FallenFireGit/F405-FC/review/gate-0-power-reaudit-2.md

# Gate 0 re-audit 2 (third round): F405-FC power design

Auditor: fresh, independent Gate 0 power re-auditor, 2026-10-11. I did not write either earlier report. I did not modify any
other file and did not commit.

**Audited:** `design/power.md` (whole file, with a focus on 0, 2.1-2.2, 3.4, 4, 7-9, 12, 13 and 14), `design/decisions.md` (D-03, D-07,
D-11, D-12, D-14, D-16), the power parts of `design/circuit.py` (lines 44-74 and 203-278, plus the 3V3 decoupling, J3/R41, D4 and
D7-D9 at lines 296-461), the committed netlist `kicad/F405FC.net` (power nets only), the U4 and 3V3 cap positions in
`kicad/F405FC.kicad_pcb`, and `gen/power_calc_lmr.py`. The netlist matches circuit.py for every refdes I checked (C1-C24, C29, R41,
D4/D5/D7/D8/D9/D10).

**Method:** I extracted `lp38692.pdf`, `lp5907.pdf`, `lmr38020.pdf` and `JST_SH_eSH.pdf` with `pdftotext -layout` into the scratchpad.
`JST_SH_eSH.pdf` is image-only, so no text came out. Nothing from `datasheets/` was executed. I parsed the netlist and PCB with my own
`python3 -I` snippets and recomputed the thermal arithmetic with `scratchpad/calc/r3.py`. That script uses the same loss model as
`gen/power_calc_lmr.py` (RDS hot ×1.45, 10 ns edges, 30 mW drive, IRMS²·DCR + 50 mW core), adds a dropout branch, and charges the
3V3 domain as 4.76 V × I(3V3) (LDO drop plus the loads). Anything I could not check against a document on file is marked
**unverified**.

## Sources

| Ref | Document | Used for |
|---|---|---|
| [LP38] | TI LP38692 SNVS322M, `datasheets/lp38692.pdf` | 8.2.1 Table 1 (COUT 1 µF, ESR 5-500 mΩ); 8.2.2.2.2 (ESR 5-500 mΩ "for stability"); 8.2.2.2.4 (0.7 µF minimum effective; a 1 µF ceramic is typically 20-40 mΩ); EC header (CIN = COUT = 10 µF); 10.4 (loop bandwidth < 100 kHz; above that, only the output caps set the output impedance; inductance between COUT and the load is recommended) |
| [LP59] | TI LP5907 SNVS798Q, `datasheets/lp5907.pdf` | 5.6 "Output and Input Capacitors" (COUT 0.7-10 µF effective). The thermal table is 5.4, not 5.6 |
| [LMR] | TI LMR38020 SNVSC40E, `datasheets/lmr38020.pdf` | 7.5 (IHS-LIMIT 2.6/3.2/3.8 A, ILS-LIMIT 1.8/2.3/2.8 A); 8.3.8 (hiccup, 76 ms); Eq. 7 |
| Not on file | Yageo RC0805 jumper ratings, JST SH current rating (the PDF is an image), USBLC6-2 VBUS clamp, Samsung DC-bias curves, SMBJ26A, Würth WE-MAPI, DS8626 | Claims that rest on these are marked unverified |

## Disposition of open findings

| ID | Prev. sev | Disposition | Evidence |
|---|---|---|---|
| P1-01 | MAJOR | **RESOLVED.** The residual consistency gaps are downgraded to MINOR as P2-01 and P2-02 | (a) The bench envelope is now "VTX off or pit mode, LED strip off, cameras allowed" (power.md:441-442). At **typical** loads it fits ≤ 1 W (recomputed 0.86-0.93 W). At the design-budget loads it does not (P2-01). (b) The 3V3 domain is now in P_board (power.md:424-425, 405-406). (c) The gate is ambient-referenced and runs at 2S and 6S (power.md:446-449). (d) The -T7 option is withdrawn and the 85 C sensors are named (power.md:443-444; decisions.md:98-99). (e) The "104 C" headline is gone from power.md:38-39, D-03 (decisions.md:35) and R2 (power.md:497). The 12.5 rows check out: R_board-air = 1/(h·2·12.96 cm²) = 38.6/25.7/9.6/4.8 K/W for h = 10/15/40/80. Rows 1-5 (power.md:429-433) reproduce to ±1 C from the stated P_board and P_U1. With the 12.2 per-component losses, my recomputed worst-case P_board is 3.27 W (6S) and 3.58 W (2S), against the stated 3.9 W. So the table is conservative (see P2-06) |
| P1-02 | MINOR | **RESOLVED** | power.md:215-216 now defers to R7 ("25 V output capacitors may be overstressed"). The sentence is garbled: "(R7). (The TPS22810 is gone), and HD VTXs…" (INFO, P2-07) |
| P1-03 | MINOR | **RESOLVED** | R41 0R 0805 sits between 10V and the new net VTX_PWR → J3.1 (circuit.py:430-436). In the netlist, VTX_PWR = {J3.1, R41.2} and 10V includes R41.1. D-16 is at decisions.md:119-122 and power.md:190 says "Remove R41" for 2S HD builds. The current rating is in P2-05 |
| P1-04 | MINOR | **Mostly RESOLVED; residual folded into P2-04** | Fixed: (a) power.md:487-488 now lists D4/D5/D9 as PMEG4030ER and D7/D8 as BAT54S-7-F, matching circuit.py:421, 447-461. (c) The LDO COUT is CL10A225KO8NNNC in both power.md:274 and circuit.py:256 (C20). (d) The LP5907 COUT is CL10B225KO8NNNC X7R in both power.md:287 and circuit.py:264 (C23). (e) The C4u7 string is fixed. Residual: power.md §1.2 refdes (P2-04) |
| P0-03 | MINOR | **OPEN (MINOR), one line left** | power.md:32-37, 132 and 174 now qualify the nominal 1.96-2.20 A and 2.11-2.13 A figures and state the ≥ 1.87 / ≥ 1.78 A floors. decisions.md:36 (D-03) still reads "give a **guaranteed** 1.96-2.20 A (5 V) and 1.97-2.13 A (10 V)", which contradicts decisions.md:38 and power.md:34-35. Tracked in P2-04 |
| P0-04 | MINOR | **RESOLVED (numbers)**; residual INFO P2-07 | power.md:126-127 now gives regulation down to 6.25-6.4 V at 1.8 A. I recompute 6.27-6.41 V for DMAX 0.963/0.943 with RDS,HS,hot + DCR = 0.514 Ω, and the doc's 4.76-4.87 V at 6.0 V, ±0.03 V. power.md:127 says the script models 100 % duty and that the 97 % figures are authoritative. Not done: `gen/power_calc_lmr.py` is unchanged since f0e1ac8 (100 % duty; "R~5 ohm" comment at its end), and power.md:6 still says "All rev B numbers come from gen/power_calc_lmr.py" |
| P0-05 | MINOR | **RESOLVED / ACCEPTED-DEVIATION (D-14)**; (b) stays unverified (INFO) | (a) D-07 (decisions.md:68) now says TPD2E2U06 is **not** acceptable. (c) Inrush is logged as D-14 (decisions.md:105-109; power.md:314-317). My recount from the current netlist: VBUS 1 µF, 5V_SYS 6.7 µF, 3V3 12.6 µF (C20 2.2 + C29 4.7 + C47 4.7 + 10 × 0.1), 3V3A 1.1 µF, 3V3_IMU 4.71 µF ≈ **26 µF / ≈ 97 µC** nominal. That is still above 10 µF / 50 µC, so D-14's "≈ 30 µF / 110 µC" is slightly high but reaches the same conclusion. (b) The USBLC6 VBUS clamp level against the LP5907's 6 V abs max is still **unverified**: no PDF on file |
| G1P-01 | MINOR | **ACCEPTED-DEVIATION (D-14)** | As P0-05(c). power.md:314-317 no longer claims compliance |
| G1P-02 | MINOR | **RESOLVED as requested** (power.md 7 corrected, bring-up load-step check added at power.md:274-277). The new rationale is physically wrong: **P2-03 (MINOR)** | The circuit now has a single 2.2 µF X5R at the LDO (C20, circuit.py:256), and the old C21 100 nF is retired (circuit.py:257). [LP38] 8.2.2.2.2/8.2.2.2.4: ≥ 1 µF (0.7 µF effective), ESR 5-500 mΩ, so C20 alone complies. The 3V3 net still carries C29 and C47 (2 × 4.7 µF X5R) and 10 × 100 nF |
| G1P-03 | MINOR | **RESOLVED** | circuit.py:70 now reads "4.7uF X5R 16V" for CL10A475K**O**8NNNC. Netlist C18/C29 agree |
| G1P-04 | MINOR | **Partly RESOLVED; residual OPEN (MINOR) as P2-04** | Fixed: LDO caps (power.md:274, 287), VBAT R_bot 0402 (power.md:331), §13 refdes for D4/D5/D9, D7/D8 and C4/C12. Still wrong: §1.2 (power.md:103-104). §3.2/§13 do not reflect the C17 change. R41 is missing from §13 (P2-04) |

Carried INFO items from earlier rounds: P0-14 (no GPS series resistors; logged in D-15) and P1-05 (U12 Ioff, unverified) are
unchanged. P0-16 is unchanged: power.md:110 says "35 V min" bulk against the 42.1 V clamp, and power.md:148 says 5.28 V is "inside
WS2812 VDD max 5.3 V". P0-17/G1P-07 is still missing from §14: R7 covers only the U2 high-side short, not the U1 short that would put
VBAT onto 5V/5V_SYS/LP5907. P1-06 is RESOLVED (power.md:414-415). G1P-05 is RESOLVED (C39 = CL10B225, circuit.py:346). G1P-06 is
RESOLVED in the circuit (C17 = 100 nF 100 V X7R 0603, circuit.py:237, netlist C17), but the doc lags (P2-04).

## Checks of the revisions that passed

| Item | Evidence | Result |
|---|---|---|
| 12.5 arithmetic | R_board-air 25.7-38.6 K/W still air, 4.8-9.6 K/W in flight (doc: 25-38 / 5-10). Row 1: 3.9 W → 19-38 K, T_board 69-88 C, U1 +26 C → 95-114 C (doc 70-89 / 96-115). Row 2: 3.0 W → 14-29 K (doc 15-30). Row 3: 2.0 W → 10-19 K (doc 10-20). Row 4: 1.0 W at 25 C → 51-64 C (doc 50-63). Row 5: 1.9 W → 49-73 K (doc 48-72). My independent "HD VTX 1 A + LED off" bench case is 1.96 W | PASS (rounding only) |
| Hot-day envelope equivalences (power.md:440) | Recomputed P_board: LED ≤ 0.4 A → 3.04 W (2S) / 2.85 W (6S); VTX ≤ 1.2 A → 3.16 W (2S) / 2.94 W (6S). Both are within about 0.15 W of 3.0 W, which is inside the model's uncertainty, and the doc's 3.9 W baseline is conservative | PASS (INFO in P2-06) |
| Gate arithmetic | MCU case − Ta ≤ 30 K → ≤ 80 C at Ta 50 C; U1/U2 case − Ta ≤ 50 K → ≤ 100 C at Ta 50 C (power.md:446-449). Covers 2S (U2 in dropout) and 6S | PASS (consistency with the envelope: P2-02) |
| LP38692 single 2.2 µF COUT | [LP38] 8.2.2.2.2: ≥ 1 µF, ESR 5-500 mΩ. 2.2 µF 16 V X5R 0603 at 3.3 V keeps well over 0.7 µF effective (DC-bias curve **unverified**). Load transients: the loop bandwidth is < 100 kHz ([LP38] 10.4), so steps are carried by the whole 3V3 bank (≈ 12.6 µF nominal), not by C20 alone. A 100 mA step for 5 µs gives about 50 mV, which is acceptable | PASS on value. See P2-03 for the stability argument |
| LP5907 COUT | C23 2.2 µF X7R + C38/C40-C42 + C39 2.2 µF X7R = 4.71 µF nominal on 3V3_IMU, inside 0.7-10 µF ([LP59] 5.6) | PASS |
| R41 dissipation | Yageo RC jumper maximum 50 mΩ (**unverified**, no Yageo PDF): 1.5² × 0.05 = 0.11 W in an 0805. In a VTX short, U2 is valley-limited (ILS max 2.8 A + ΔIL/2, [LMR] 7.5/Eq. 7) and then hiccups (76 ms off, [LMR] 8.3.8), so overcurrent through R41 is brief | PASS (rating unverified; the contact limit is in P2-05) |
| C17 | 100 nF 100 V X7R 0603 GRM188R72A104KA35D on 10V (netlist C17) | PASS |
| Abs-max and back-feed states | Unchanged from the earlier round apart from R41 (series 0R on a 10V branch: no new path). With R41 removed, VTX_PWR floats and J3.1 cannot tie VBAT to 10V | PASS |

## New findings (P2-xx)

| ID | Sev | Finding | Evidence | Fix |
|---|---|---|---|---|
| P2-01 | MINOR | **The "≤ 1 W" bench rule is met only at typical loads, not at the loads the bench envelope allows.** The envelope allows VTX off, LED off and "cameras allowed". At the design budget (3V3 0.17 A, RX 0.15 A, 2 cams 0.4 A, GPS 0.1 A) I recompute P_board = **1.38 W (2S) / 1.40 W (6S)**: U1 0.28-0.30, L1 0.10, 3V3 domain 0.86, D5 0.11. Still air gives a rise of 36-54 K, so T_board is **61-79 C at Ta 25 C** and reaches 85 C at Ta ≈ 31 C at the upper estimate. At typical loads (3V3 0.125 A, RX 0.08 A, ≤ 1 camera) it is 0.86-0.93 W, which matches the 1.0 W row. This is not a rating violation at Ta 25 C, but the rule and the row disagree | power.md:39, 432, 441-442; decisions.md:97-99; scratchpad `calc/r3.py` | Either state the bench rule as "≤ 1.4 W at budget loads, Ta ≤ 30 C" or restrict the bench envelope (e.g. one camera, or cameras off on HD builds). Say that the 1.0 W row uses typical loads |
| P2-02 | MINOR | **The gate and the envelope assume different ambients.** The gate (full load, 3 m/s fan) passes only if MCU case − Ta ≤ 30 K, which is the condition for full load at **Ta 50 C**. The envelope already limits full load to Ta ≤ 35 C, where a rise of up to about 39-45 K would be acceptable, and limits Ta 35-50 C to P_board ≤ 3.0 W. The doc's own upper estimate at 3 m/s (h ≈ 40, 9.6 K/W) predicts a **37.6 K** rise at 3.9 W (my recompute: 31-35 K at 3.3-3.6 W). So the model predicts the gate will fail, and the prescribed response, "lower the LED-strip budget until it passes", would cut the full-load budget even for Ta ≤ 35 C, where the envelope says it is fine. The gate also never tests the 3.0 W hot-day point. This errs on the conservative side; there is no safety hole | power.md:421-422, 429-430, 439-449 | Make the gate two-point. (1) Full load: MCU case − Ta ≤ 45 K (≤ 80 C at Ta 35 C). (2) At the 3.0 W hot-day configuration: MCU case − Ta ≤ 30 K. Or keep the single criterion and change the envelope to "full load up to Ta 50 C if the gate passes". On failure, adjust the envelope's ambient split before cutting the budget |
| P2-03 | MINOR | **The LP38692 stability rationale in power.md 7 is not physically valid, and there is no fallback if the bring-up check fails.** power.md:274-277 argues that the remaining 3V3 decoupling is "≥ 10 mm away behind trace inductance". At the regulator's loop crossover (< 100 kHz, [LP38] 10.4), 10-15 mm of trace or plane is a few nH, which is about 3-6 mΩ at 100 kHz. That is negligible next to the caps' reactance, so the loop still sees the whole ≈ 12.6 µF bank, including C29 and C47 (2 × 4.7 µF X5R, low single-digit mΩ ESR). The aggregate-ESR situation G1P-02 described is therefore unchanged; C47 was in fact added since then (G1S-04). Removing the 10 µF only removed local transient reserve. The claim "no other capacitor within ~10 mm" is also untrue on the current PCB: C26 (100 nF, F.Cu) is 2.7 mm from U4. Mitigating: TI's own EC conditions use COUT = 10 µF ceramic ([LP38] EC header), so instability is unlikely. The bring-up load-step check stays the only control, and the board has no option to fix a failure without a respin | power.md:274-277; circuit.py:256, 301, 368; PCB: U4 (124.6, 107.0) B.Cu, C20 6.3 mm, C26 2.7 mm, C47 12.6 mm, C29 20.0 mm; [LP38] 8.2.2.2.2, 10.4 | Rewrite the rationale. The real arguments are that TI characterises the part with a 10 µF ceramic, and that trace or plane **resistance** (not inductance) adds some ESR to the remote caps. Make the 10-150 mA step test a pass/fail bring-up item, and either add a DNP 0402 footprint for a 0.1-0.47 Ω series R ahead of the remote bulk (C29/C47) or log the residual risk in decisions.md |
| P2-04 | MINOR | **Remaining doc/refdes drift between power.md and circuit.py (the source of truth), plus one stale "guaranteed".** (a) power.md:103 "C2+C2b / C3+C3b": the netlist has C2, C3 (U1) and C10, C11 (U2); there are no "b" refdes. (b) power.md:104 "C4 / C5" for the 100 V HF caps: they are C4 and C12, and C5 is U1's 16 V BOOT cap. (c) After the G1P-06 change, the 10 V HF output cap is C17 100 nF **100 V 0603**, but power.md:178 still says "100 nF 0402 HF", and §13 (power.md:474, 476) lists the 100 V part with qty 2 (C4, C12) and "Cboot, HF out" 16 V 0402 with qty 4. The correct counts are 3 (C4, C12, C17) and 3 (C5, C13, C9). (d) R41 (0R 0805 RC0805JR-070RL), a new part in the 10 V power path, is missing from §13. (e) decisions.md:36 (D-03) still says "guaranteed 1.96-2.20 A … 1.97-2.13 A" (P0-03 residual) | as cited; netlist C2/C3/C10/C11/C4/C12/C5/C9/C13/C17/R41 | Regenerate §1.2/§3.2/§13 from circuit.py; reword D-03 line 36 as "nominal (≥ 1.87 / ≥ 1.78 A worst case)" |
| P2-05 | MINOR | **J3 pin 1 (and so R41) is limited by the JST-SH contact, not by R41's 2 A.** power.md:222 rates a JST-SH power pin at 1 A (the JST PDF on file is image-only, so this is **unverified** here). The 10 V rail budget is 1.5 A (power.md:376), and D-03 says "typical HD VTXs draw 0.8-1.2 A at 10 V" (decisions.md:38). An HD VTX above 1 A on the stock harness overloads the J3 contact. R41's "0R 2A" value (circuit.py:47) rests on the Yageo RC0805 jumper rating, which is not on file (**unverified**). Neither power.md §5, §13 nor D-16 states the J3 current limit | circuit.py:47, 430-436; power.md:222, 227, 376; decisions.md:38, 119-122 | State in power.md §5/§12.1 and in the user guide that J3 pin 1 is good for ≤ 1 A, and that VTXs above 1 A must be wired to P3/P4 (10V/GND pads). Add the Yageo RC jumper datasheet to `datasheets/` at Gate 2 |
| P2-06 | INFO | **12.3/12.5 P_board decomposition double-counts the LDO drop and takes 3V3 loads at typical values.** power.md:405 includes the LDO's 0.25 W in the 3.3 W power-stage figure, and power.md:425 adds a "3V3 domain ≈ 0.5-0.6 W" that again includes "the LDO drop (0.25 W)". At budget the 3V3 domain is 4.76 V × 0.18 A ≈ 0.86 W. The errors roughly cancel: the corrected worst case is 3.27-3.58 W, against the stated 3.9 W, so the table stays conservative | power.md:405-406, 424-425 | Restate it as power stage (excluding the LDO) ≈ 3.05 W + 3V3 domain (including the LDO) ≈ 0.86 W |
| P2-07 | INFO | **Stale or loose text.** (a) D-12 (decisions.md:97) "3.3 W worst-case loss": the board total is now 3.9 W. (b) R8 (power.md:506-507) asks to "confirm the 5 V rail's case temperature on the bench at 1.8 A", which conflicts with the bench rule; it should point to the fan gate. (c) power.md:394-395 (12.2: "effective RθJA … nearer 43 C/W", "every case below 150 C") reads as a conclusion; label it as large-board only. (d) power.md:6 says all numbers come from the script, which contradicts power.md:127; the script's "R~5 ohm" comment is still not a datasheet value. (e) power.md:287 cites LP5907 "section 5.4" for the COUT range; it is 5.6 ([LP59]). That line also omits C39 (2.2 µF) from the IMU-side sum (still 4.71 µF ≤ 10 µF). (f) power.md:215-216 sentence is garbled. (g) D-14's 30 µF / 110 µC is now ≈ 26 µF / 97 µC. (h) R41's 0.11 W is not in P_board (negligible). (i) The "bring-up guide" is referenced throughout but does not exist yet; the gates and checks in 12.5, 7 and 3.4 need to be carried into it | as cited | Clean up in the next doc pass |
| P2-08 | INFO | **Still unverified (no document on file):** Yageo RC0805 jumper current and resistance; the JST-SH contact rating; the USBLC6-2 VBUS clamp level against the LP5907's 6 V; Samsung DC bias for C20 (CL10A225KO8NNNC) at 3.3 V; SMBJ26A; Würth Isat/DCR; DS8626 thermal ratings | — | Add the PDFs and close at Gate 2 |

## Not verified (explicitly)

- Everything in P2-08. I did not run KiCad ERC, regenerate the schematic or run `design/circuit.py`. I used the committed
  `kicad/F405FC.net` and `kicad/F405FC.kicad_pcb` (commit bf896ee); the netlist matches the circuit.py refdes I checked.
- PCB distances are centre-to-centre footprint origins, not pad-to-pad, taken from the committed PCB (HEAD). While this audit ran,
  uncommitted work in progress moved U4 (placement.py:134). I re-measured on the working tree: C20 6.8 mm, C26 2.5 mm, C47 11.6 mm,
  so the P2-03 conclusions are unchanged. The same WIP also changed the HSE load caps in circuit.py/decisions.md D-07, which is
  outside the power scope. I did not check copper routing or thermal-via presence.
- The 12.5 thermal model and my recompute are estimates. Only the bring-up gate can validate them.

## Verdict

**PASS**: 0 BLOCKER and 0 MAJOR open. P1-01 (MAJOR) is resolved; its residual consistency gaps are MINOR (P2-01, P2-02).
P1-02, P1-03, G1P-03 and P0-04 (numbers) are resolved. P0-05 and G1P-01 are closed as the accepted deviation D-14. G1P-02 is
resolved as requested but has a MINOR follow-up (P2-03).

Open MINOR items: P0-03 (one line, folded into P2-04), G1P-04 (folded into P2-04), P2-01, P2-02, P2-03, P2-04 and P2-05.
Open INFO items: P2-06, P2-07, P2-08, P0-14, P0-16, P0-17/G1P-07 and P1-05.
