FallenFireGit/F405-FC/review/gate-0-power-audit.md

# Gate 0 audit: F405-FC power design (rev B)

Auditor: independent Gate 0 power review, 2026-10-11
Audited: `design/power.md` (rev B), `gen/power_calc_lmr.py`. Checked against `design/requirements.md`, `design/decisions.md`
(accepted deviations D-03, D-04, D-06) and `design/pinmap.md` rev C sections 6-7.
I did not modify the author's files. Every number marked "recomputed" comes from my own script
(`scratchpad/calc/audit.py`, not committed). It was run with `python3 -I`, and nothing from `datasheets/` was executed.

## Sources

| Ref | Source | How used |
|---|---|---|
| [LMR] | TI LMR38020 SNVSC40E (Sep 2023), `datasheets/lmr38020.pdf` (pdftotext) | 7.1 abs max, 7.3, 7.4 thermal, 7.5 EC, 7.6 (DMAX footnote), 8.3.3, 8.3.6, 8.3.8 (Eq. 7, IL-NEG), 8.4.2, 8.4.3, 9.1 note (effective C), 9.2.2.4-9.2.2.8, Table 8-1, Table 9-1 |
| [LP38] | TI LP38692 SNVS322M, `datasheets/lp38692.pdf` | 6.1 (12 V abs max), 6.3 (Tj op 125 C), 6.4 (RθJA 68.5, ψJB 12.8), 6.5 dropout, 8.1.1, 8.2.2.2 |
| [LP59] | TI LP5907 SNVS798Q, `datasheets/lp5907.pdf` | 5.1 (VIN abs max 6 V), 5.3/5.4 (COUT 0.7-10 uF eff., ESR 5-500 mΩ) |
| [PMEG] | Nexperia PMEG4030ER, `datasheets/PMEG4030ER.pdf` | Table 6 (Rth 130 K/W at 1 cm²), char. table (VF 295/330 mV at 0.1 A, 380/440 mV at 1 A, IR) |
| [PMV] | Nexperia PMV40UN2, `datasheets/PMV40UN2.pdf` | VGS(th) 0.4-0.9 V, RDSon 44 mΩ at 4.5 V / 53 mΩ at 2.5 V max, VGS ±12 V |
| [NX] | Nexperia NX7002AK, `datasheets/NX7002AK.pdf` | VGS(th) 1.1-2.1 V, RDSon 5.2 Ω max at VGS 5 V (no 3.3 V spec), Ciss 20 pF max, VDS 60 V |
| [TS5A] | TI TS5A3159A, `datasheets/TS5A3159A_DS.pdf` | 6.1: VI (digital) -0.5..6.5 V regardless of V+, analog pins ≤ V+ + 0.5 V; VIH 2.4 V at V+ 5 V |
| [BF] | Betaflight 4.5 `sound_beeper.c:85`, `drv_pinio.c:51-71` | beeper and PINIO polarity |
| [WE] | Würth WE-MAPI 74438357068 / 74438357082 datasheets. **I could not read them directly** (we-online.com: DNS failure in WebFetch, proxy 403 in curl). Figures come from web-search result snippets of `we-online.com/components/products/datasheet/74438357068_valid_from_2026-09-01.pdf` and `.../74438357082.pdf`, plus RS/Octopart listings | Isat (flagged unverified) |
| Not on file | Littelfuse SMBJ26A PDF, DS8626 (STM32 IINJ), Murata/Samsung DC-bias curves, Würth PDFs | Claims that depend on these are marked unverified |

## Verification results (passed, with recomputed numbers)

The design script `python3 -I gen/power_calc_lmr.py` ran cleanly. Its output matches the tables in `power.md` 2.x, 3.x and 12.2.

| Item | Recomputed | Verdict |
|---|---|---|
| RT / fSW | Eq. 2: 34.53 k → 34.8 k is the Table 8-1 value for 750 kHz. EC: 430-650 kHz at 49.9 k (−18 %/+24 %), plus ±8 % SS → 565-1003 kHz | PASS |
| tON-min foldback | 5 V at 42.1 V: tON = 162 ns > 131 ns at nominal f. At fmax 1003 kHz, foldback starts at 38.9 V, which is benign (frequency drops) | PASS (power.md:118 "no foldback below 51.9 V" holds only at nominal f; INFO) |
| tOFF-min foldback | Eq. 6: 5 V 6.60 V, 10 V 13.02 V (tOFF 300 ns max) | PASS |
| Eq. 11 sub-harmonic | LMIN 1.71 uH (5 V), 3.36 uH (10 V). At fmin 565 kHz: 2.26 / 4.46 uH, still below L−20 % = 5.44 / 6.56 uH | PASS |
| Ripple / peak (nominal) | 5 V: 0.31 A at 7.4 V, 0.80 A at 25.2 V (K = 0.40 of 2 A). 10 V: 0.66 A at 16.8 V, 0.98 A at 25.2 V (K = 0.49). Ipk at budget: 2.20 A (5 V, 6S), 1.99 A (10 V, 6S). Worst tolerance (L−20 %, fmin): 2.46 / 2.32 A | PASS against the 9.2.2.4 hard rule (Isat ≥ full-load peak). K for 10 V is above TI's 20-40 % guideline: INFO |
| Output caps | Table 9-1 gives **rated** values: 5 V, 400 kHz: 3 × 22 uF nominal / 2 × 22 min; 1 MHz: 2 × 22 / 2 × 15. Design has 3 × 22 uF rated on each rail, which meets or exceeds this. 12 V row: 1 × 22 (400 kHz). Ripple ≈ ΔIL/(8 f C) ≈ 3-6 mV | PASS (effective-C figures 14 uF/9 uF per part are unverified; no Samsung curve on file) |
| FB dividers | 5 V: 100 k/24.3 k → 5.115 V (4.958-5.276 V incl. ±1 % R and ±1.5 % FPWM VREF). 10 V: 100 k/11.0 k → 10.091 V (9.76-10.43 V) | PASS |
| EN / UVLO | VON 4.41/5.01/5.61 V, VOFF 3.81/4.41/4.89 V (min/typ/max). Internal VIN UVLO 4.2 V start is below VON max | PASS |
| EN abs max (VIN + 0.3 V) | EN = 0.249 × VIN in every state (6.28 V at 25.2 V, 10.50 V at 42.1 V). **USB-only (VIN = 0): EN = 0** (resistive divider, and Q2 only pulls down; its body diode clamps EN ≥ −0.7 V). Q2 on: sinks 140 uA at 42.1 V, so EN < 0.95 V for any RDS < 6.8 kΩ. NX7002AK VGS(th) max 2.1 V against a 3.3 V gate leaves enough overdrive for 140 uA. Q2 VDS ≤ 10.5 V (60 V rating), VGS 3.3 V (±20 V) | PASS. The power.md:192 claim "< 5 Ω at VGS = 3.0 V" is not a datasheet number ([NX] specifies only 5.2 Ω max at 5 V), but the circuit has three orders of magnitude of margin |
| VTX_PWR_EN polarity | Gate pulldown 100 k → Q2 off → U2 on through reset/DFU/boot. BF `pinio_config 1 = 1` (OUT_PP, not inverted) → `IOLo` at init ([BF] drv_pinio.c:66-70) → VTX on. USER1 → high → VTX off | PASS (matches pinmap.md:269 and D-04) |
| BEEPER polarity | PB2 10 k pulldown → silent. `beeper_inversion = ON` → `IOWrite(io, onoff)` → high = on ([BF] sound_beeper.c:85). PMV40UN2: 53 mΩ max at 2.5 V, so it is fully on from 3.3 V. 0.53 mW at 0.1 A. Flyback clamps to 5V + VF | PASS |
| CAM_SEL | 100 k pulldown → CAM1. TS5A3159A VIH 2.4 V at V+ = 5 V (3.3 V GPIO meets it). IN abs max 6.5 V **independent of V+**, so it is safe when the switch is unpowered | PASS (supply rail unspecified, P0-13) |
| TVS vs parts on VBAT | VC 42.1 V (JEDEC table; SMBJ26A PDF not on file): LMR38020 VIN/SW 85 V, C1-C3 50 V, C4/C5 100 V, RENT 0603, VBAT divider, Q2 sees only EN (10.5 V). The 35 V transient requirement is met because VBR is 28.9-31.9 V | PASS (SMBJ26A values unverified locally) |
| VBAT ADC | ratio 11, full scale 36.3 V. Injection at 42.1 V: 0.25 mA. R_top 52 mW at 25.2 V | PASS (±5 mA IINJ from DS8626 is not on file: unverified) |
| CURR/RSSI | VBAT mis-wire: 2.16 mA through BAT54S, 47 mW in the 10 k. RC 1.59 kHz | PASS |
| LP38692 | Abs max 12 V, op VIN 10 V. Dropout at 3.3 V: 110 mV max at 0.1 A, 1000 mV max at 1 A → about 0.26 V at 0.25 A. P = 0.25 W at 0.17 A → Tj 67 C (68.5 C/W, JEDEC) | PASS for the device. Board heating: see P0-01 |
| LP5907 | 5V_SYS max = 5.28 V − VF ≈ 5.0-5.1 V, below 5.5 V op / 6 V abs. COUT 2.2 uF 0603 within 0.7-10 uF eff. 15 mW | PASS (steady state; transient see P0-05) |
| USB OR-ing / back-feed | D5 blocks USB → 5V → L1 → HS body diode → VBAT. D4 blocks battery → VBUS. With VIN = 0 the only path into the buck side is D5 reverse leakage (µA-scale), which is harmless. FPWM reverse current (IL-NEG −0.9 A, [LMR] 8.3.8/8.4.2) needs an output pulled above set-point. D5 prevents the on-board USB source from doing that, and when U2 is disabled it does not switch. VBUS 4.40 V (USB 2.0 low-power min) → 5V_SYS ≈ 4.07 V → LDO input ≥ 3.6 V OK | PASS |
| D5 thermal | 0.41 A × ~0.34 V = 0.14 W × 130 K/W = +18 C | PASS (at the stated Ta; board heating see P0-01) |
| Battery current | 6S worst: 1.06 A (doc 1.05). 2S at 7.4 V: 2.95 A (doc 2.9). 2S at 6.0 V with a 2 A VTX peak: 3.8 A | PASS (the doc is internally inconsistent, P0-10) |
| Power-entry pads (D-06) | 2.5 × 4 mm pads with 20-22 AWG, ≥ 1.5 mm 1 oz outer traces → adequate for 3.8 A | PASS |
| 5 V budget arithmetic | 0.41 + 0.80 + 0.40 + 0.10 + 0.08 = 1.79 A (includes the dropped OSD's 72.5 mA, so it is conservative) | PASS |
| Hot-plug (battery) | All VBAT parts are rated ≥ 50 V. EN tracks VIN resistively. Soft start 4 ms + OCP blanking 18 ms ([LMR] 8.3.9) | PASS. The external low-ESR bulk recommendation is appropriate |
| First power-up smoke check | I found no abs-max violation in the normal states: battery-only, USB-only, battery + USB, VTX off, reset/DFU | PASS |

## Findings

| ID | Sev | Finding | Evidence | Fix |
|---|---|---|---|---|
| P0-01 | **MAJOR** | **The thermal analysis does not support the "worst-case Tj 104 C" claim used to justify D-03.** (a) It applies a single-IC JEDEC RθJA (42.9 C/W, a 76 × 114 mm 2s2p board) to each IC separately, so the two ICs on a 36 × 36 mm board never heat each other. The doc's own board total is about 3.3 W. Board-level still-air estimate: 2 faces × 13 cm² × h 12-18 W/m²K (convection + radiation) gives **21-32 C/W board-to-ambient, so ΔT_board ≈ 70-106 C at 3.3 W**. Then Tj(U1) ≈ 50 + 70…106 + ψJB 13.8 × 1.26 ≈ **137-173 C (TSD 163 C)**, and the board itself reaches about 120-156 C. That exceeds the STM32F405RG**T6** 85 C ambient grade, the flash/IMU ratings and the LP38692's 125 C operating Tj. (b) The U2 **dropout loss on 2S/3S is omitted**: 1.5² × 0.303 × 1.45 ≈ 0.97 W (12.2 lists only 4S/6S for 10 V). (c) Switching loss assumes tr + tf = 10 ns total with no Coss, dead-time or Qrr term. For an 80 V-class integrated stage switching 25-42 V, 20 ns total is equally plausible: +0.17 W (6S) / +0.29 W (42 V) for U1. Coss at 100-200 pF adds 0.05-0.10 W. The RDS hot factor of 1.45 is reasonable for a typical Tj of 110-125 C (≈ 0.45 %/C), but it is applied to **typical** RDS (no max in the datasheet) | power.md:360-374, 385-386; decisions.md:34; power_calc_lmr.py:6, 9, 32 (TEDGE), 22-25 (no dropout loss); [LMR] 7.4, 9.2.2.9 ("values in Thermal Information are not valid for design purposes"); [LP38] 6.3 | State the airflow assumption explicitly: full budget only with prop-wash/forced air. Define a no-airflow budget (ground idle / bench, e.g. VTX in pit mode, LED ≤ 0.3 A) and put it in the user notes. Redo 12.2 as a board-level estimate (Pboard × Rboard + ψJB × Pic) including U2 dropout and a 20 ns edge sensitivity case. Make the Gate 1/bring-up thermal measurement (R8) a **pass/fail gate** at 1.8 A + 1.5 A on 2S and 6S. Optionally lower fSW to 400-500 kHz (a smaller switching term; L/C remain within Eq. 11 and Table 9-1) |
| P0-02 | **MAJOR** | **Requirement gap with no accepted deviation: the 10 V rail cannot reach 10 V on 2S or low 3S.** The requirements specify a 2-6S input (6.0-25.2 V) and a 10 V HD-VTX rail. D-03 accepts only the **current** derating. Recomputed with DMAX = tON-MAX/(tON-MAX + tOFF-MIN) = 0.943-0.963 ([LMR] 7.6 note 2): regulation needs **VIN ≥ 11.3-11.5 V** at 1.5 A. VOUT = **6.2-6.35 V at 7.4 V** and **7.2-7.3 V at 8.4 V** (full 2S), which is below the DJI O3's 7.4 V minimum even on a fully charged 2S pack. power.md 3.4 calls this a "documented limitation" but it is not in decisions.md | requirements.md:19-20; decisions.md D-03 (lines 30-40); power.md:174-179 | The lead must either log a deviation ("10 V rail regulates only for VIN ≥ 11.5 V; 2S HD-VTX unsupported") or add a hardware option: e.g. a solder jumper or DNP 0R from VBAT to the VTX connector/10V pad for 2S builds (with U2 EN held off), or a buck-boost |
| P0-03 | MINOR | **The Eq. 7 "guaranteed" output currents ignore L (±20 %), fSW (−18/+24 %) and spread spectrum (±8 %).** Worst-tolerance recomputation: 5 V **1.87-1.90 A** (2S / 42 V; the doc says 1.96-2.20) against the 1.79 A budget, a margin of only 0.08-0.11 A. 10 V at 25.2 V is limited by HS-limit-min minus ripple to **1.78 A** (1.57 A at the 42 V clamp), so D-03's "~2 A peak" and power.md's "1.97 A guaranteed floor" are not guaranteed. EC note 2: the limits are tested open loop | power.md:17, 33-35, 165, 355; decisions.md:35-37; [LMR] 7.5 (FOSC, ILS, IHS, note 2), Eq. 7 | Quote worst-case figures. Drop "2 A peak" or qualify it as "typical". Keep the 1.5 A continuous budget, which still holds (1.78 A) |
| P0-04 | MINOR | **Dropout model ignores DMAX** (it assumes 100 % duty). The 5 V rail holds regulation only down to **6.25-6.37 V** (doc 5.9 V) and gives 4.76-4.87 V at 6.0 V. The 10 V numbers are in P0-02 (doc 10.8 V / 6.6 V / 7.7 V) | power_calc_lmr.py:22-25; power.md:119-120, 175-177; [LMR] 7.6 note 2, 8.4.3 | Use VOUT ≈ DMAX·VIN − I·(D·RHS + (1−D)·RLS + DCR) with DMAX = 0.943 (tOFF max) |
| P0-05 | MINOR | **USB VBUS: capacitance and hot-plug transient.** D4 is forward-biased at plug-in, so the 5V_SYS bulk (10 uF) + LDO input caps, and through the LDOs the 3V3 network, all load VBUS. That is well over the 10 uF limit the doc itself states. There is no VBUS transient clamp. USB-cable hot-plug ringing on a 1 uF VBUS can overshoot well above 5.5 V, and the LP5907 (6 V abs max) sits only one Schottky drop downstream. The alternate ESD part TPD2E2U06 has no VBUS clamp at all | power.md:299, 269; decisions.md D-07 (USB ESD alternates); [LP59] 5.1 | Add a VBUS TVS/clamp sized so 5V_SYS stays < 6 V. Either accept and document the USB inrush non-compliance or limit 5V_SYS bulk. Pick the ESD part with a VBUS clamp |
| P0-06 | MINOR | **Input capacitance per IC is marginal.** [LMR] 9.2.2.6 requires ≥ 4.7 uF, and 9.1 says the values are **effective**. The doc's own estimate for the local 10 uF/50 V 1210 is about 4.5 uF at 25 V (less at a 42 V transient or when hot), so each IC relies on the shared entry cap C1. Murata DC-bias data is not on file | power.md:101-102; [LMR] 9.1 note, 9.2.2.6 | Use 2 × 10 uF/50 V 1210 per IC in the hot loop (or add a 2.2 uF/100 V), and keep C1 |
| P0-07 | MINOR | **Inductor Isat is not verified, and the "HS limit at or below Isat" claim is wrong under the usual 10 % definition.** Würth datasheet figures, from search snippets only (PDF not reachable): 74438357068 Isat(10 %) **3.5 A typ**, Isat(30 %) 7.2 A, IR 3.75 A, RDC 74 mΩ max. 74438357082 Isat(10 %) **3.35 A typ**, Isat(30 %) 6.8 A, IR 3.45 A, 86 mΩ. IHS-LIMIT max is 3.8 A, above Isat(10 %). Metal-alloy soft saturation makes this acceptable: worst full-load peak 2.46 / 2.53 A < 3.35 A, which meets the [LMR] 9.2.2.4 hard rule. D-05 and the BOM ratings (3 A / 2.8 A) disagree with the Würth PDF | power.md:126-128, 163-164, 411-412; decisions.md:52-54; [LMR] 7.5 IHS, 9.2.2.4 | Obtain the Würth PDFs at Gate 2 and confirm L at 3.8 A (≥ ~80 % of nominal). Correct the text and BOM ratings |
| P0-08 | MINOR | **The R7 residual-risk text is wrong:** a U2 high-side short puts VBAT (25.2 V; transients to the 42.1 V clamp) on the 10 V output caps, which are **25 V X5R**. "No on-board part can be damaged" (R7) is false (FB is OK at 4.17 V) | power.md:168, 199-200, 443; decisions.md:48 | Use 35/50 V caps on the 10 V rail (1210 or more parts), or correct R7 |
| P0-09 | MINOR | **The reverse-polarity statement is incomplete.** A reversed pack drives VIN to −VF(TVS) (volts at fault current), which violates the LMR38020 VIN abs min of −0.3 V. Current also flows GND → LS body diode → SW → HS body diode → VIN in **both** bucks, so they are likely destroyed along with the TVS, and the 5 V/10 V rails are pulled to about −0.7 V into every load. The requirements do not require reverse protection, but the doc says only the TVS is the casualty | power.md:90-91; [LMR] 7.1 | Correct the text. Optionally add a P-FET/ideal-diode at the input (not required) |
| P0-10 | MINOR | **Stale or inconsistent documentation in power.md and pinmap.md:** pinmap.md:54 says "PC15 = VTX_PWR_EN into the TPS22810 EN" and :55 "No … FET gates … on PC13-15", which contradicts rev C/D-04 (PC15 now drives Q2's gate). pinmap.md:94 calls the BEEPER FET "2N7002 class" (power.md uses PMV40UN2 and rejects 2N7002). power.md sections 0, 7 and 12 still budget the **AT7456E** (dropped, D-01). power.md:79 says "65 V IC" (TPS54360B leftover). power.md:214 says the 2S worst case is 3.6 A but :397 says 2.9 A. power.md:195 says Ciss "30-50 pF" ([NX]: 20 pF max). power.md:192 gives an RDS(on) "< 5 Ω at 3.0 V" that the datasheet does not specify | as cited | Clean up in the next revision. Polarity tables (pinmap §6) are correct |
| P0-11 | INFO | 10 V ripple K = 0.49 at 25.2 V and 0.62 at the clamp, above TI's 20-40 % guideline (9.2.2.4: use the device's 2 A). It is harmless here because the peak stays under Isat and ripple is about 6 mV | [LMR] 9.2.2.4 | None, or 10 uH |
| P0-12 | INFO | LP38692 COUT ESR window is 5-500 mΩ ([LP38] 8.2.2.2.2). A 10 uF 0805 X5R in parallel with the whole 3V3 decoupling network can sit at or below 5 mΩ. TI's own EC conditions use 10 uF ceramic, so the risk is low | power.md:262 | Bench-check 3V3 load-step ringing at bring-up |
| P0-13 | INFO | **The TS5A3159A V+ rail is not specified** in power.md or pinmap.md. IN is safe unpowered ([TS5A] 6.1). Analog pins must stay ≤ V+ + 0.5 V | decisions.md D-01; pinmap.md:68 | Specify V+ = 3V3 (always present with the MCU) |
| P0-14 | INFO | USB-only back-power: MCU UART TX/I2C pull-ups (3V3) feed the unpowered GPS (5V rail, G0-03), HD VTX (10 V off) and ESC MCUs through their input ESD diodes. Limited to mA, which is common practice, but the GPS can partly wake and stream into USART3 during DFU | pinmap.md:117, G0-03 | Optional series resistors (1 k) on GPS TX/RX; note it in bring-up |
| P0-15 | INFO | Battery hot-plug before 3V3 is up: PC0 injects ≤ 2.5 mA (25.2 V/10 k) into the unpowered VDD for the ~5-8 ms start-up. This is inside the claimed ±5 mA (DS8626 not on file) | power.md:88, 310-314 | None |
| P0-16 | INFO | The 5 V upper tolerance of 5.28 V is 20 mV under WS2812 VDD max 5.3 V before load-step overshoot. "Battery path wins" (power.md:139, 289) does not hold for VBUS ≥ 5.1 V, which is harmless. If the user powers the FC only via the ESC JST harness, the 6S worst case of 1.06 A exceeds the 1 A pin rating (D-06 covers this with pads). The external bulk "35 V min" is below the 42.1 V worst clamp (the doc already prefers 50 V) | power.md:105, 140, 214 | Documentation only |
| P0-17 | INFO | A U1 high-side short puts VBAT on 5V/5V_SYS → LP5907 (6 V) / LP38692 (12 V) and all 5 V loads fail. This is generic to any buck FC and not listed in the risks | power.md §14 | Add to the risk list |

## Not verified (explicitly)

- Würth Isat/IR (we-online.com unreachable; I used search snippets only).
- SMBJ26A electrical values (no PDF).
- MLCC DC-bias effective capacitance (no Murata/Samsung curves).
- STM32 IINJ and PC13-15 drive limits (DS8626 not on file).
- LMR38020 switching edge times and Coss (not published).
- The 50 mW inductor core-loss allowance.

## Verdict

**FAIL**: 2 MAJOR (P0-01 thermal basis, P0-02 10 V rail on 2S/3S with no logged deviation), 8 MINOR, 7 INFO. No BLOCKER: I found no
abs-max violation or back-feed path in the normal states (battery, USB-only, both, VTX off, reset/DFU). Nothing should smoke at first
power-up.
