FallenFireGit/F405-FC/review/gate-6-betaflight-redteam.md

# Gate 6 red team: Betaflight bring-up walkthrough (paper)

Reviewer: fresh, independent, adversarial agent. Date 2026-10-13. Scope: flash, pin/resource map, timers/DMA, gyro alignment,
USB-only power, INAV consistency. This is a review only: no file under design/, gen/, kicad/, lib/, bom/, fab/ or docs/ was changed.

## Verdict: **FAIL** (0 BLOCKER, 2 MAJOR, 7 MINOR, 7 INFO)

I found nothing in the hardware or in the Betaflight resource/timer/DMA map that would stop the board from flashing or flying.
Every `resource` line matches the netlist and the PCB pads. The DMA plan has no conflicts. **Both provisional gyro alignments
come out correct on paper.** The gate fails because of two MAJOR findings in the bring-up and user documentation. One makes the
first DFU flash fail as written. The other is a missing mitigation against hardware damage that `design/decisions.md` (D-15) says
is in place. Both can be fixed in the docs and silkscreen without any schematic change.

## Method (what was actually run)

| Check | How | Result |
|---|---|---|
| Schematic netlist | `kc 'kicad-cli sch export netlist -o /tmp/g6n.net kicad/F405FC.kicad_sch'`, parsed U3 pins 1-64 | All 64 pins match `design/pinmap.md` §9 and `circuit.py:287-298` |
| PCB pad nets | `kc 'python3 gen/padpos.py U3 …'` | U3 pads 1-64 carry the same nets as the schematic |
| Pin numbers | `datasheets/st_open_pin_data/F405RGTx.xml` positions 1-64 | Match the symbol (e.g. PA11=44, PA12=45, BOOT0=60) |
| AF numbers | Script over `GPIO-STM32F417_gpio_v1_0_Modes.xml` | PB0/PB1 AF2 TIM3, PB10/PB11 AF1 TIM2, PC8/PC9 AF3 TIM8, PA8 AF1 TIM1, PB7 AF2 TIM4, PA0 AF2 TIM5_CH1, all USART/SPI/I2C/OTG AFs as listed in pinmap §2 |
| Timer index / DMA options | `bf_src/timer_stm32f4xx.c:63-135`, `bf_src/dma_reqmap_mcu.c:380-470` | The TIMER_PIN_MAP occurrence indexes and every `dma` option in the config resolve to the streams in pinmap §3. No stream is used twice |
| CLI names | Every `set` name grepped in `bf_src/settings.c` / `parameter_names.h`; `dma` names in `cli.c:5322-5327`; resource names in `resource.c` | All exist. `gyro_to_use` / `gyro_2_*` need `USE_MULTI_GYRO`, which is on (`common_pre.h:364`) |
| Polarity | `sound_beeper.c` (systemBeep), `light_led.c:91-92`, `drv_pinio.c:40-80` | Beeper inverted = high for beep. LEDs low = on. PINIO idles low (VTX on), USER1 → high (VTX off) |
| Serial masks | `bf_src/serial.h:36-53` | 131073 = MSP+VTX_MSP, 64 = RX_SERIAL, 2 = GPS, 1024 = ESC_SENSOR |
| Gyro alignment | ICM-42688-P DS-000347 p.19 (Fig. 4) and p.53 (Fig. 15); BMI270 DS000-08 p.134 (pin-out) and p.144 (§8.2 table); U6/U7 pad coordinates from `padpos.py` | See §3: both configured values are correct |
| USB-only power | `circuit.py` nets 5V_SYS / 5V / VBUS / 3V3 / 3V3_IMU (netlist dump) | See §4 |
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
