FallenFireGit/F405-FC/docs/renders/p_fab_bottom.png

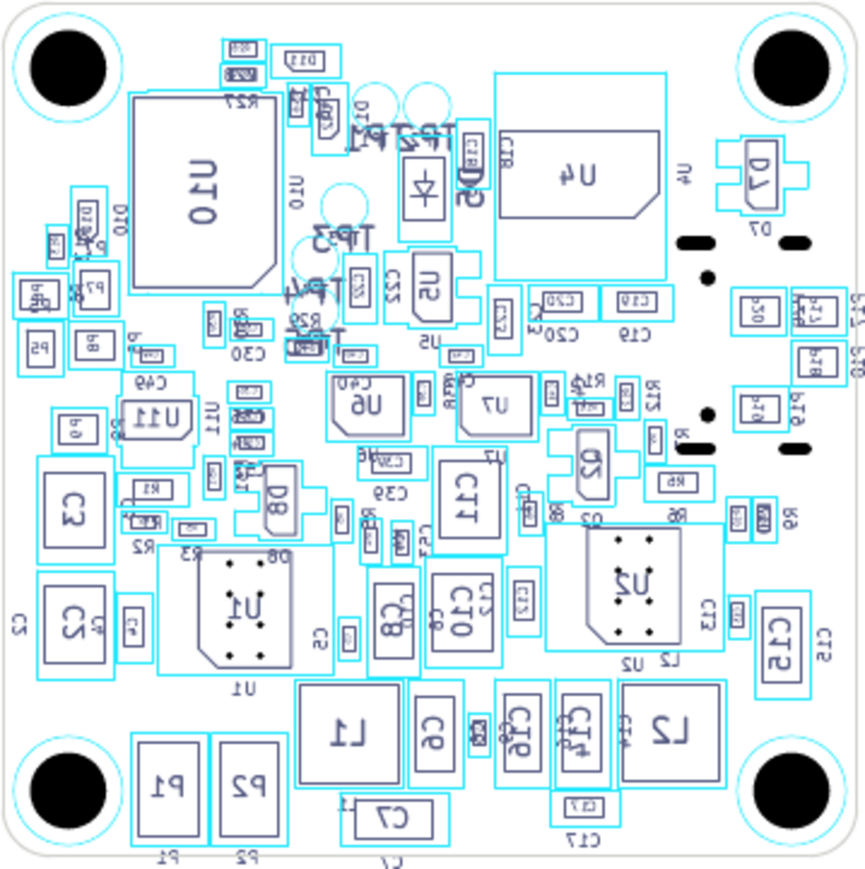
docs/renders/p_fab_bottom.png
