FallenFireGit/F405-FC/docs/renders/p_fab_top.png

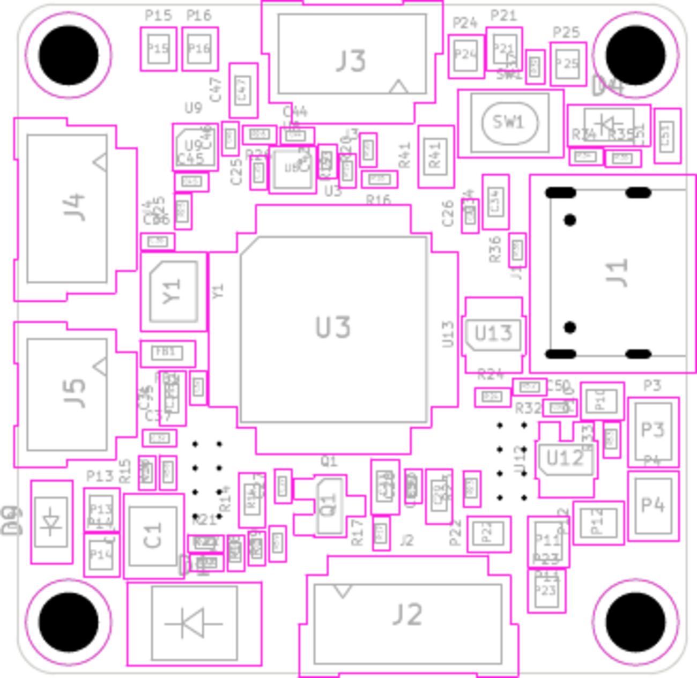
docs/renders/p_fab_top.png
