FallenFireGit/F405-FC/docs/renders/placement_bottom.png

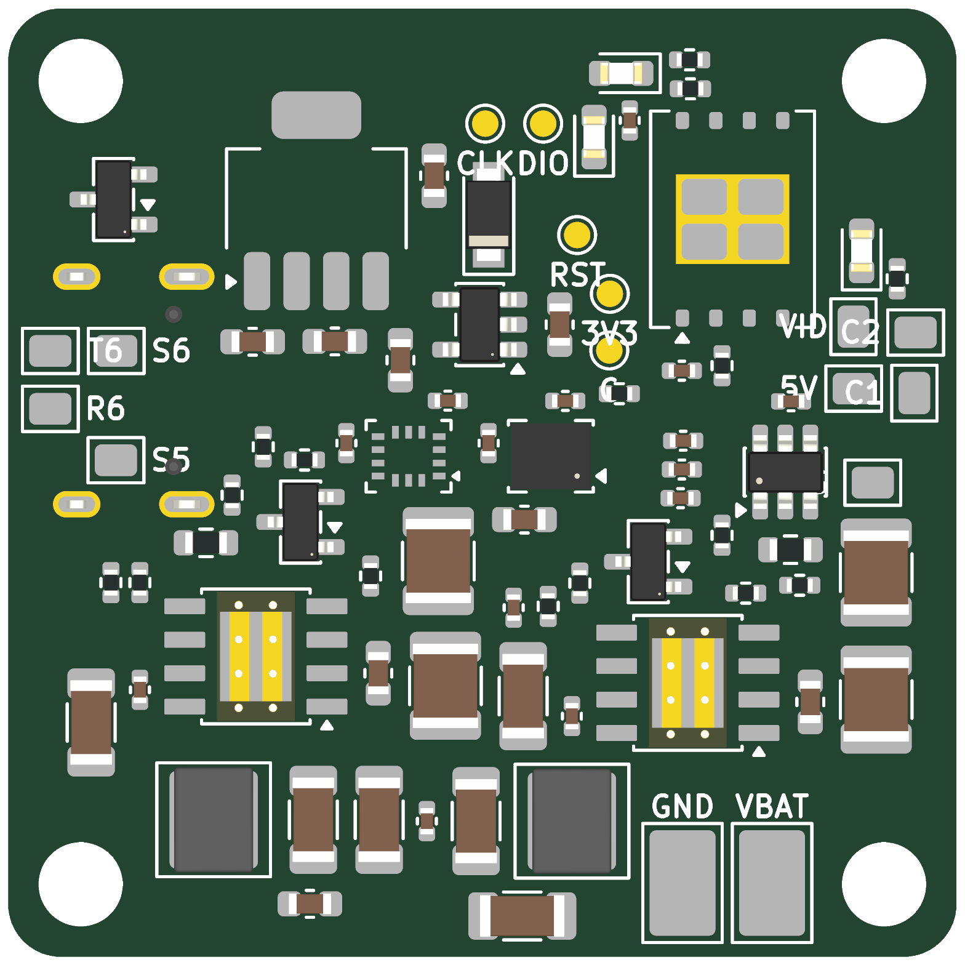
docs/renders/placement_bottom.png
