FallenFireGit/F405-FC/docs/renders/placement_fab_top.png

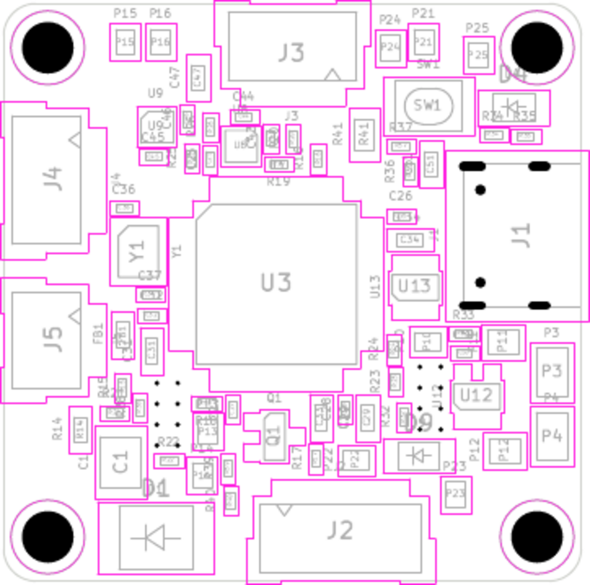
docs/renders/placement_fab_top.png
