FallenFireGit/F405-FC/docs/renders/placement_iso.png

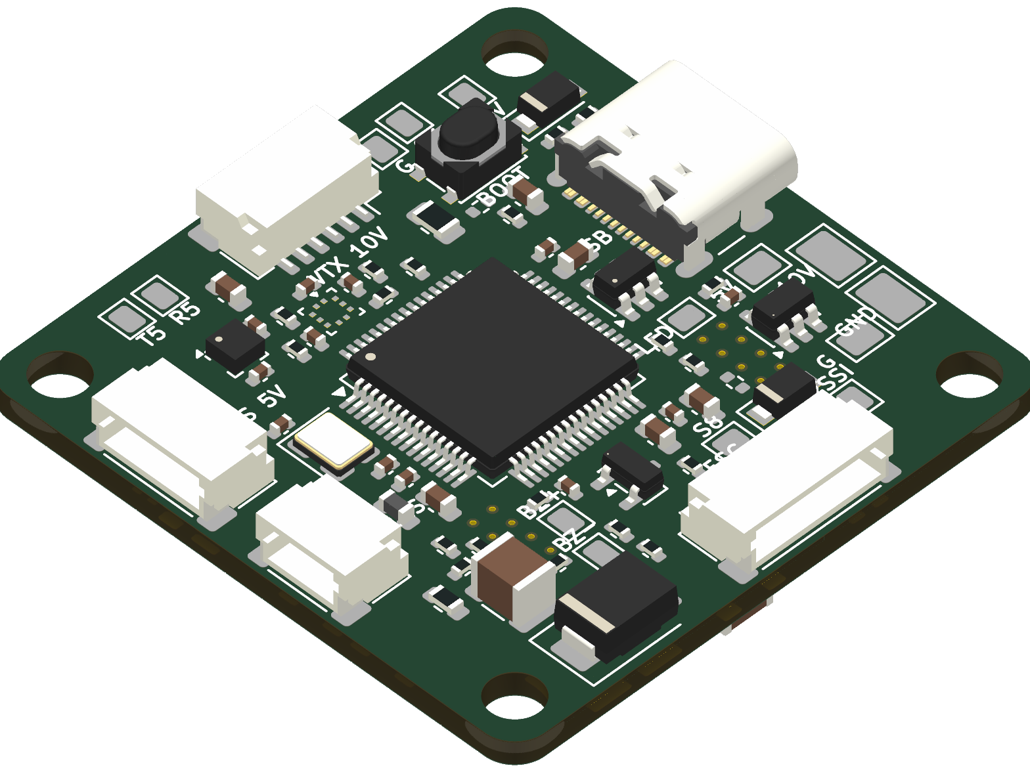
docs/renders/placement_iso.png
