FallenFireGit/F405-FC/docs/renders/placement_top.png

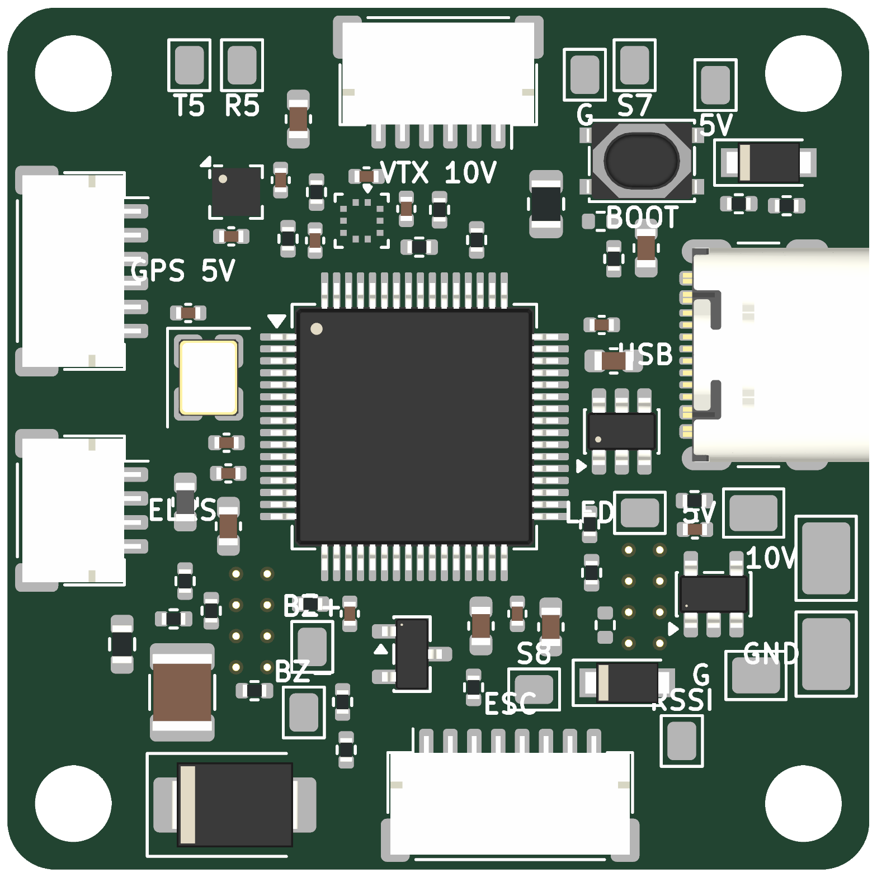
docs/renders/placement_top.png
