FallenFireGit/F405-FC/docs/renders/wip_bottom.png

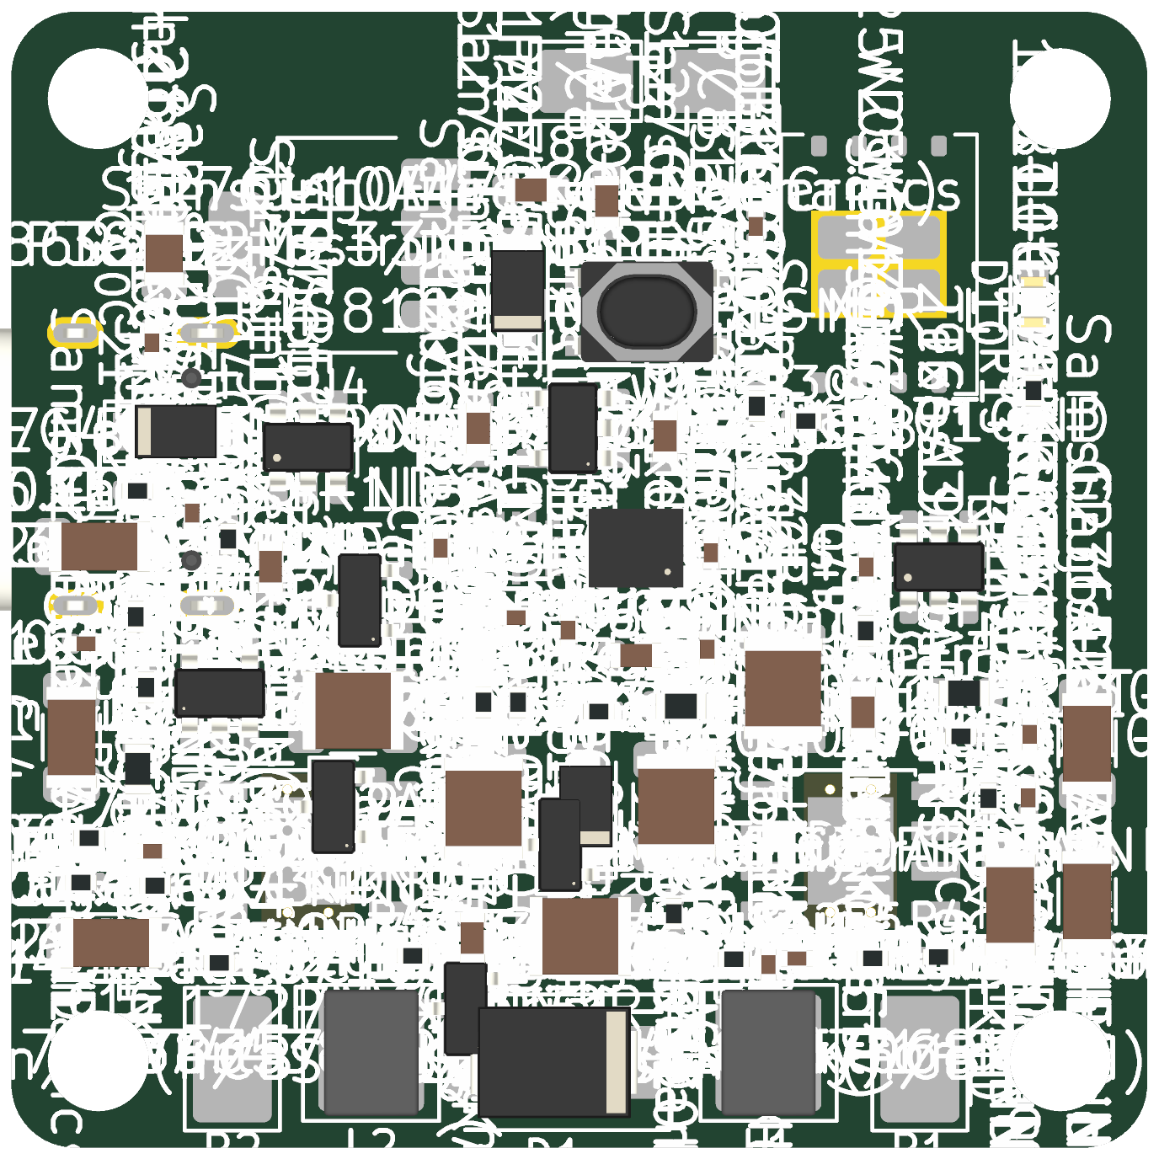
docs/renders/wip_bottom.png
