FallenFireGit/F405-FC/docs/renders/wip_top.png

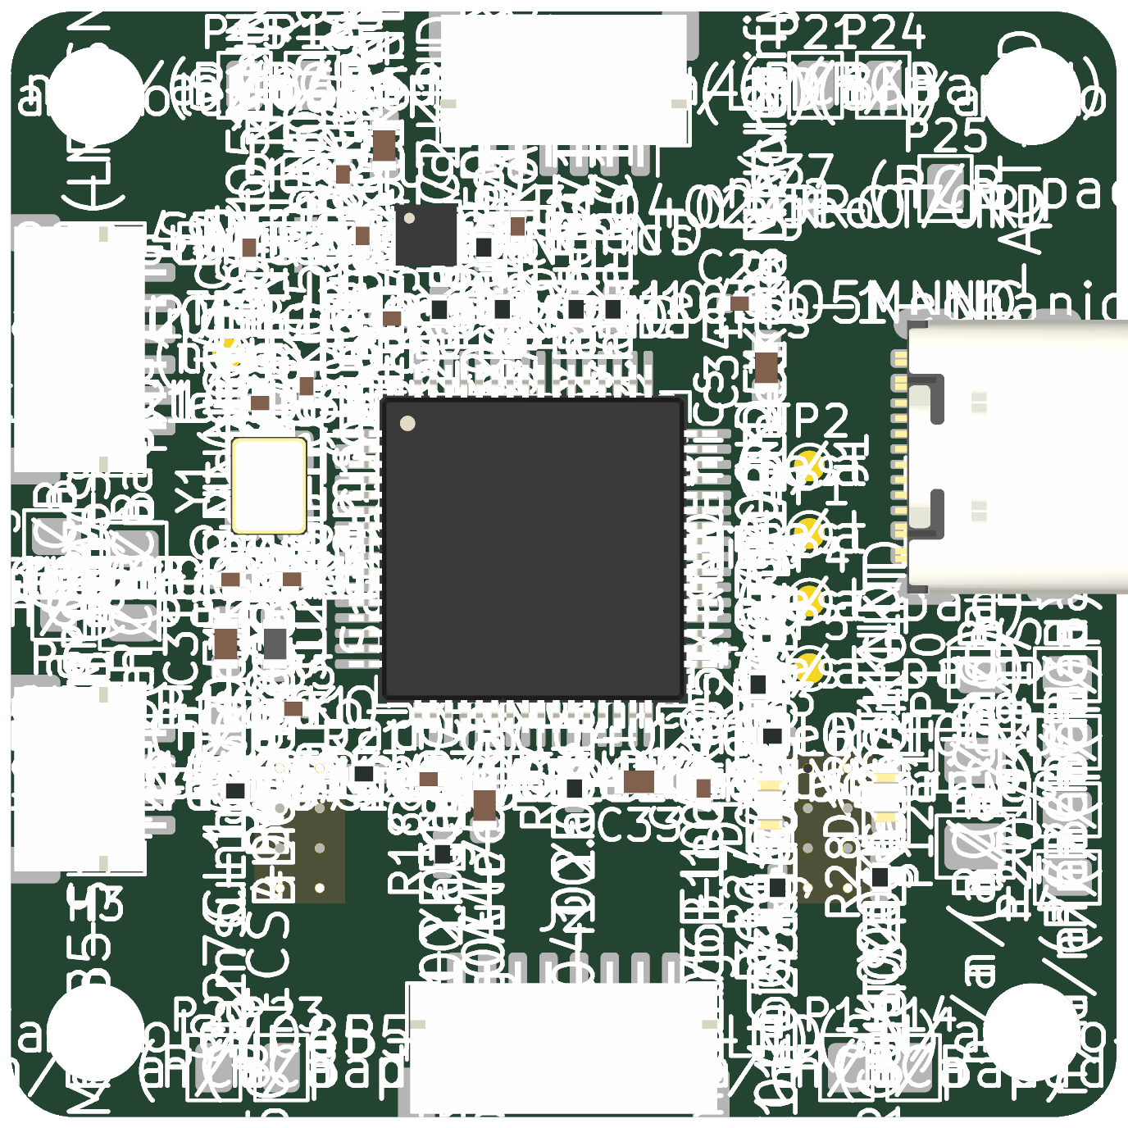
docs/renders/wip_top.png
