FallenFireGit/F405-FC/docs/F405FC.step

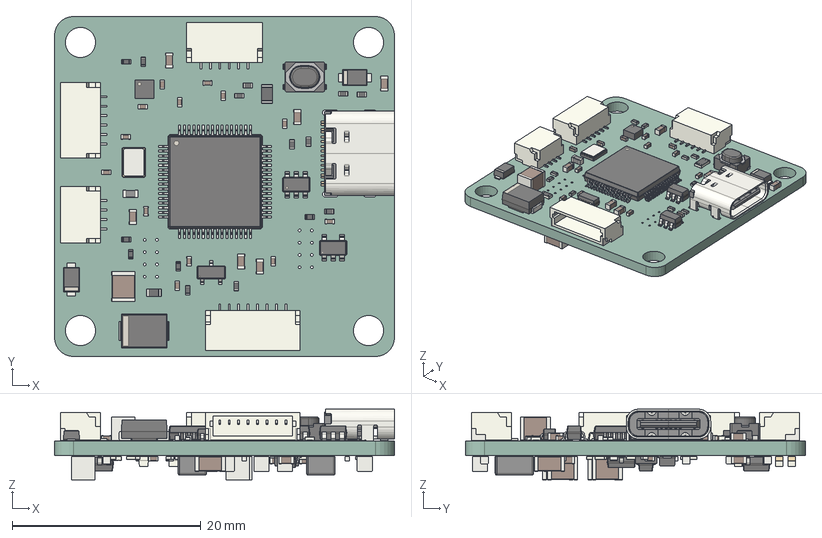
[picture p12: CAD file, 2026-10-15]
docs/F405FC.step
36.0 x 36.0 x 7.49 mm
USB_C_Receptacle_16P_TopMnt_Horizontal_GCT_USB4105-xx-A
C_1210_3225Metric x 5
C_0402_1005Metric x 26
JST_SH_SM08B-SRSS-TB_1x08-1MP_P1.00mm_Horizontal
R_0402_1005Metric x 33
SOT-23-5 x 2
C_0603_1608Metric x 15
R_0603_1608Metric x 3
Crystal_SMD_3225-4Pin_3.2x2.5mm
6081697a-9268-11ed-8af4-a0cec80452fd_part x 3
60816e3e-9268-11ed-8af4-a0cec80452fd_part x 3
6081710e-9268-11ed-8af4-a0cec80452fd_part x 3
6081737a-9268-11ed-8af4-a0cec80452fd_part x 3
SOT-23 x 2
R_0805_2012Metric
LGA_12_2x2mm_P05mm
JST_SH_SM06B-SRSS-TB_1x06-1MP_P1.00mm_Horizontal x 2
D_SMB
SOT-23-6 x 2
SW_SPST_PTS810
JST_SH_SM04B-SRSS-TB_1x04-1MP_P1.00mm_Horizontal
LQFP-64_10x10mm_P0.5mm
L_0603_1608Metric
C_1206_3216Metric x 6
L_Wuerth_MAPI_4020 x 2
LED_0603_1608Metric x 3
LGA_14_3x25mm_P05mm_LayoutBorder3x4y
F405FC_PCB
