FallenFireGit/F405-FC/docs/F405FC_schematic.pdf

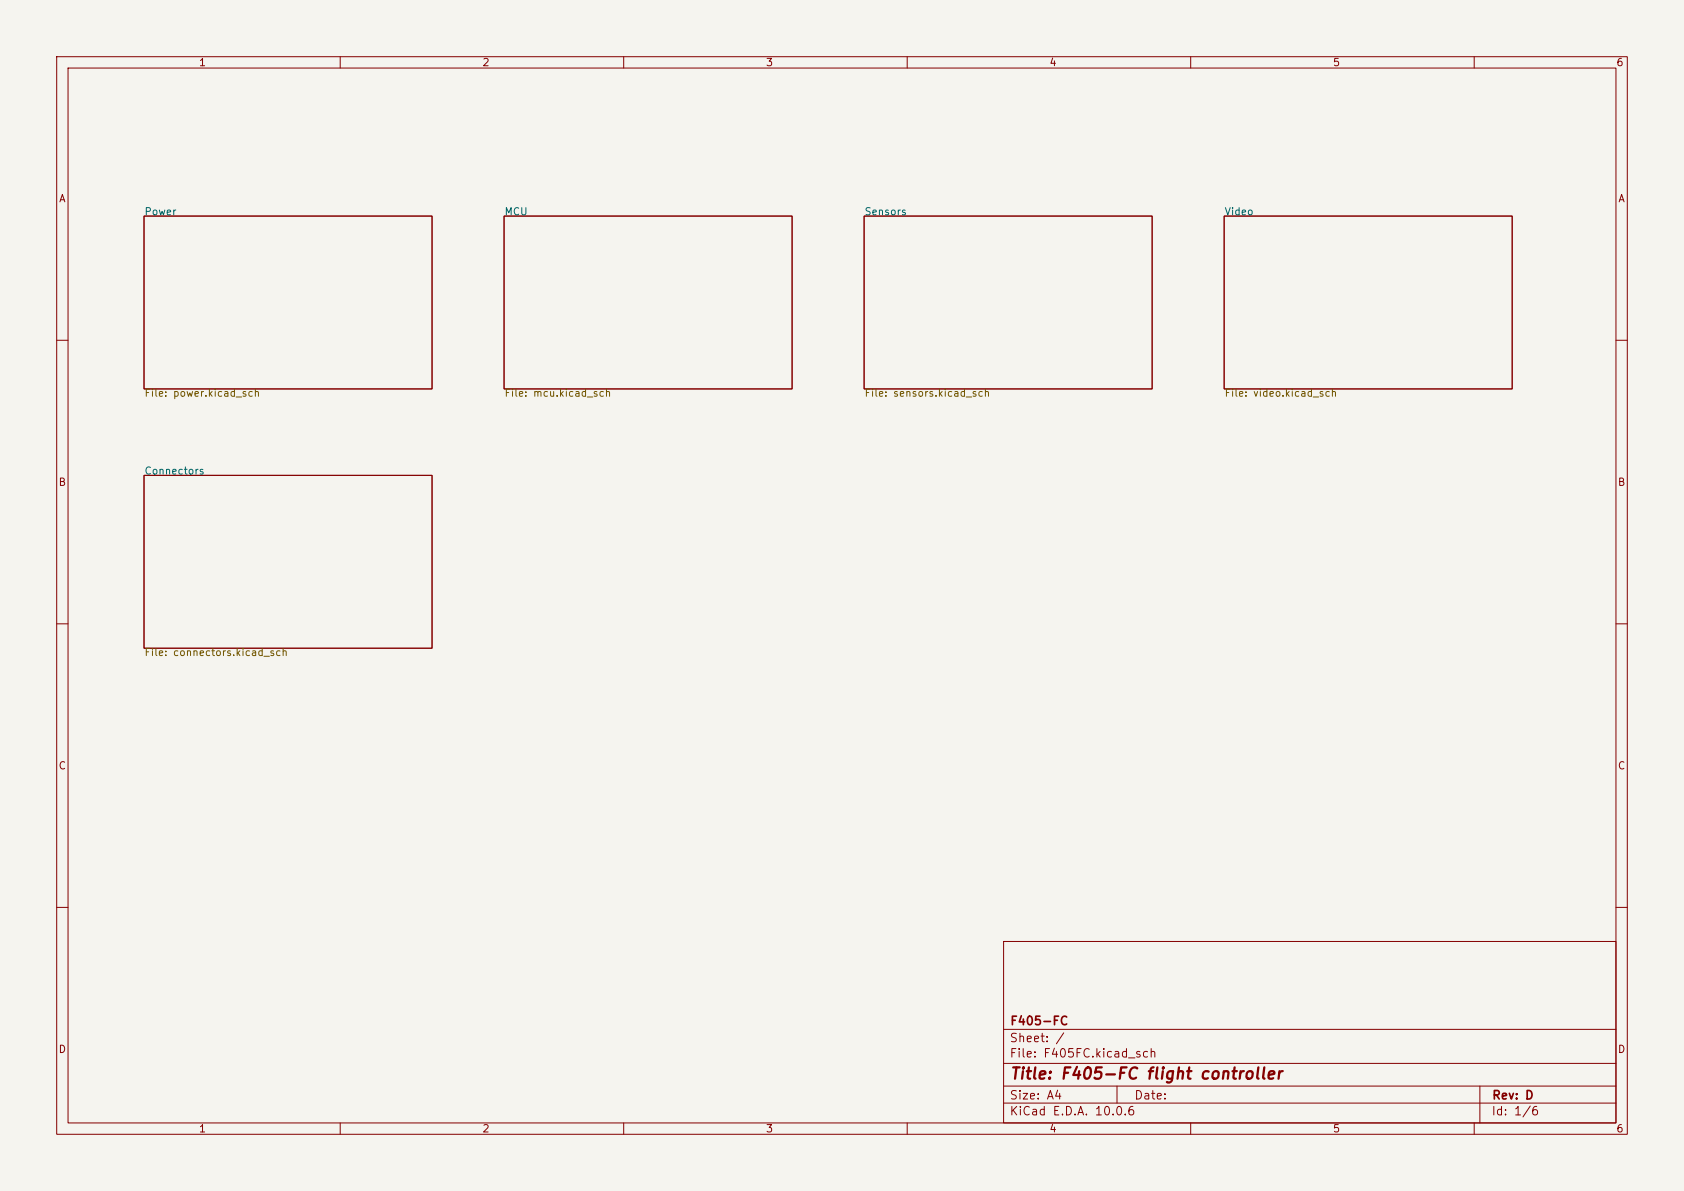
[picture p13: page 1]

File: video.kicad_sch Connectors File: connectors.kicad_sch

Size: A4 | Rev: D
KiCad E.D.A. 10.0.6 | Id: 1/6

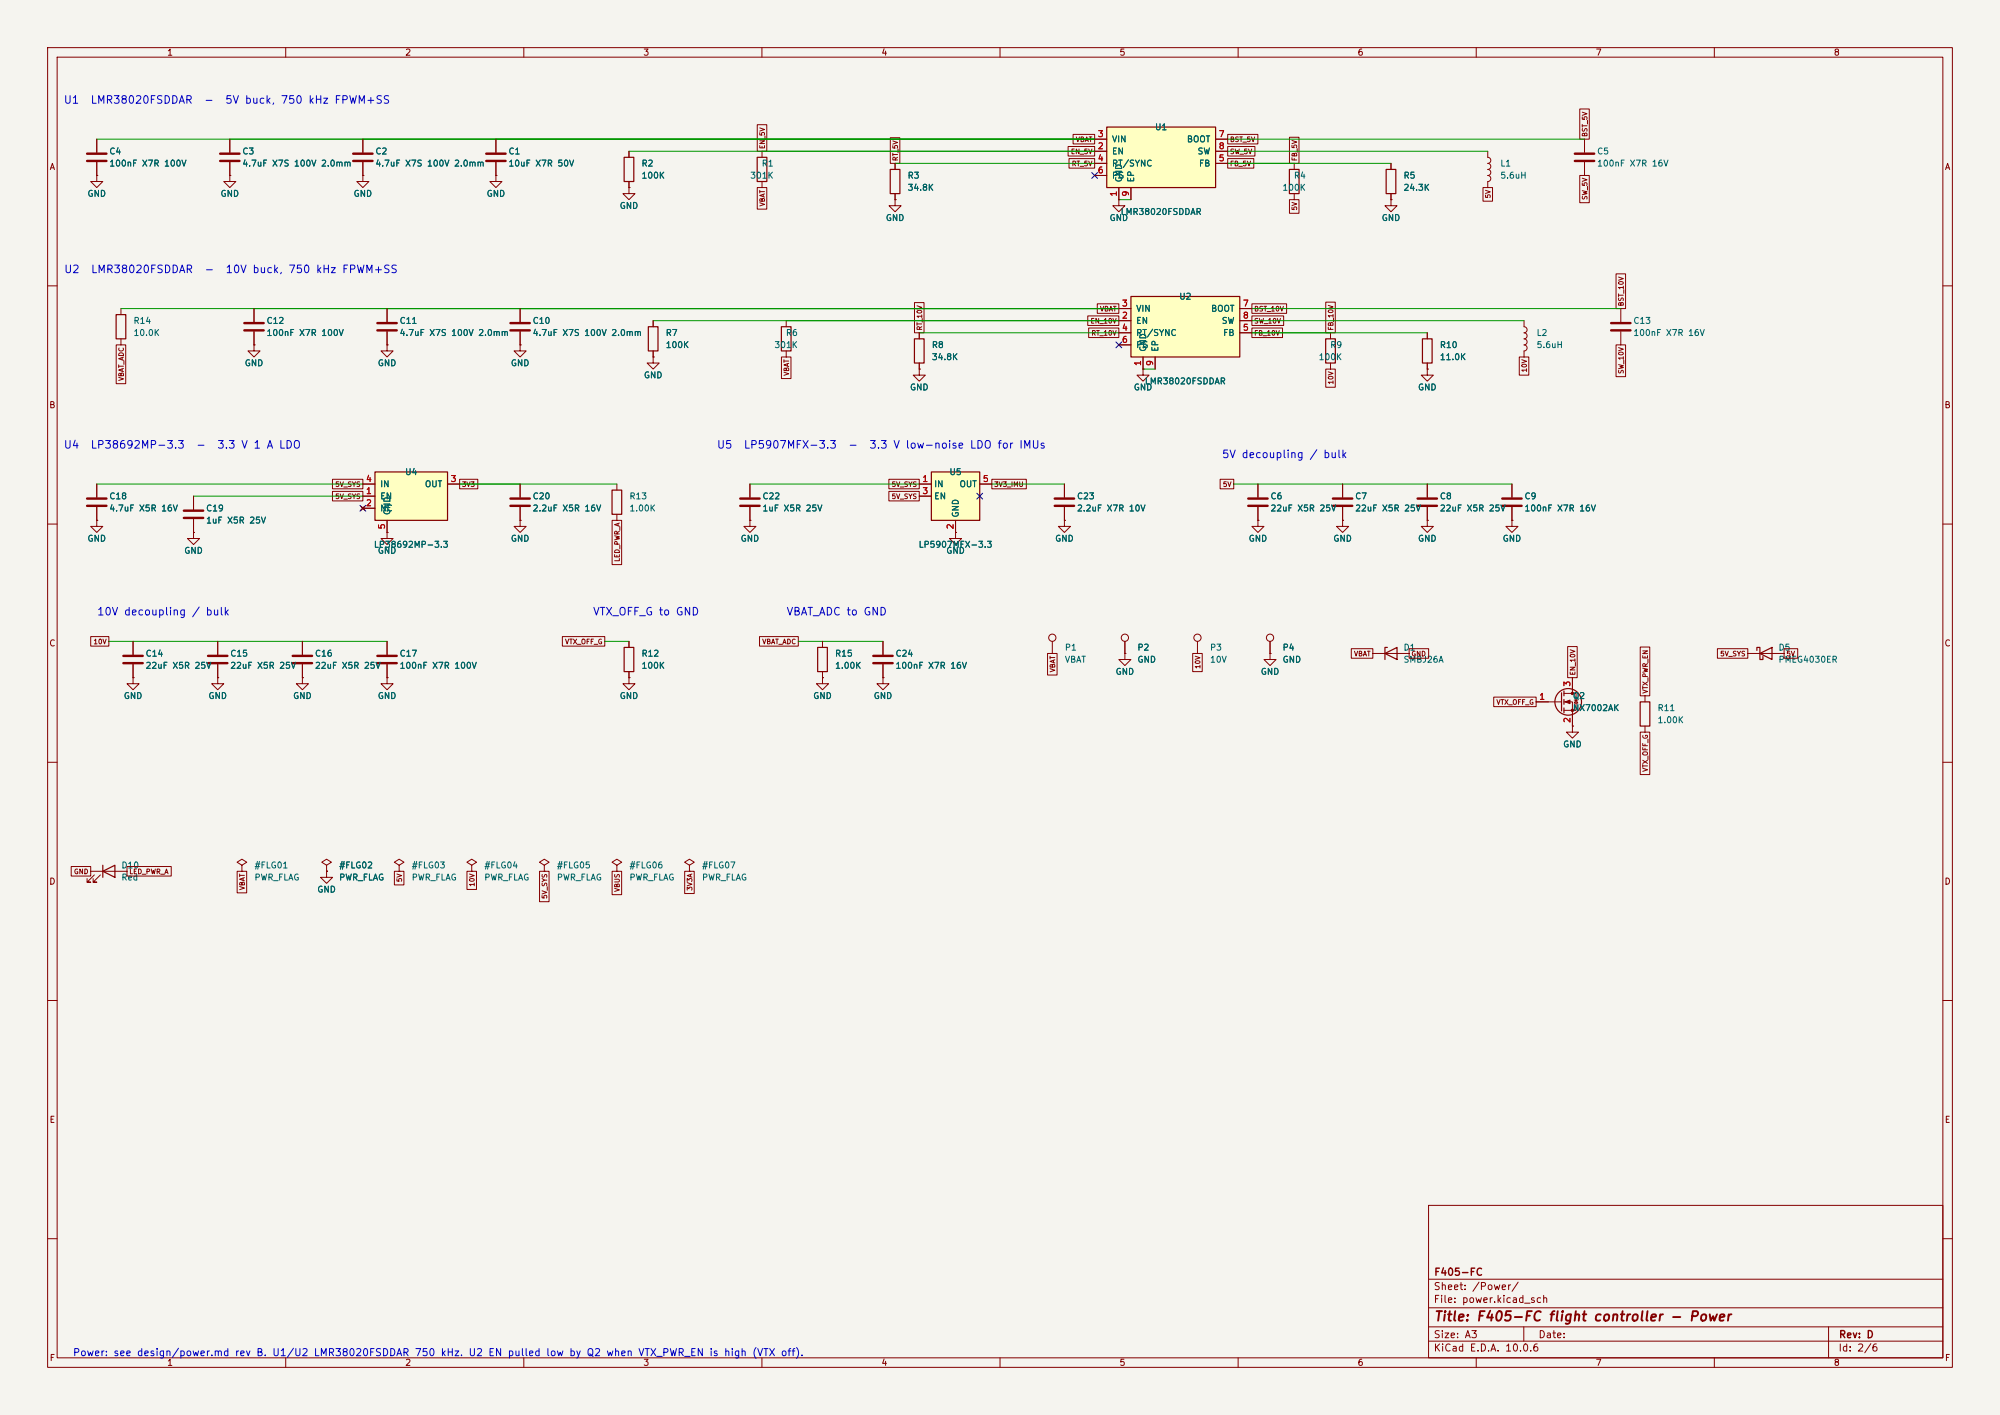
[picture p14: page 2]

Sheet: /Power/
File: power.kicad_sch
Title: F405-FC flight controller - Power

Power: see design/power.md rev B. U1/U2 LMR38020FSDDAR 750 kHz. U2 EN pulled low by Q2 when VTX_PWR_EN is high (VTX off).

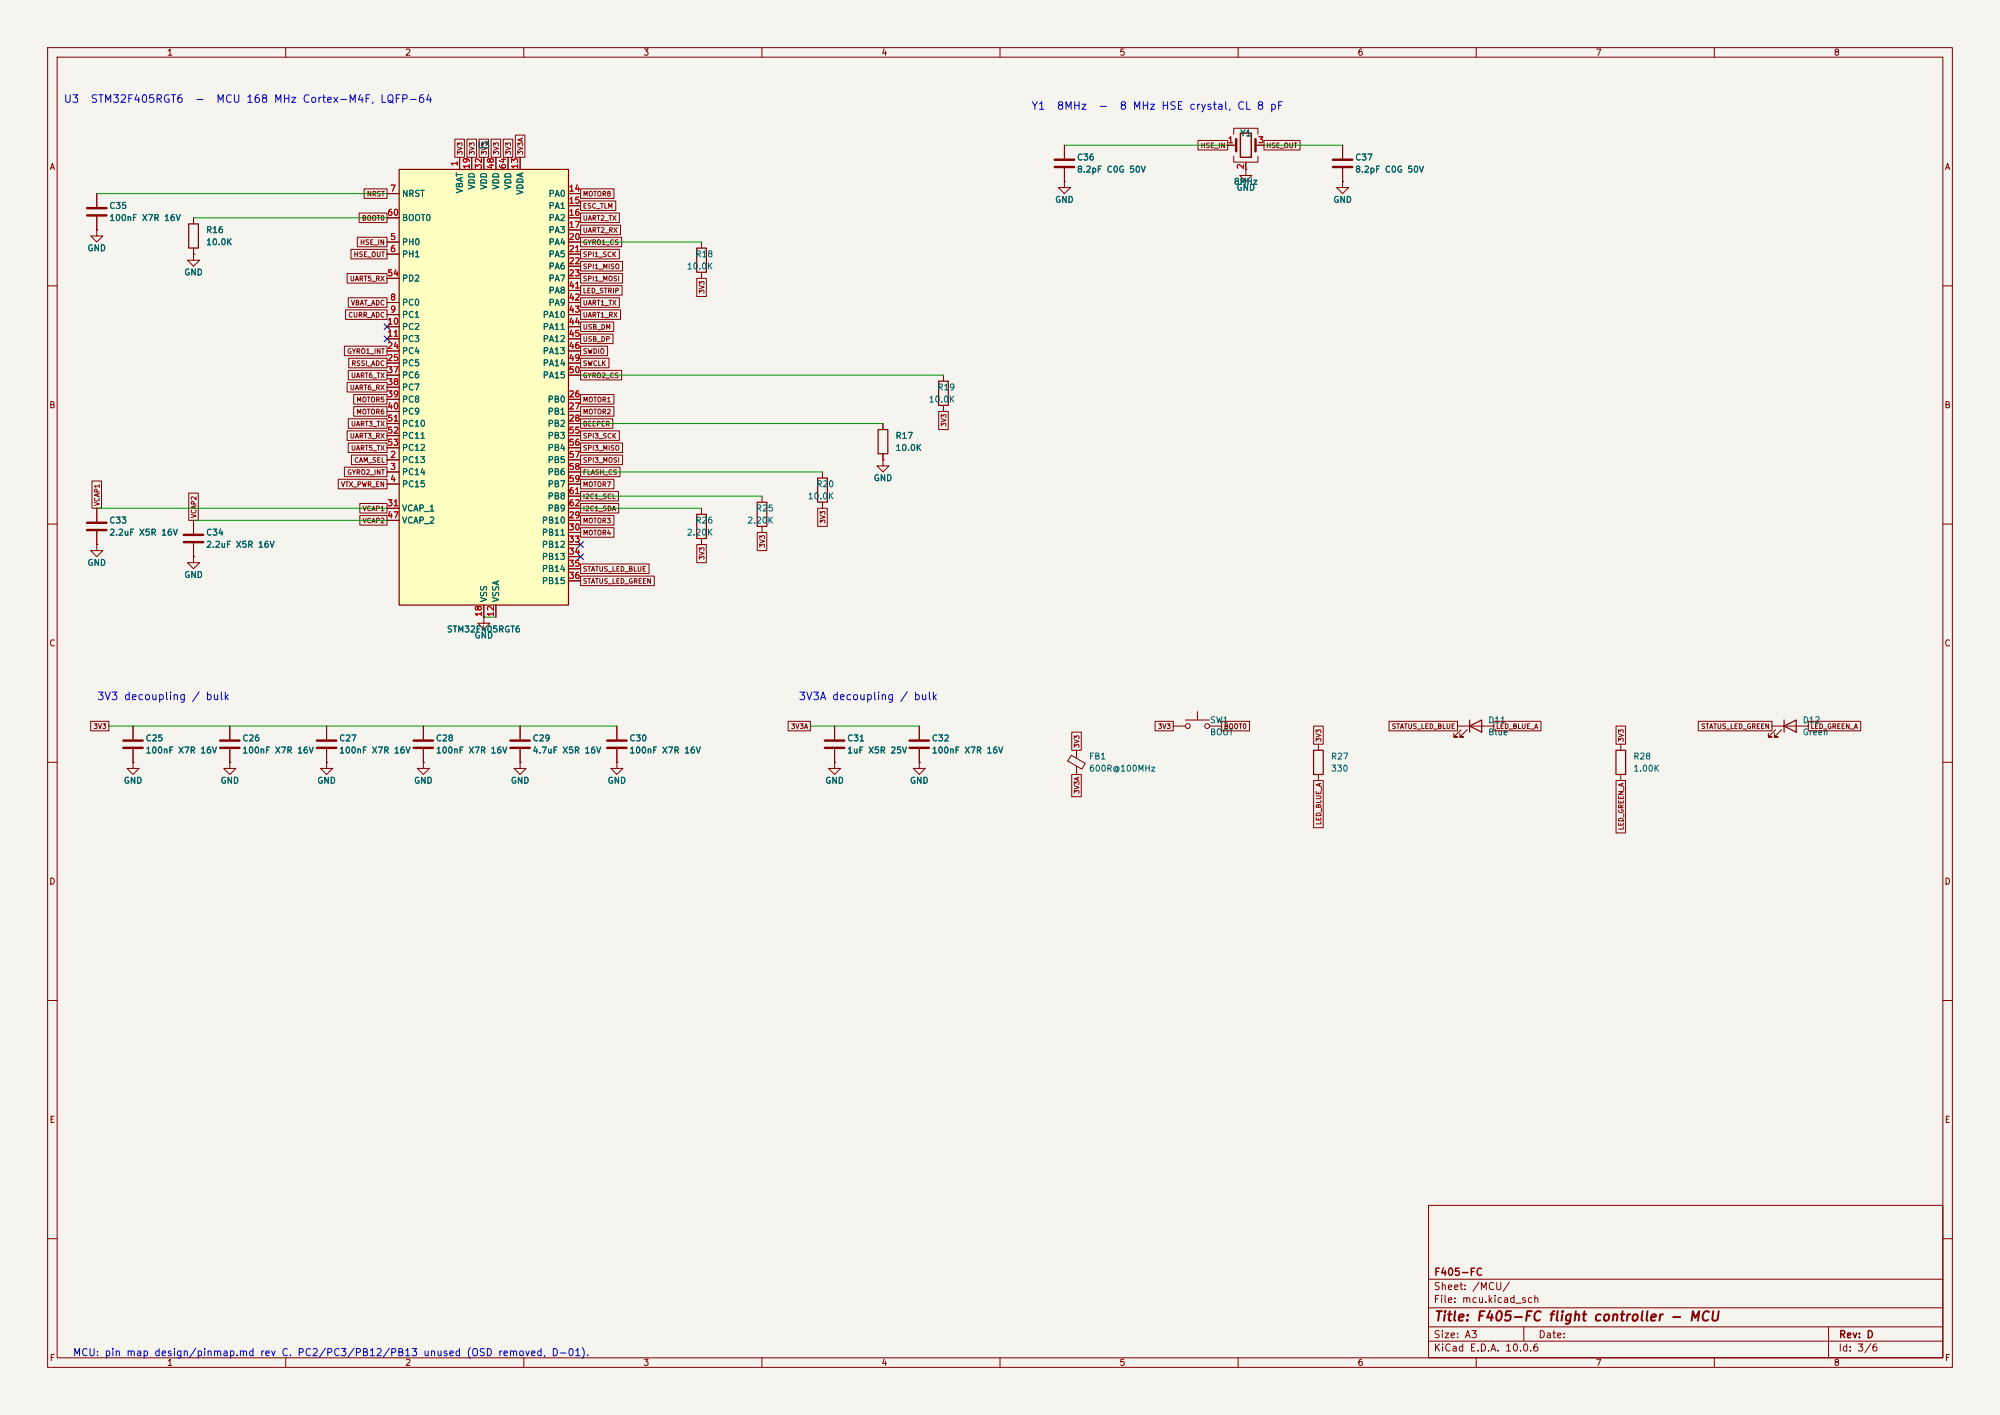
[picture p15: page 3]

Sheet: /MCU/
File: mcu.kicad_sch
Title: F405-FC flight controller - MCU

MCU: pin map design/pinmap.md rev C. PC2/PC3/PB12/PB13 unused (OSD removed, D-01).

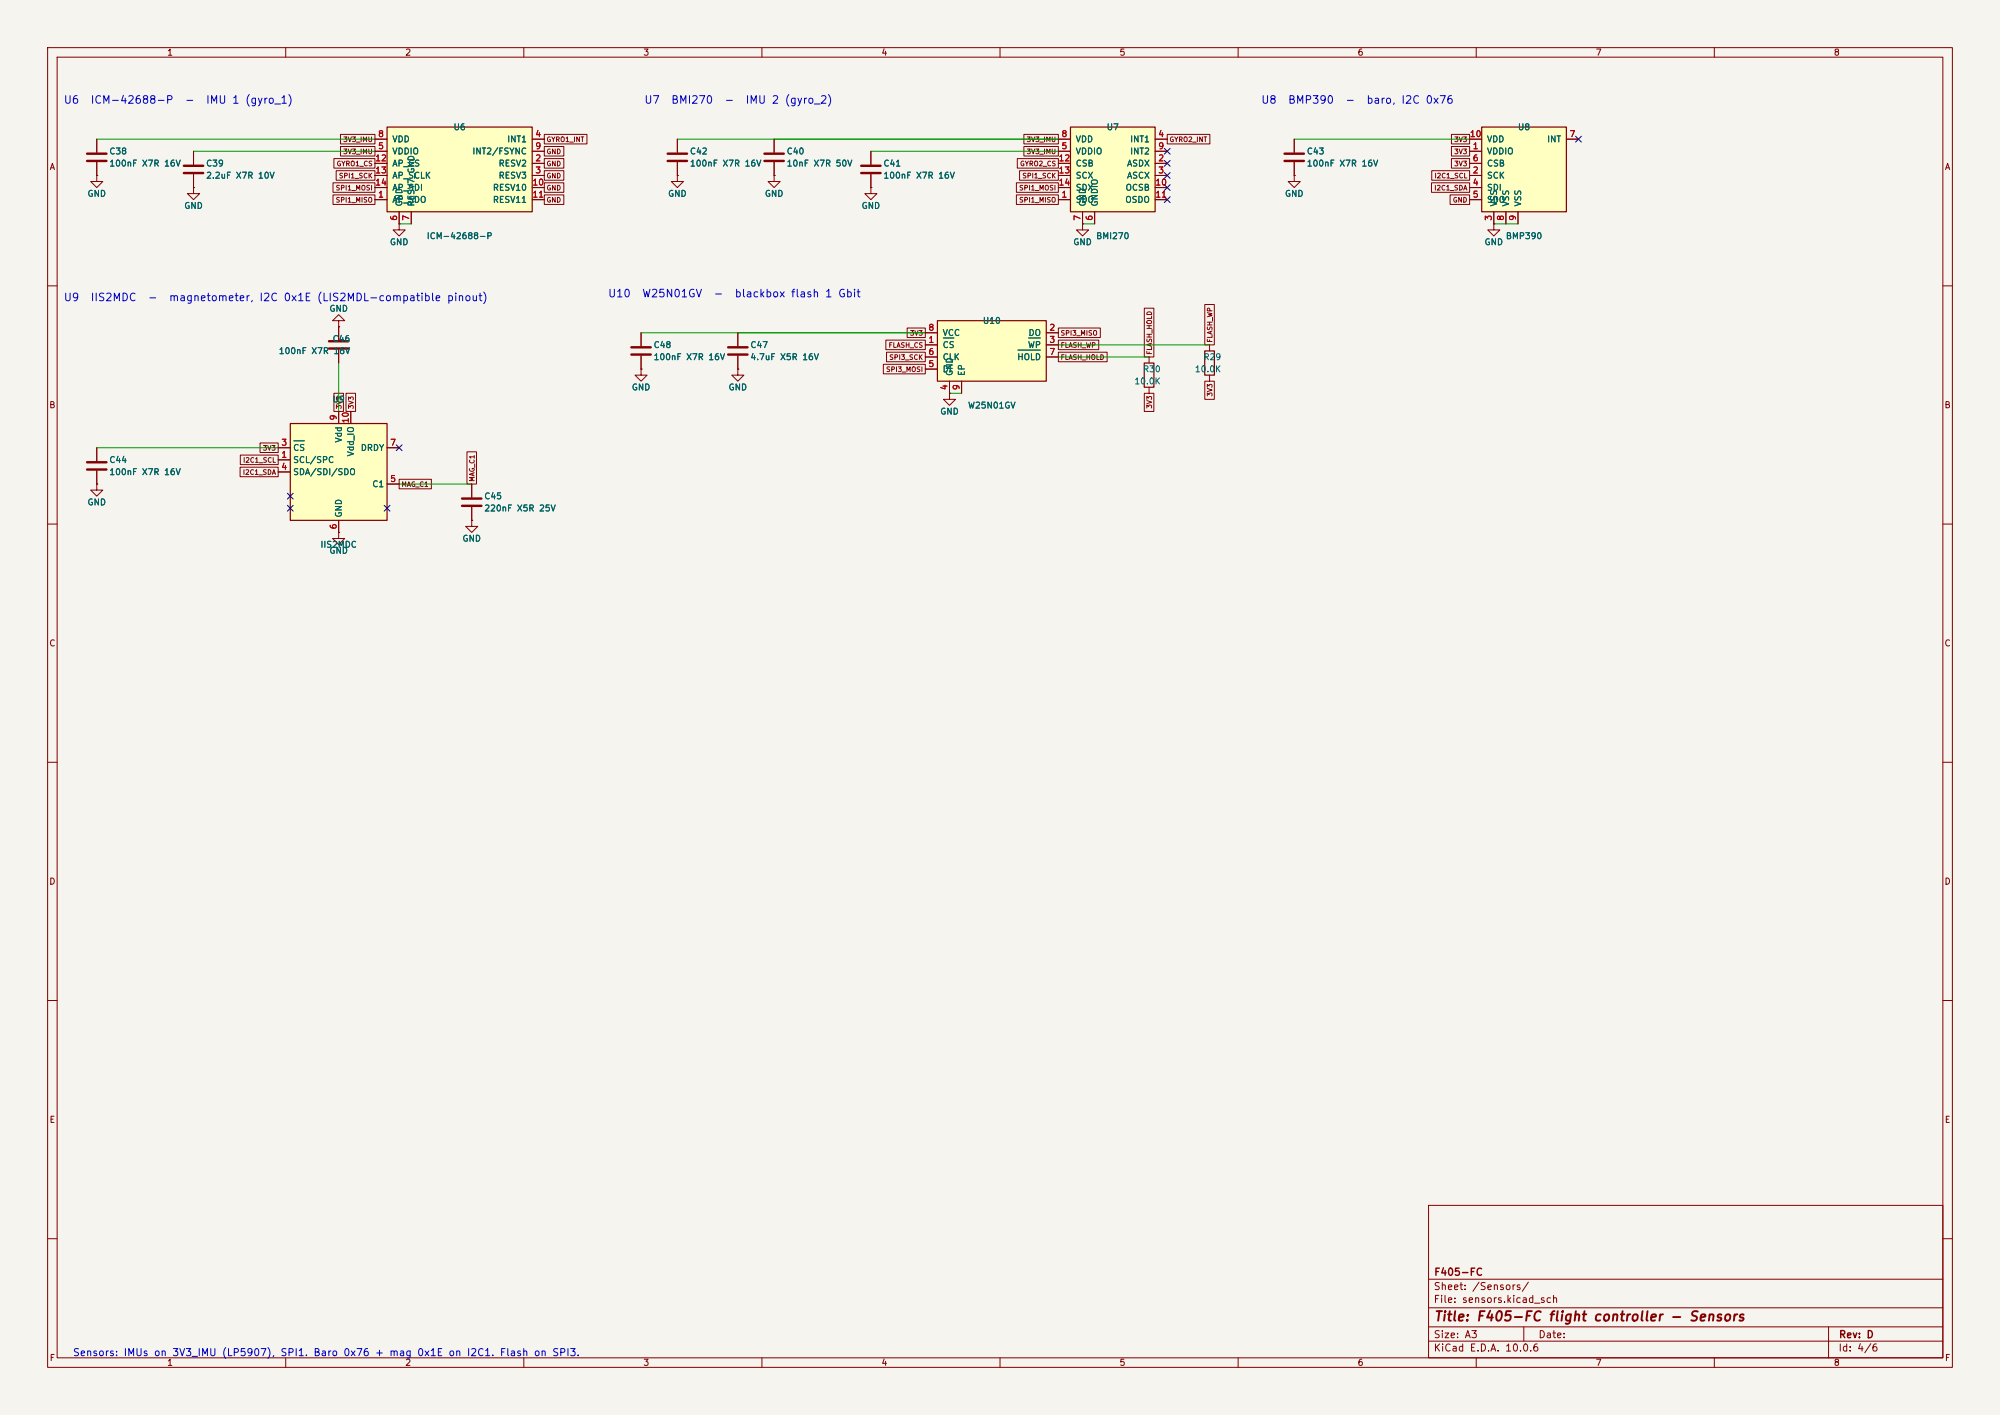
[picture p16: page 4]

Sheet: /Sensors/
File: sensors.kicad_sch
Title: F405-FC flight controller - Sensors

Sensors: IMUs on 3V3_IMU (LP5907), SPI1. Baro 0x76 + mag 0x1E on I2C1. Flash on SPI3.

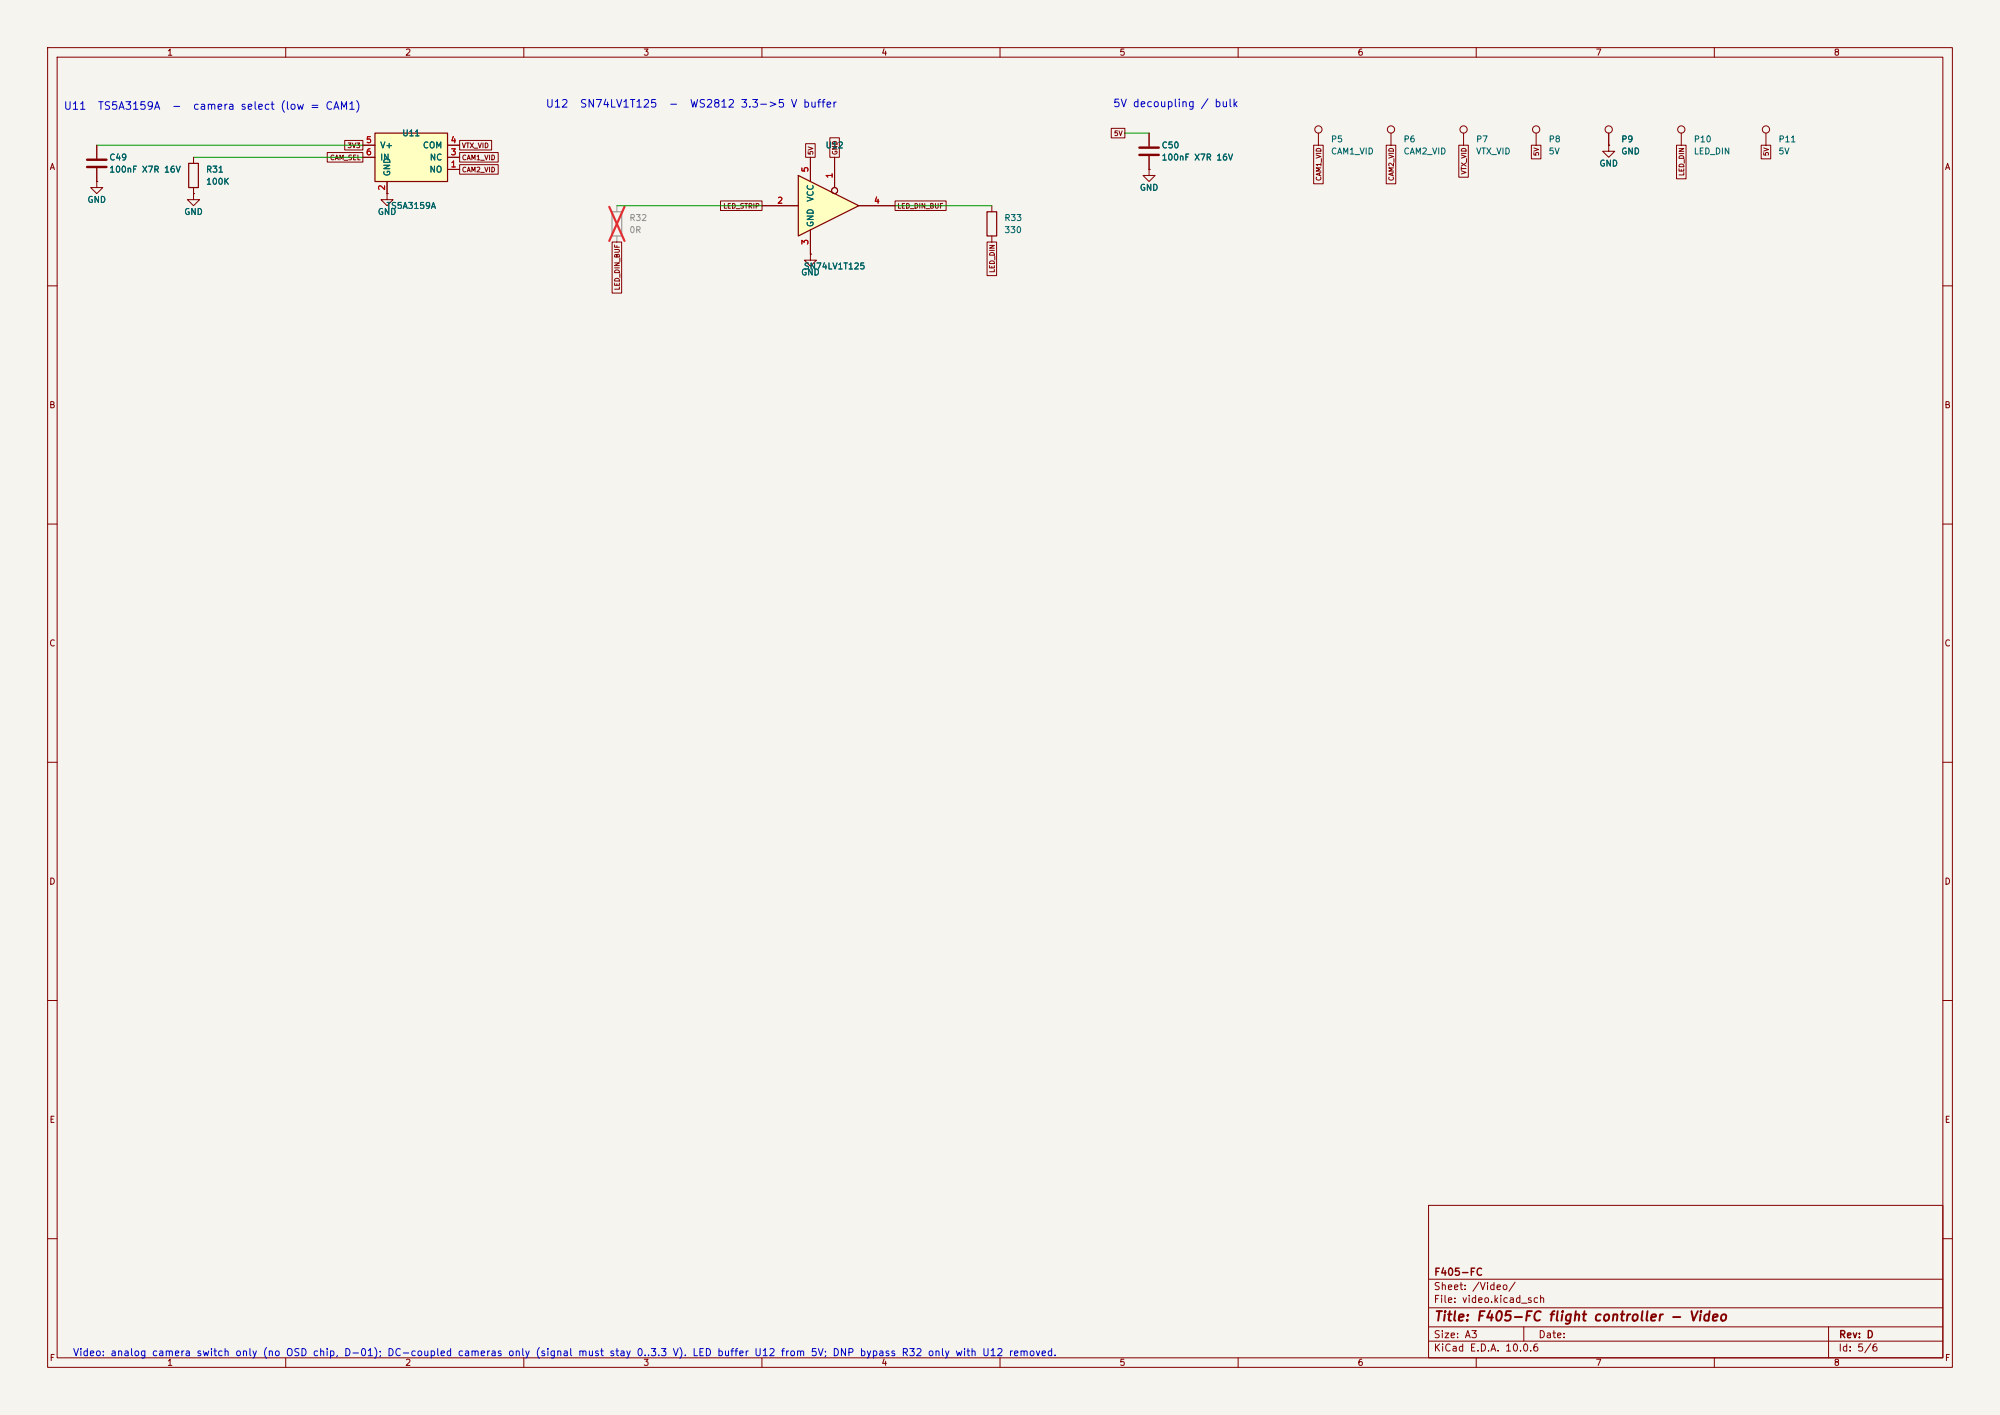
[picture p17: page 5]

Sheet: /Video/
File: video.kicad_sch
Title: F405-FC flight controller - Video

Video: analog camera switch only (no OSD chip, D-01); DC-coupled cameras only (signal must stay 0..3.3 V). LED buffer U12 from 5V; DNP bypass R32 only with U12 removed.

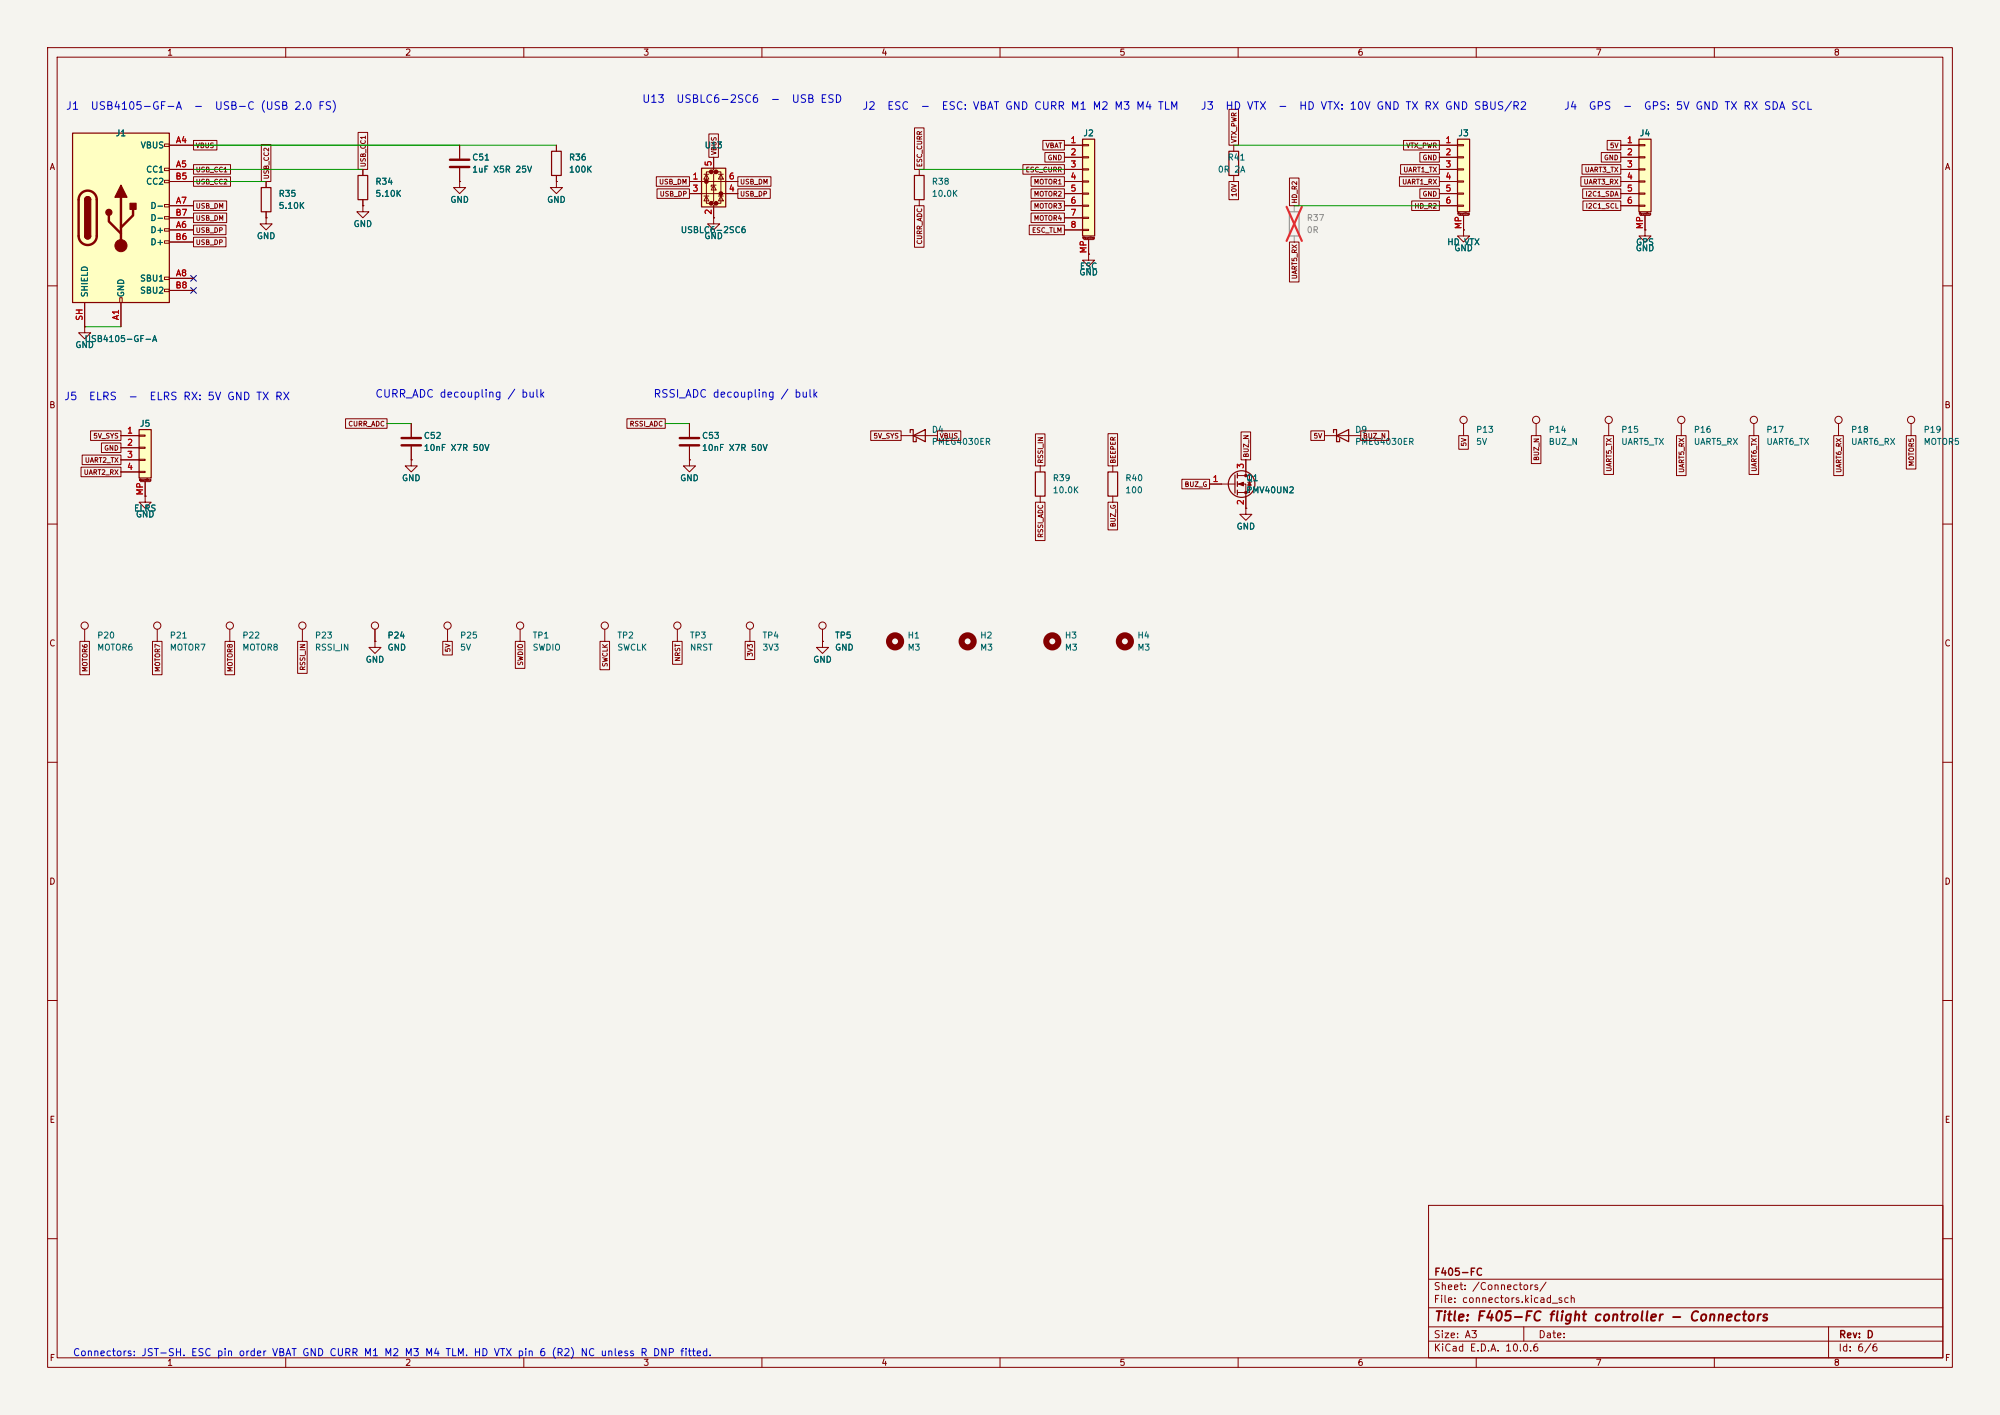
[picture p18: page 6]

Sheet: /Connectors/
File: connectors.kicad_sch
Title: F405-FC flight controller - Connectors

Connectors: JST-SH. ESC pin order VBAT GND CURR M1 M2 M3 M4 TLM. HD VTX pin 6 (R2) NC unless R DNP fitted.
