FallenFireGit/F405-FC/kicad/F405FC.kicad_pcb

## KiCad design kicad/F405FC.kicad_pcb (2026-10-15)

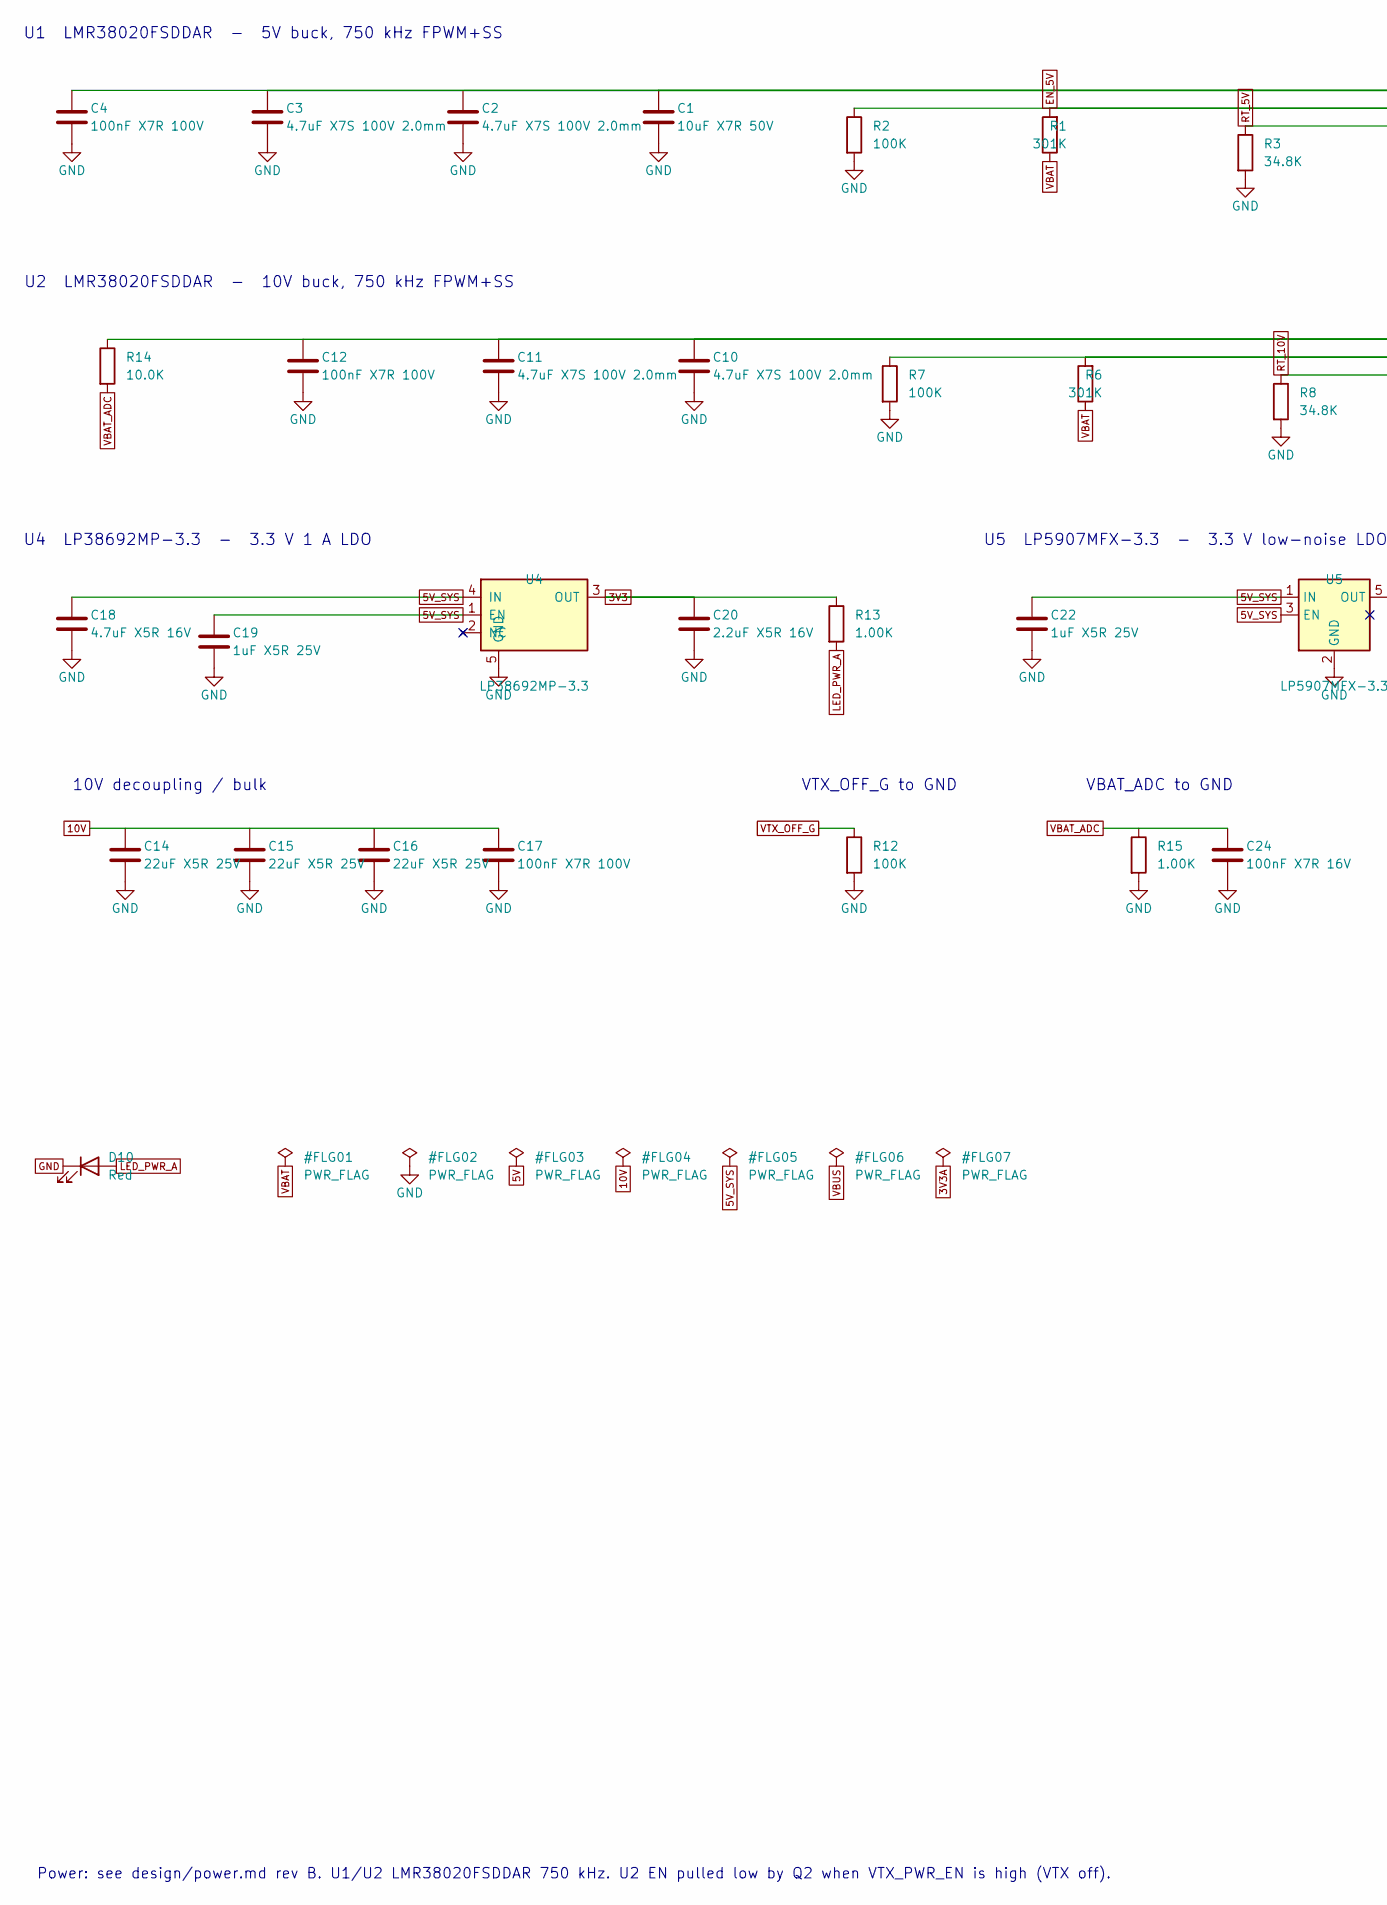
[picture p19: schematic power.kicad_sch, F405-FC flight controller - Power, part in row 1, column 1]

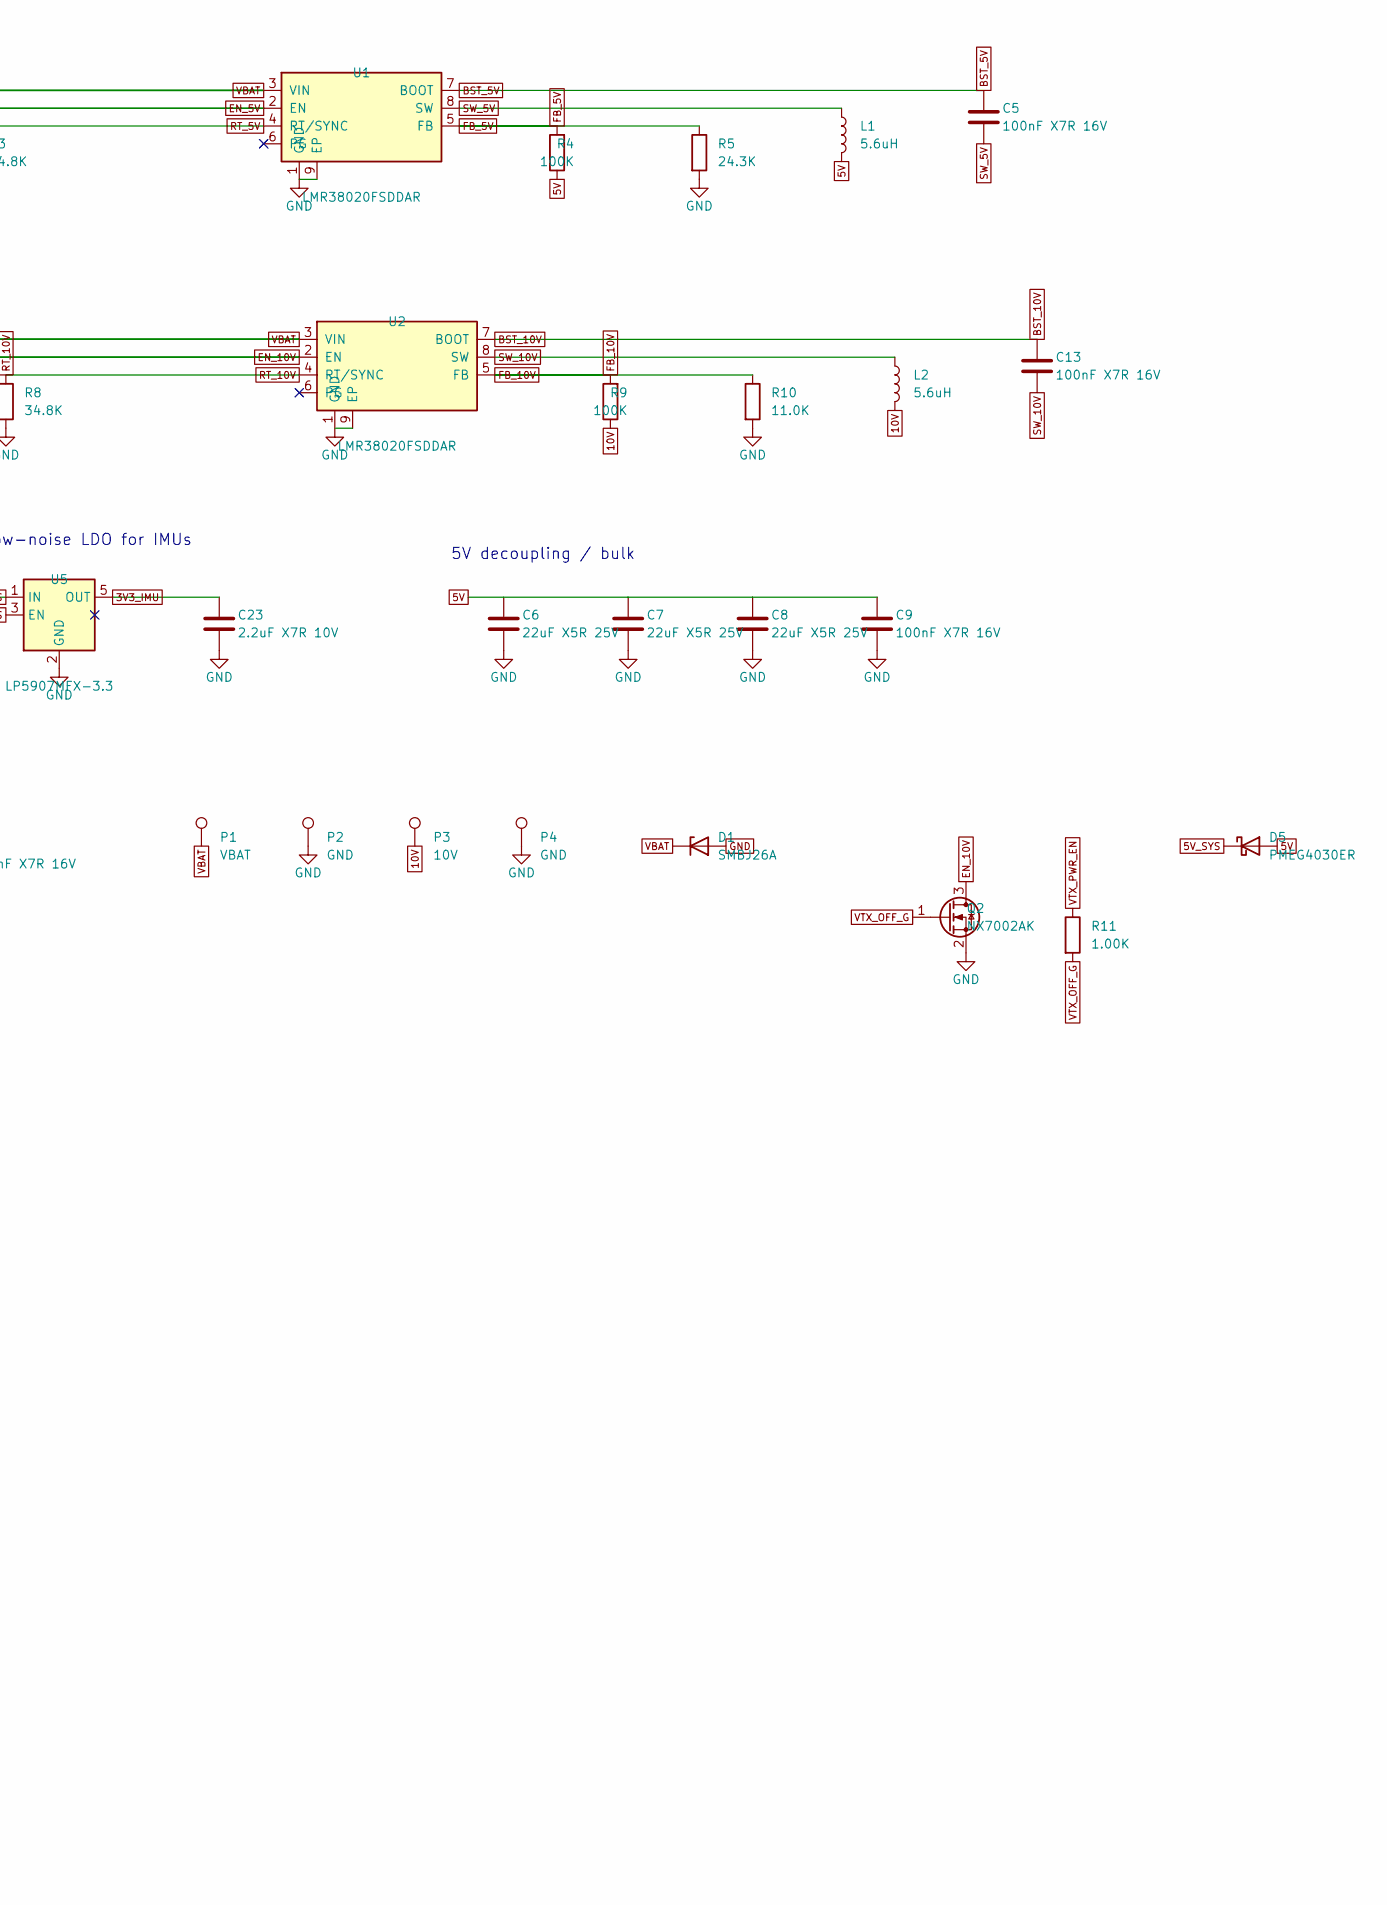
[picture p20: schematic power.kicad_sch, F405-FC flight controller - Power, part in row 1, column 2]

Parts:
C1: 10uF X7R 50V; C_1210_3225Metric; MPN CL32B106KBJNNNE; DigiKey 1276-3387-1-ND
C2, C3, C10, C11: 4.7uF X7S 100V 2.0mm; C_1210_3225Metric; MPN C3225X7S2A475K200AB; DigiKey 445-6042-1-ND (verify: K200AB cut tape)
C4, C12, C17: 100nF X7R 100V; C_0603_1608Metric; MPN GRM188R72A104KA35D; DigiKey 490-3285-1-ND (verify)
C5, C9, C13, C24: 100nF X7R 16V; C_0402_1005Metric; MPN CL05B104KO5NNNC; DigiKey 1276-1001-1-ND
C6, C7, C8, C14, C15, C16: 22uF X5R 25V; C_1206_3216Metric; MPN CL31A226KAHNNNE; DigiKey 1276-3047-1-ND
C18: 4.7uF X5R 16V; C_0603_1608Metric; MPN CL10A475KO8NNNC; DigiKey 1276-1784-1-ND
C19, C22: 1uF X5R 25V; C_0603_1608Metric; MPN CL10A105KA8NNNC; DigiKey 1276-1102-1-ND (verify)
C20: 2.2uF X5R 16V; C_0603_1608Metric; MPN CL10A225KO8NNNC; DigiKey 1276-1040-1-ND
C23: 2.2uF X7R 10V; C_0603_1608Metric; MPN CL10B225KP8NNNC; DigiKey 1276-1134-1-ND
D1: SMBJ26A; D_SMB; MPN SMBJ26A; DigiKey SMBJ26ALFCT-ND
D5: PMEG4030ER; Nexperia_CFP3_SOD-123W; MPN PMEG4030ER,115; DigiKey 1727-5313-1-ND
D10: Red; LED_0603_1608Metric; MPN LTST-C191KRKT; DigiKey 160-1447-1-ND
L1, L2: 5.6uH; L_Wuerth_MAPI-4020; MPN 78438356056; DigiKey 732-11317-1-ND
P1: VBAT; Pad_SMD_2.5x4.0mm; MPN n/a (PCB pad); DigiKey n/a (PCB pad)
P2: GND; Pad_SMD_2.5x4.0mm; MPN n/a (PCB pad); DigiKey n/a (PCB pad)
P3: 10V; Pad_SMD_2.0x3.0mm; MPN n/a (PCB pad); DigiKey n/a (PCB pad)
P4: GND; Pad_SMD_2.0x3.0mm; MPN n/a (PCB pad); DigiKey n/a (PCB pad)
Q2: NX7002AK; SOT-23; MPN NX7002AK,215; DigiKey 1727-1289-1-ND
R1, R6: 301K; R_0603_1608Metric; MPN RC0603FR-07301KL; DigiKey 311-301KHRCT-ND
R2, R4, R7, R9, R12: 100K; R_0402_1005Metric; MPN RC0402FR-07100KL; DigiKey 311-100KLRCT-ND
R3, R8: 34.8K; R_0402_1005Metric; MPN ERJ-2RKF3482X; DigiKey P34.8KLCT-ND
R5: 24.3K; R_0402_1005Metric; MPN ERJ-2RKF2432X; DigiKey P24.3KLCT-ND
R10: 11.0K; R_0402_1005Metric; MPN RC0402FR-0711KL; DigiKey 311-11.0KLRCT-ND
R11, R13, R15: 1.00K; R_0402_1005Metric; MPN RC0402FR-071KL; DigiKey 311-1.00KLRCT-ND
R14: 10.0K; R_0603_1608Metric; MPN RC0603FR-0710KL; DigiKey 311-10.0KHRCT-ND
U1, U2: LMR38020FSDDAR; TI_HSOIC-8-1EP_3.9x4.9mm_P1.27mm_EP2.71x3.4mm_DDA; MPN LMR38020FSDDAR; DigiKey 296-LMR38020FSDDARCT-ND (verify)
U4: LP38692MP-3.3; SOT-223-5; MPN LP38692MP-3.3/NOPB; DigiKey LP38692MP-3.3/NOPBCT-ND
U5: LP5907MFX-3.3; SOT-23-5; MPN LP5907MFX-3.3/NOPB; DigiKey 296-38557-1-ND

Connections:
3V3: C20.1, R13.1, U4.3 (OUT); also elsewhere on the board
3V3_IMU: C23.1, U5.5 (OUT); also elsewhere on the board
5V: C6.1, C7.1, C8.1, C9.1, D5.2 (A), L1.2, R4.1; also elsewhere on the board
5V_SYS: C18.1, C19.1, C22.1, D5.1 (K), U4.1 (EN), U4.4 (IN), U5.1 (IN), U5.3 (EN); also elsewhere on the board
10V: C14.1, C15.1, C16.1, C17.1, L2.2, P3.1, R9.1; also elsewhere on the board
BST_5V: C5.1, U1.7 (BOOT)
BST_10V: C13.1, U2.7 (BOOT)
EN_5V: R1.2, R2.1, U1.2 (EN)
EN_10V: Q2.3 (D), R6.2, R7.1, U2.2 (EN)
FB_5V: R4.2, R5.1, U1.5 (FB)
FB_10V: R9.2, R10.1, U2.5 (FB)
GND: C1.2, C2.2, C3.2, C4.2, C6.2, C7.2, C8.2, C9.2, C10.2, C11.2, C12.2, C14.2, C15.2, C16.2, C17.2, C18.2, C19.2, C20.2, C22.2, C23.2, C24.2, D1.2 (A), D10.1 (K), P2.1, P4.1, Q2.2 (S), R2.2, R3.2, R5.2, R7.2, R8.2, R10.2, R12.2, R15.2, U1.1 (GND), U1.9 (EP), U2.1 (GND), U2.9 (EP), U4.5 (GND), U5.2 (GND); also elsewhere on the board
LED_PWR_A: D10.2 (A), R13.2
RT_5V: R3.1, U1.4 (RT/SYNC)
RT_10V: R8.1, U2.4 (RT/SYNC)
SW_5V: C5.2, L1.1, U1.8 (SW)
SW_10V: C13.2, L2.1, U2.8 (SW)
VBAT: C1.1, C2.1, C3.1, C4.1, C10.1, C11.1, C12.1, D1.1 (K), P1.1, R1.1, R6.1, R14.1, U1.3 (VIN), U2.3 (VIN); also elsewhere on the board
VBAT_ADC: C24.1, R14.2, R15.1; also elsewhere on the board
VTX_OFF_G: Q2.1 (G), R11.2, R12.1
VTX_PWR_EN: R11.1; also elsewhere on the board

Notes on the sheet:
U1 LMR38020FSDDAR - 5V buck, 750 kHz FPWM+SS
U2 LMR38020FSDDAR - 10V buck, 750 kHz FPWM+SS
U4 LP38692MP-3.3 - 3.3 V 1 A LDO
U5 LP5907MFX-3.3 - 3.3 V low-noise LDO for IMUs
5V decoupling / bulk
10V decoupling / bulk
VTX_OFF_G to GND
VBAT_ADC to GND
Power: see design/power.md rev B. U1/U2 LMR38020FSDDAR 750 kHz. U2 EN pulled low by Q2 when VTX_PWR_EN is high (VTX off).

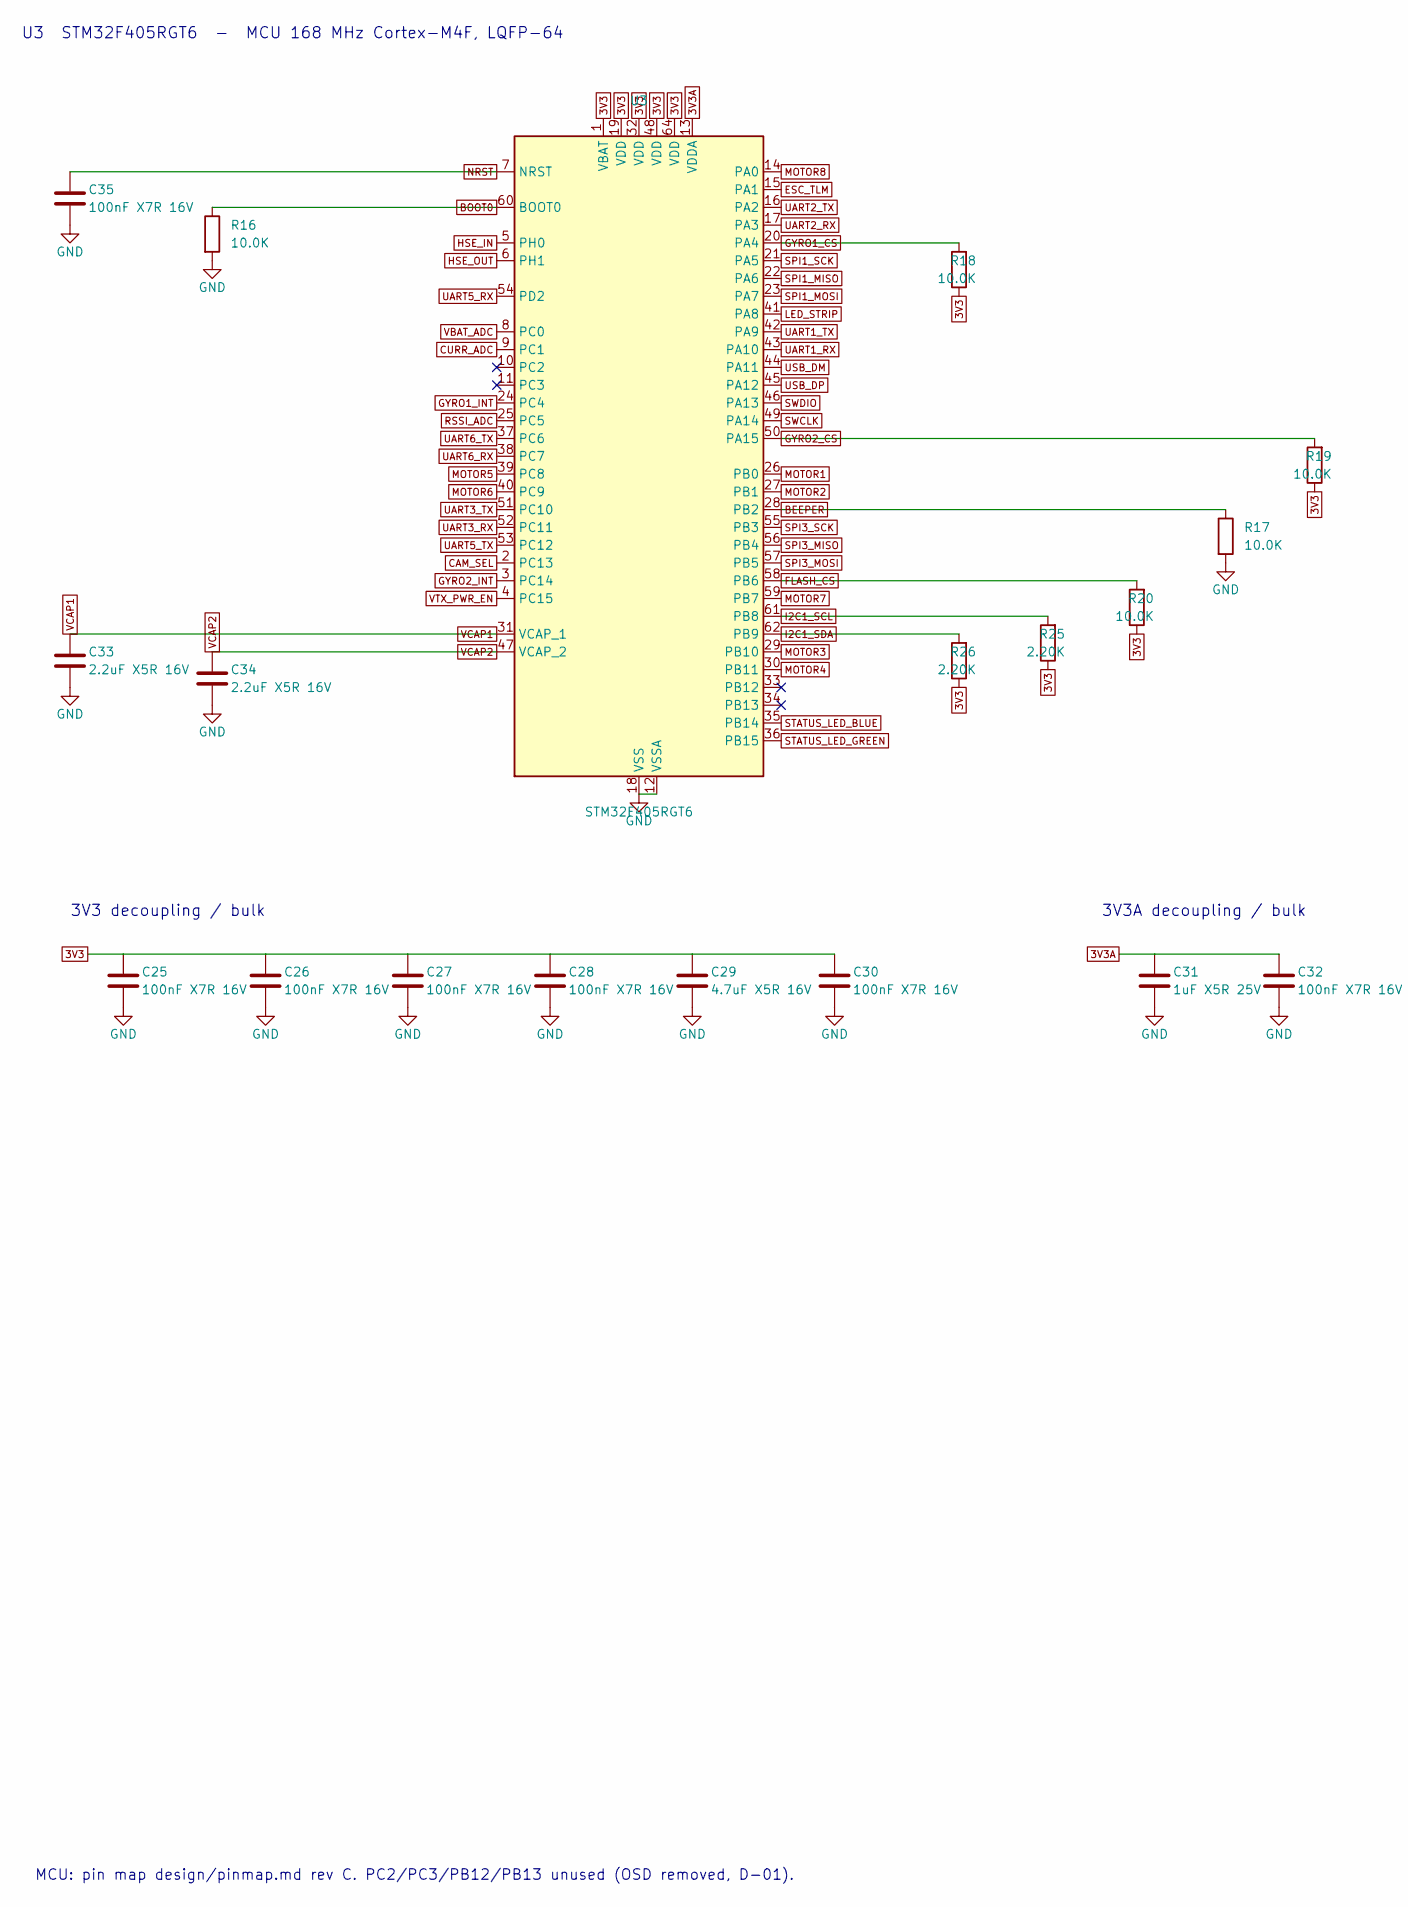
[picture p21: schematic mcu.kicad_sch, F405-FC flight controller - MCU, part in row 1, column 1]

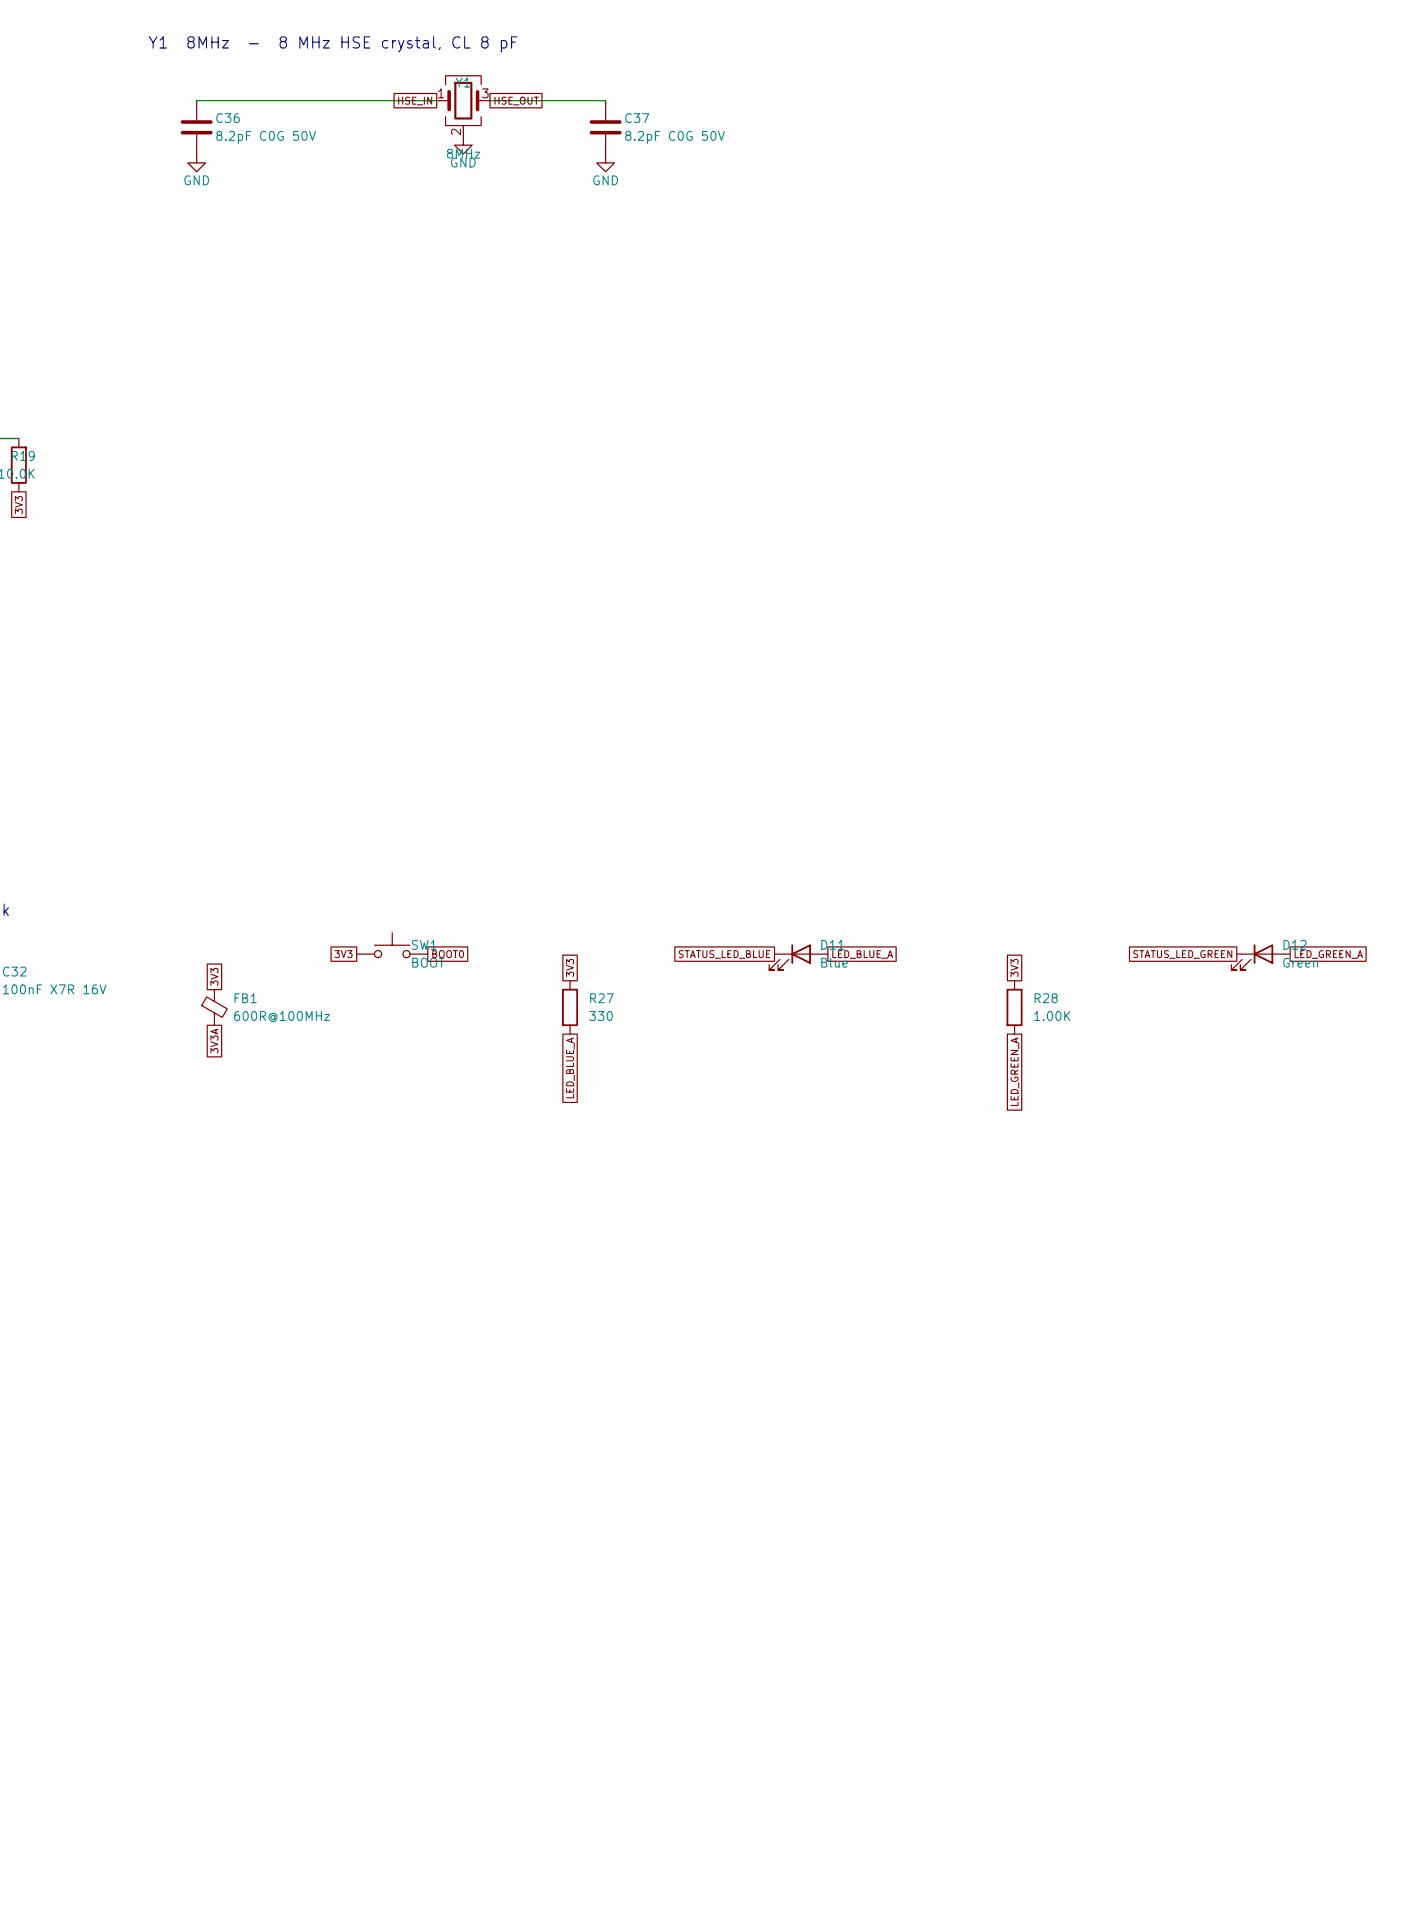
[picture p22: schematic mcu.kicad_sch, F405-FC flight controller - MCU, part in row 1, column 2]

Parts:
C25, C26, C27, C28, C30, C32, C35: 100nF X7R 16V; C_0402_1005Metric; MPN CL05B104KO5NNNC; DigiKey 1276-1001-1-ND
C29: 4.7uF X5R 16V; C_0603_1608Metric; MPN CL10A475KO8NNNC; DigiKey 1276-1784-1-ND
C31: 1uF X5R 25V; C_0603_1608Metric; MPN CL10A105KA8NNNC; DigiKey 1276-1102-1-ND (verify)
C33, C34: 2.2uF X5R 16V; C_0603_1608Metric; MPN CL10A225KO8NNNC; DigiKey 1276-1040-1-ND
C36, C37: 8.2pF C0G 50V; C_0402_1005Metric; MPN C0402C829C5GACTU; DigiKey 399-C0402C829C5GACTUCT-ND
D11: Blue; LED_0603_1608Metric; MPN LTST-C191TBKT; DigiKey 160-1647-1-ND
D12: Green; LED_0603_1608Metric; MPN LTST-C191KGKT; DigiKey 160-1446-1-ND
FB1: 600R@100MHz; L_0603_1608Metric; MPN BLM18KG601SN1D; DigiKey 490-5258-1-ND
R16, R17, R18, R19, R20: 10.0K; R_0402_1005Metric; MPN RC0402FR-0710KL; DigiKey 311-10.0KLRCT-ND
R25, R26: 2.20K; R_0402_1005Metric; MPN RC0402FR-072K2L; DigiKey 311-2.20KLRCT-ND
R27: 330; R_0402_1005Metric; MPN RC0402FR-07330RL; DigiKey 311-330LRCT-ND
R28: 1.00K; R_0402_1005Metric; MPN RC0402FR-071KL; DigiKey 311-1.00KLRCT-ND
SW1: BOOT; SW_SPST_PTS810; MPN PTS810 SJM 250 SMTR LFS; DigiKey CKN10502CT-ND
U3: STM32F405RGT6; LQFP-64_10x10mm_P0.5mm; MPN STM32F405RGT6; DigiKey 497-11767-ND
Y1: 8MHz; Crystal_SMD_3225-4Pin_3.2x2.5mm; MPN ECS-80-8-33-JEN-TR3; DigiKey 50-ECS-80-8-33-JEN-TR3CT-ND

Connections:
3V3: C25.1, C26.1, C27.1, C28.1, C29.1, C30.1, FB1.1, R18.1, R19.1, R20.1, R25.1, R26.1, R27.1, R28.1, SW1.1, U3.1 (VBAT), U3.19 (VDD), U3.32 (VDD), U3.48 (VDD), U3.64 (VDD); also elsewhere on the board
3V3A: C31.1, C32.1, FB1.2, U3.13 (VDDA)
BEEPER: R17.1, U3.28 (PB2); also elsewhere on the board
BOOT0: R16.1, SW1.2, U3.60 (BOOT0)
CAM_SEL: U3.2 (PC13); also elsewhere on the board
CURR_ADC: U3.9 (PC1); also elsewhere on the board
ESC_TLM: U3.15 (PA1); also elsewhere on the board
FLASH_CS: R20.2, U3.58 (PB6); also elsewhere on the board
GND: C25.2, C26.2, C27.2, C28.2, C29.2, C30.2, C31.2, C32.2, C33.2, C34.2, C35.2, C36.2, C37.2, R16.2, R17.2, U3.12 (VSSA), U3.18 (VSS), U3.63 (VSS), Y1.2 (G), Y1.4 (G); also elsewhere on the board
GYRO1_CS: R18.2, U3.20 (PA4); also elsewhere on the board
GYRO1_INT: U3.24 (PC4); also elsewhere on the board
GYRO2_CS: R19.2, U3.50 (PA15); also elsewhere on the board
GYRO2_INT: U3.3 (PC14); also elsewhere on the board
HSE_IN: C36.1, U3.5 (PH0), Y1.1
HSE_OUT: C37.1, U3.6 (PH1), Y1.3
I2C1_SCL: R25.2, U3.61 (PB8); also elsewhere on the board
I2C1_SDA: R26.2, U3.62 (PB9); also elsewhere on the board
LED_BLUE_A: D11.2 (A), R27.2
LED_GREEN_A: D12.2 (A), R28.2
LED_STRIP: U3.41 (PA8); also elsewhere on the board
MOTOR1: U3.26 (PB0); also elsewhere on the board
MOTOR2: U3.27 (PB1); also elsewhere on the board
MOTOR3: U3.29 (PB10); also elsewhere on the board
MOTOR4: U3.30 (PB11); also elsewhere on the board
MOTOR5: U3.39 (PC8); also elsewhere on the board
MOTOR6: U3.40 (PC9); also elsewhere on the board
MOTOR7: U3.59 (PB7); also elsewhere on the board
MOTOR8: U3.14 (PA0); also elsewhere on the board
NRST: C35.1, U3.7 (NRST); also elsewhere on the board
RSSI_ADC: U3.25 (PC5); also elsewhere on the board
SPI1_MISO: U3.22 (PA6); also elsewhere on the board
SPI1_MOSI: U3.23 (PA7); also elsewhere on the board
SPI1_SCK: U3.21 (PA5); also elsewhere on the board
SPI3_MISO: U3.56 (PB4); also elsewhere on the board
SPI3_MOSI: U3.57 (PB5); also elsewhere on the board
SPI3_SCK: U3.55 (PB3); also elsewhere on the board
STATUS_LED_BLUE: D11.1 (K), U3.35 (PB14)
STATUS_LED_GREEN: D12.1 (K), U3.36 (PB15)
SWCLK: U3.49 (PA14); also elsewhere on the board
SWDIO: U3.46 (PA13); also elsewhere on the board
UART1_RX: U3.43 (PA10); also elsewhere on the board
UART1_TX: U3.42 (PA9); also elsewhere on the board
UART2_RX: U3.17 (PA3); also elsewhere on the board
UART2_TX: U3.16 (PA2); also elsewhere on the board
UART3_RX: U3.52 (PC11); also elsewhere on the board
UART3_TX: U3.51 (PC10); also elsewhere on the board
UART5_RX: U3.54 (PD2); also elsewhere on the board
UART5_TX: U3.53 (PC12); also elsewhere on the board
UART6_RX: U3.38 (PC7); also elsewhere on the board
UART6_TX: U3.37 (PC6); also elsewhere on the board
USB_DM: U3.44 (PA11); also elsewhere on the board
USB_DP: U3.45 (PA12); also elsewhere on the board
VBAT_ADC: U3.8 (PC0); also elsewhere on the board
VCAP1: C33.1, U3.31 (VCAP_1)
VCAP2: C34.1, U3.47 (VCAP_2)
VTX_PWR_EN: U3.4 (PC15); also elsewhere on the board

Notes on the sheet:
U3 STM32F405RGT6 - MCU 168 MHz Cortex-M4F, LQFP-64
Y1 8MHz - 8 MHz HSE crystal, CL 8 pF
3V3 decoupling / bulk
3V3A decoupling / bulk
MCU: pin map design/pinmap.md rev C. PC2/PC3/PB12/PB13 unused (OSD removed, D-01).

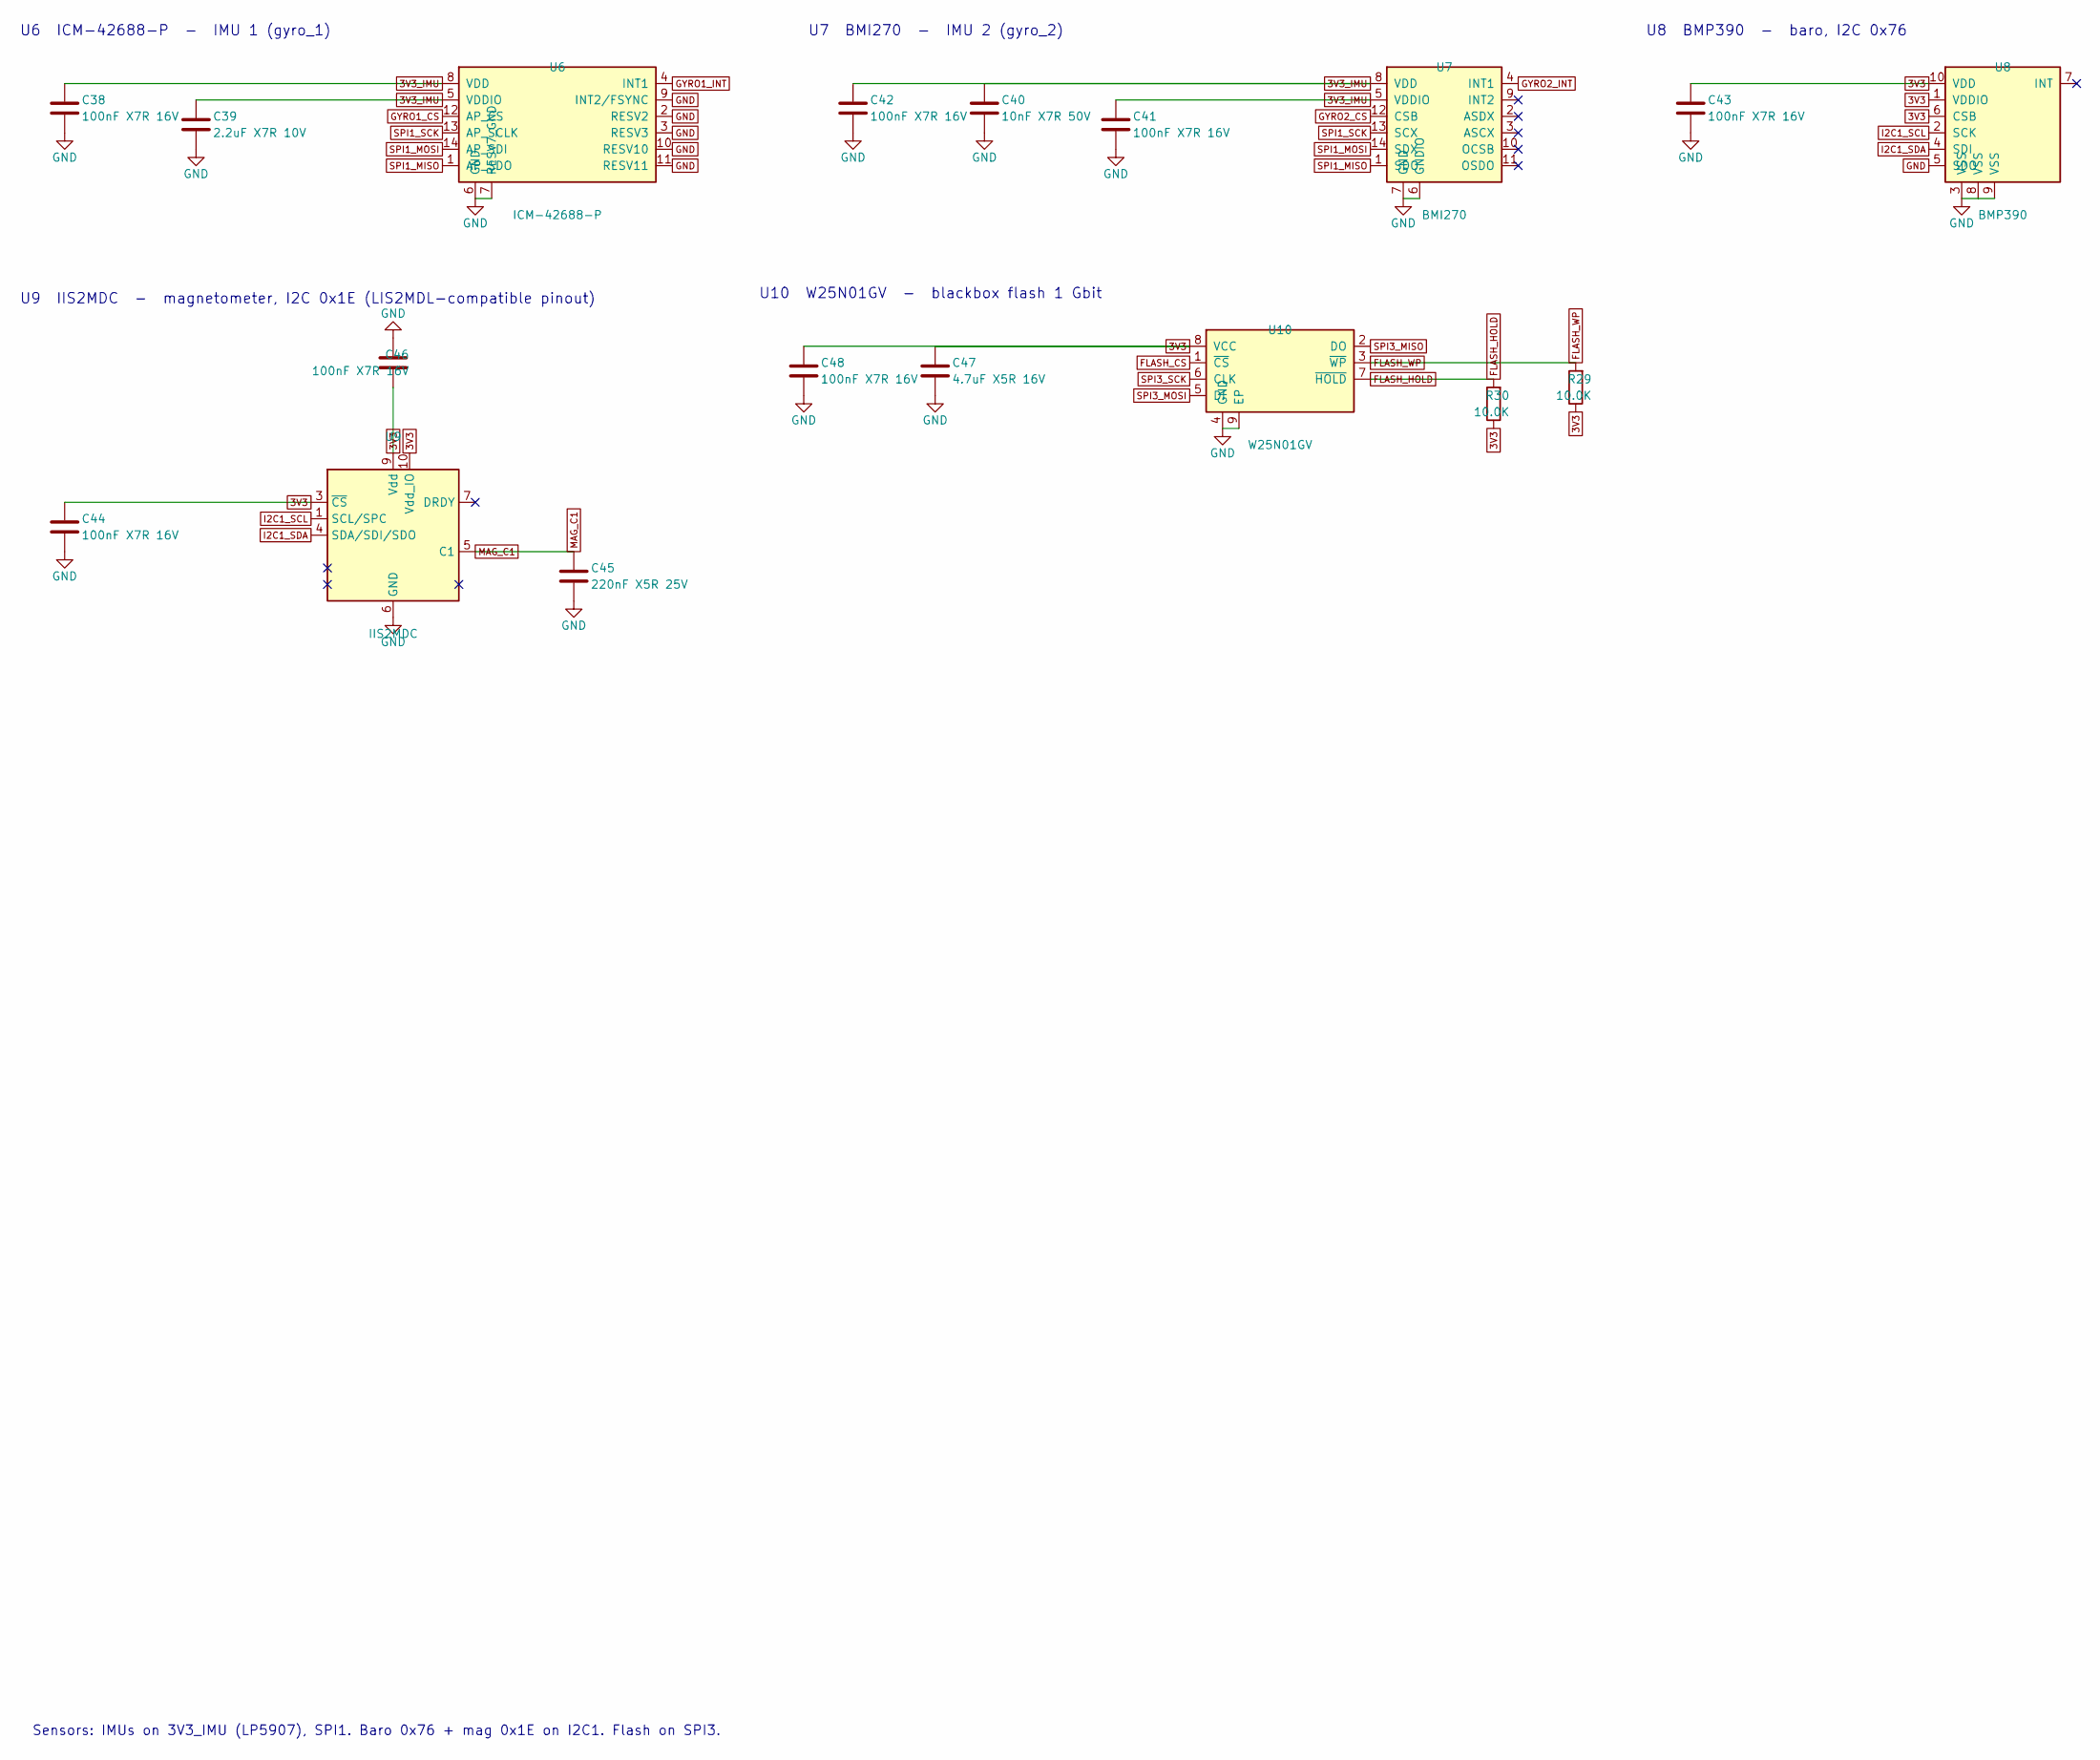
[picture p23: schematic sensors.kicad_sch, F405-FC flight controller - Sensors]

Parts:
C38, C41, C42, C43, C44, C46, C48: 100nF X7R 16V; C_0402_1005Metric; MPN CL05B104KO5NNNC; DigiKey 1276-1001-1-ND
C39: 2.2uF X7R 10V; C_0603_1608Metric; MPN CL10B225KP8NNNC; DigiKey 1276-1134-1-ND
C40: 10nF X7R 50V; C_0402_1005Metric; MPN CL05B103KB5NNNC; DigiKey 1276-1028-1-ND
C45: 220nF X5R 25V; C_0402_1005Metric; MPN CL05A224KA5NNNC; DigiKey 1276-1455-1-ND
C47: 4.7uF X5R 16V; C_0603_1608Metric; MPN CL10A475KO8NNNC; DigiKey 1276-1784-1-ND
R29, R30: 10.0K; R_0402_1005Metric; MPN RC0402FR-0710KL; DigiKey 311-10.0KLRCT-ND
U6: ICM-42688-P; LGA-14_3x2.5mm_P0.5mm_LayoutBorder3x4y; MPN ICM-42688-P; DigiKey 1428-ICM-42688-PCT-ND
U7: BMI270; Bosch_LGA-14_3x2.5mm_P0.5mm_BMI270; MPN BMI270; DigiKey 828-1091-1-ND
U8: BMP390; Bosch_LGA-10_2x2mm_P0.5mm_BMP390; MPN BMP390; DigiKey 828-BMP390CT-ND
U9: IIS2MDC; LGA-12_2x2mm_P0.5mm; MPN IIS2MDCTR; DigiKey 497-17728-1-ND
U10: W25N01GV; WSON-8-1EP_8x6mm_P1.27mm_EP3.4x4.3mm; MPN W25N01GVZEIG TR; DigiKey 256-W25N01GVZEIGTRCT-ND

Connections:
3V3: C43.1, C44.1, C46.1, C47.1, C48.1, R29.1, R30.1, U8.1 (VDDIO), U8.6 (CSB), U8.10 (VDD), U9.3 (~CS), U9.9 (Vdd), U9.10 (Vdd_IO), U10.8 (VCC); also elsewhere on the board
3V3_IMU: C38.1, C39.1, C40.1, C41.1, C42.1, U6.5 (VDDIO), U6.8 (VDD), U7.5 (VDDIO), U7.8 (VDD); also elsewhere on the board
FLASH_CS: U10.1 (~CS); also elsewhere on the board
FLASH_HOLD: R30.2, U10.7 (~HOLD)
FLASH_WP: R29.2, U10.3 (~WP)
GND: C38.2, C39.2, C40.2, C41.2, C42.2, C43.2, C44.2, C45.2, C46.2, C47.2, C48.2, U6.2 (RESV2), U6.3 (RESV3), U6.6 (GND), U6.7 (RESV7_GND), U6.9 (INT2/FSYNC), U6.10 (RESV10), U6.11 (RESV11), U7.6 (GNDIO), U7.7 (GND), U8.3 (VSS), U8.5 (SDO), U8.8 (VSS), U8.9 (VSS), U9.6 (GND), U9.8 (GND), U10.4 (GND), U10.9 (EP); also elsewhere on the board
GYRO1_CS: U6.12 (AP_CS); also elsewhere on the board
GYRO1_INT: U6.4 (INT1); also elsewhere on the board
GYRO2_CS: U7.12 (CSB); also elsewhere on the board
GYRO2_INT: U7.4 (INT1); also elsewhere on the board
I2C1_SCL: U8.2 (SCK), U9.1 (SCL/SPC); also elsewhere on the board
I2C1_SDA: U8.4 (SDI), U9.4 (SDA/SDI/SDO); also elsewhere on the board
MAG_C1: C45.1, U9.5 (C1)
SPI1_MISO: U6.1 (AP_SDO), U7.1 (SDO); also elsewhere on the board
SPI1_MOSI: U6.14 (AP_SDI), U7.14 (SDX); also elsewhere on the board
SPI1_SCK: U6.13 (AP_SCLK), U7.13 (SCX); also elsewhere on the board
SPI3_MISO: U10.2 (DO); also elsewhere on the board
SPI3_MOSI: U10.5 (DI); also elsewhere on the board
SPI3_SCK: U10.6 (CLK); also elsewhere on the board

Notes on the sheet:
U6 ICM-42688-P - IMU 1 (gyro_1)
U7 BMI270 - IMU 2 (gyro_2)
U8 BMP390 - baro, I2C 0x76
U9 IIS2MDC - magnetometer, I2C 0x1E (LIS2MDL-compatible pinout)
U10 W25N01GV - blackbox flash 1 Gbit
Sensors: IMUs on 3V3_IMU (LP5907), SPI1. Baro 0x76 + mag 0x1E on I2C1. Flash on SPI3.
