FallenFireGit/F405-FC/kicad/F405FC.kicad_pcb

## KiCad design kicad/F405FC.kicad_pcb (continued)

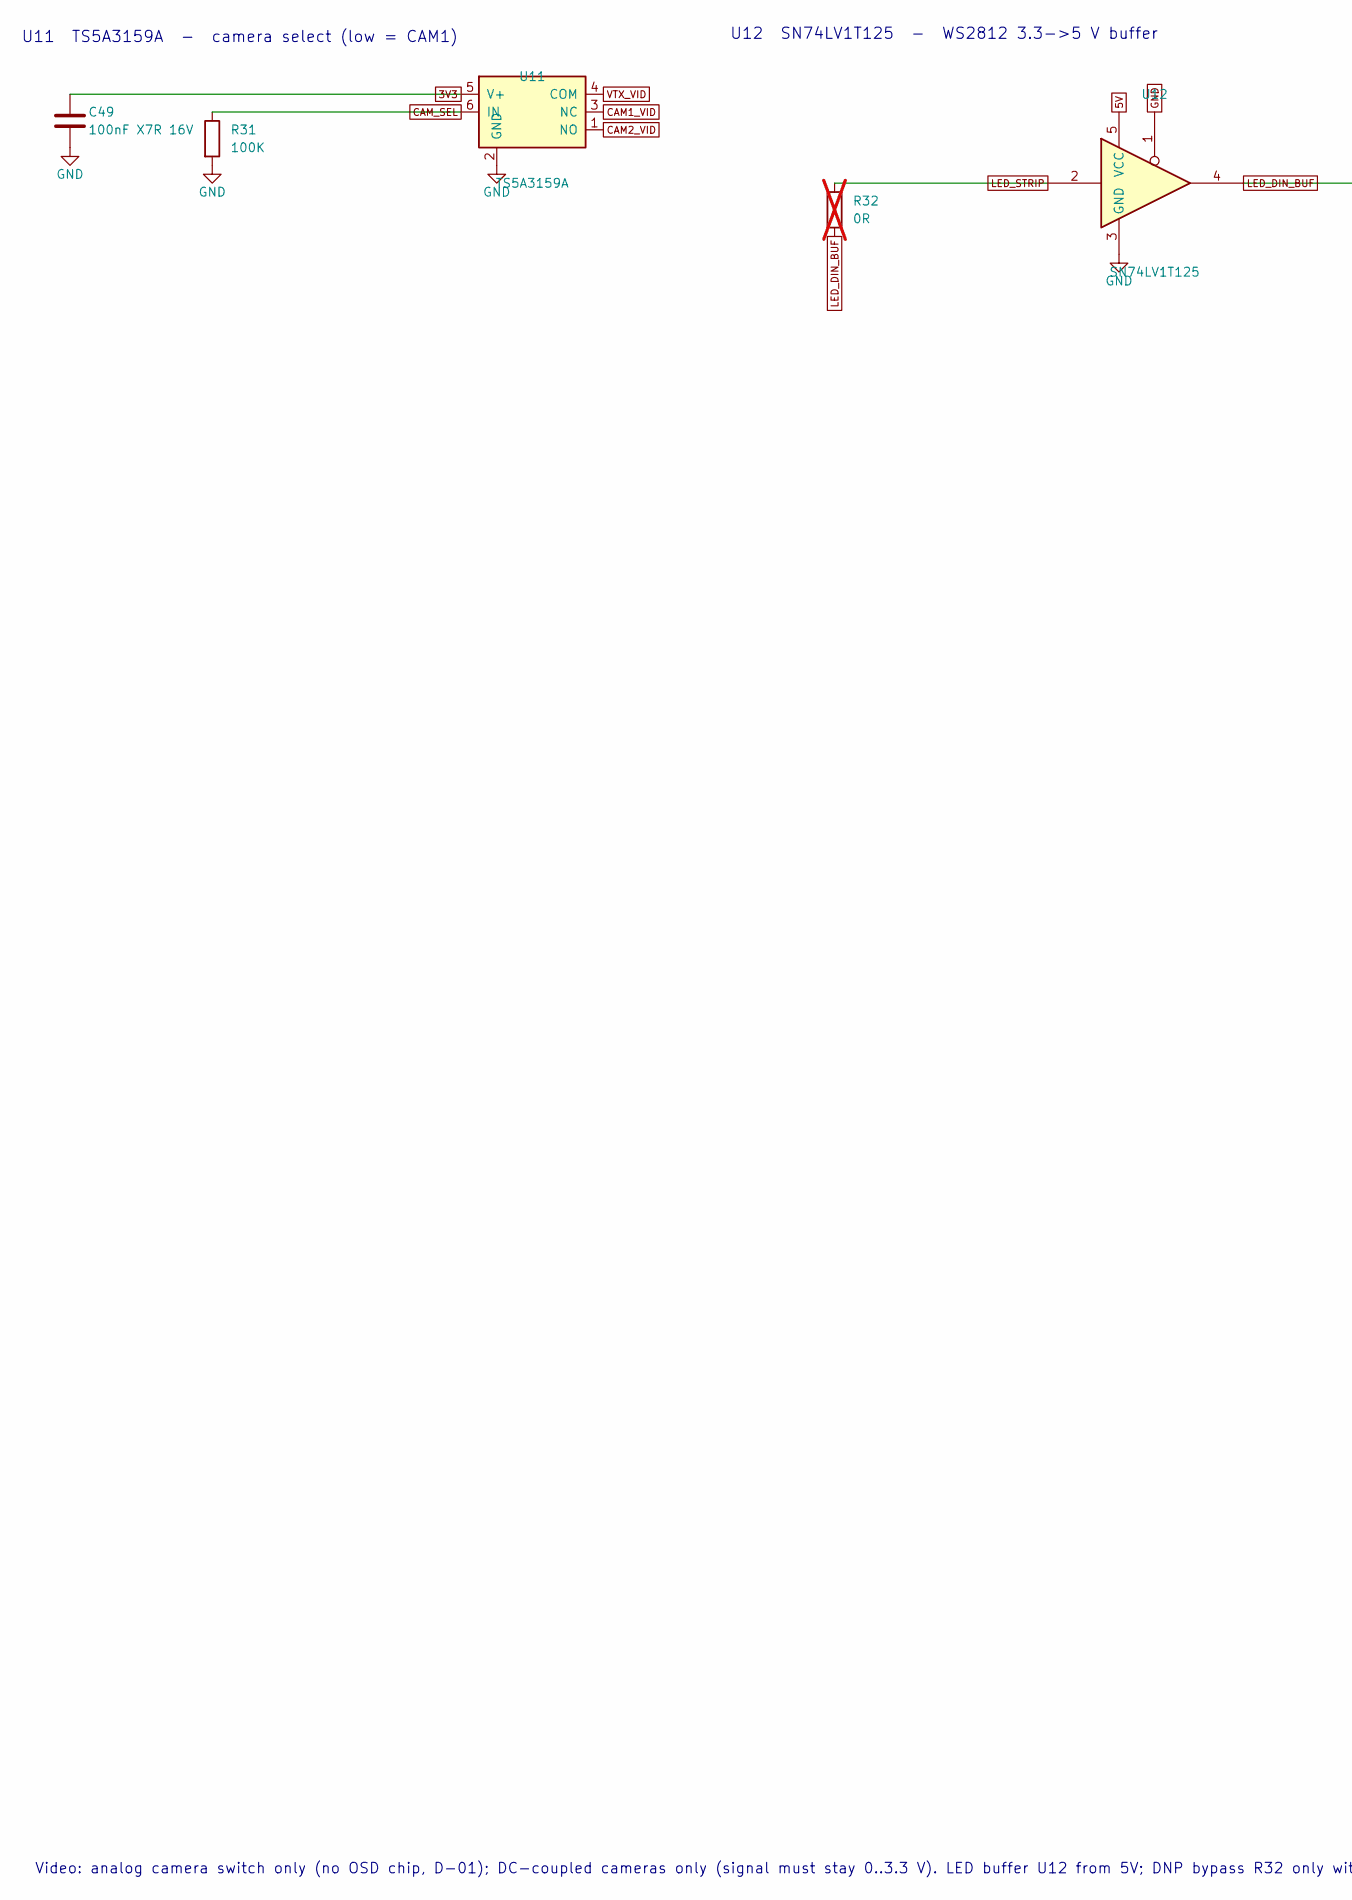
[picture p24: schematic video.kicad_sch, F405-FC flight controller - Video, part in row 1, column 1]

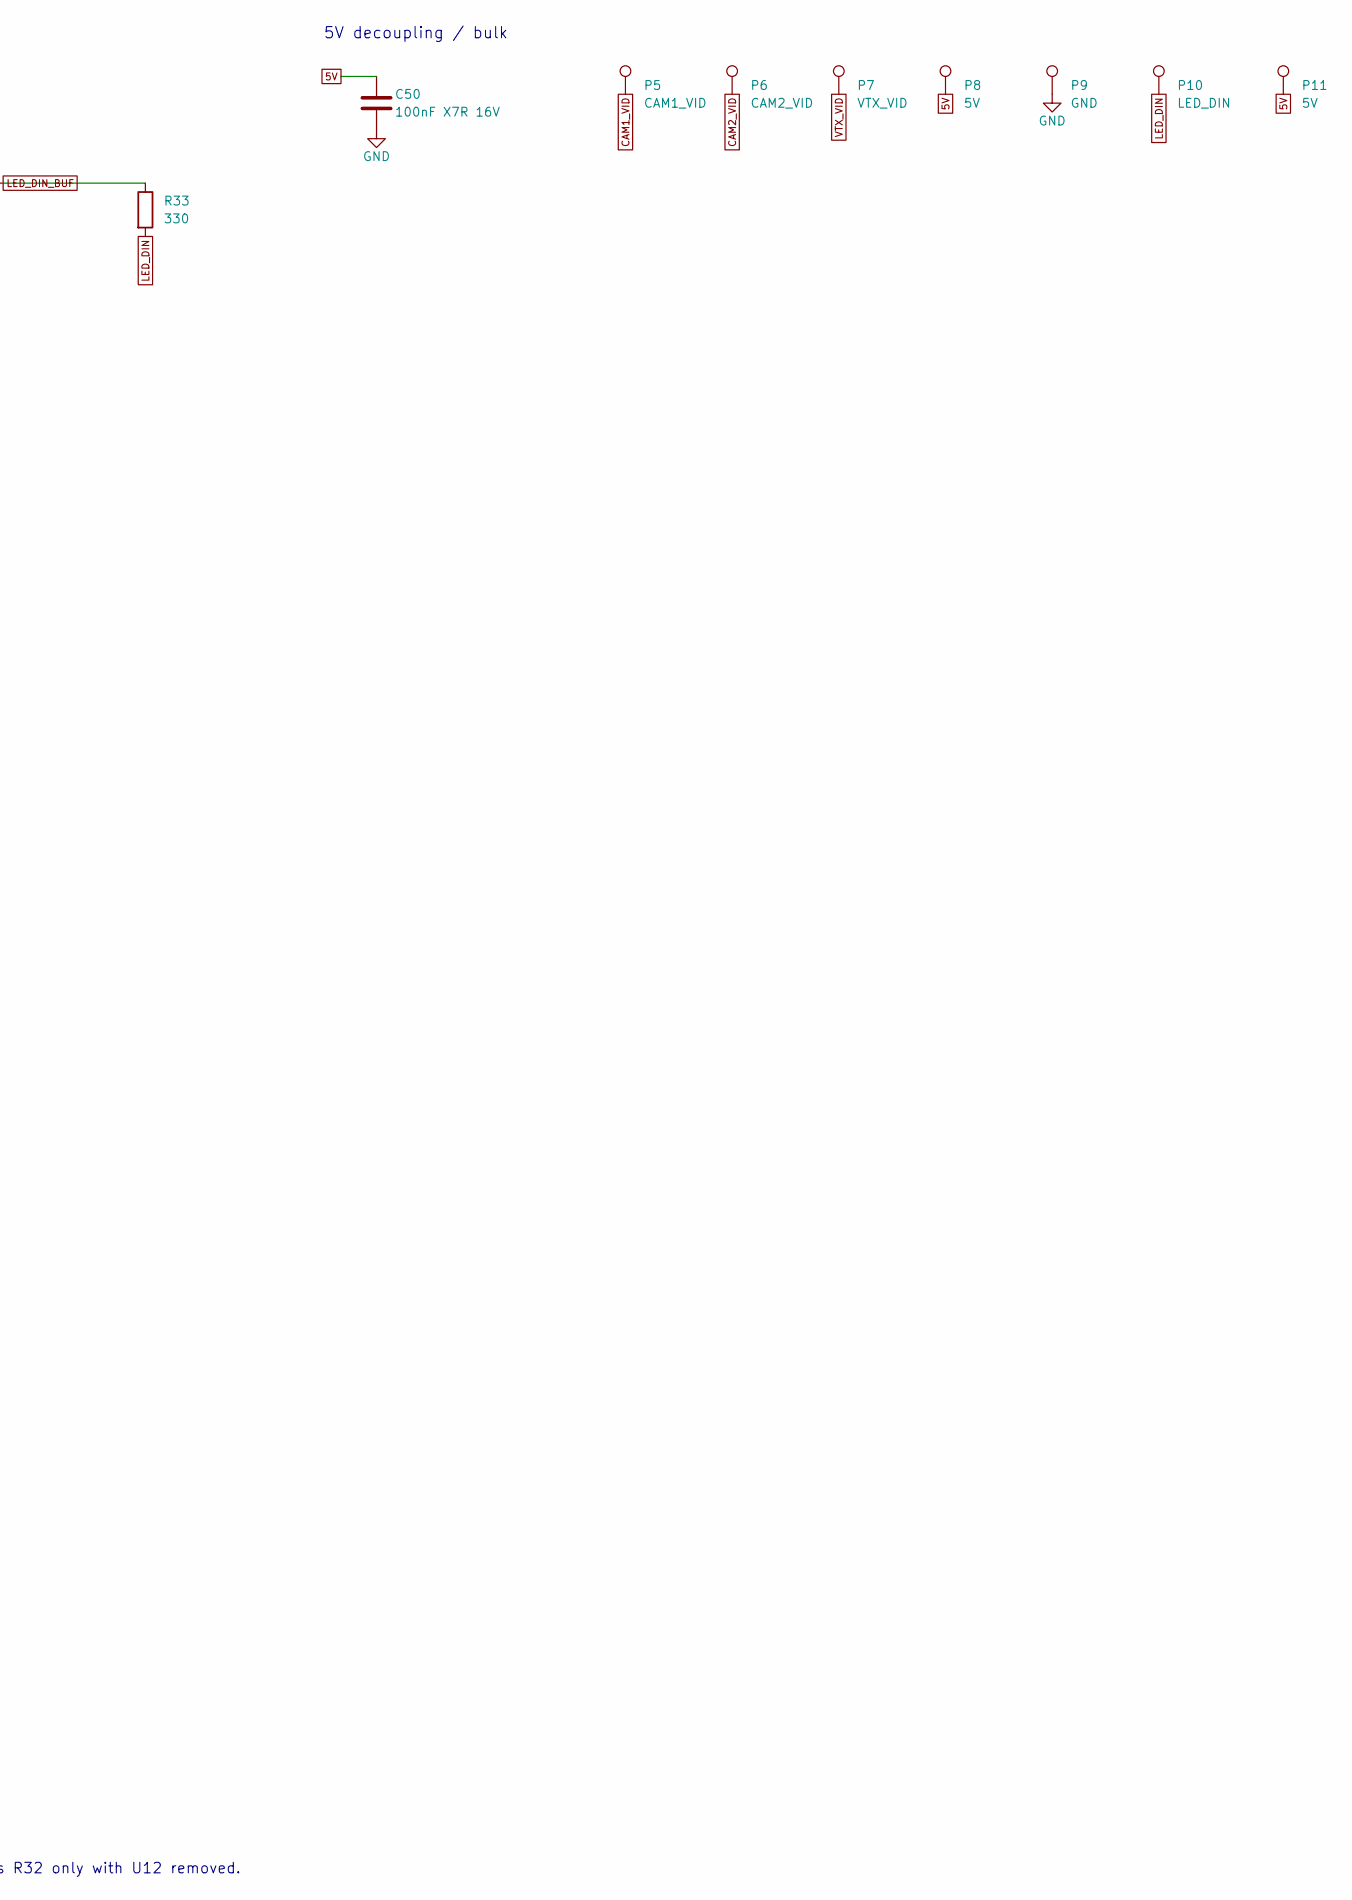
[picture p25: schematic video.kicad_sch, F405-FC flight controller - Video, part in row 1, column 2]

Parts:
C49, C50: 100nF X7R 16V; C_0402_1005Metric; MPN CL05B104KO5NNNC; DigiKey 1276-1001-1-ND
P5: CAM1_VID; Pad_SMD_1.2x1.6mm; MPN n/a (PCB pad); DigiKey n/a (PCB pad)
P6: CAM2_VID; Pad_SMD_1.2x1.6mm; MPN n/a (PCB pad); DigiKey n/a (PCB pad)
P7: VTX_VID; Pad_SMD_1.2x1.6mm; MPN n/a (PCB pad); DigiKey n/a (PCB pad)
P8: 5V; Pad_SMD_1.2x1.6mm; MPN n/a (PCB pad); DigiKey n/a (PCB pad)
P9: GND; Pad_SMD_1.2x1.6mm; MPN n/a (PCB pad); DigiKey n/a (PCB pad)
P10: LED_DIN; Pad_SMD_1.2x1.6mm; MPN n/a (PCB pad); DigiKey n/a (PCB pad)
P11: 5V; Pad_SMD_1.5x2.0mm; MPN n/a (PCB pad); DigiKey n/a (PCB pad)
R31: 100K; R_0402_1005Metric; MPN RC0402FR-07100KL; DigiKey 311-100KLRCT-ND
R32: 0R; R_0402_1005Metric; MPN RC0402JR-070RL; DigiKey 311-0.0JRCT-ND; not fitted
R33: 330; R_0402_1005Metric; MPN RC0402FR-07330RL; DigiKey 311-330LRCT-ND
U11: TS5A3159A; SOT-23-6; MPN TS5A3159ADBVR; DigiKey 296-19265-1-ND
U12: SN74LV1T125; SOT-23-5; MPN SN74LV1T125DBVR; DigiKey 296-37172-1-ND

Connections:
3V3: C49.1, U11.5 (V+); also elsewhere on the board
5V: C50.1, P8.1, P11.1, U12.5 (VCC); also elsewhere on the board
CAM1_VID: P5.1, U11.3 (NC)
CAM2_VID: P6.1, U11.1 (NO)
CAM_SEL: R31.1, U11.6 (IN); also elsewhere on the board
GND: C49.2, C50.2, P9.1, R31.2, U11.2 (GND), U12.1, U12.3 (GND); also elsewhere on the board
LED_DIN: P10.1, R33.2
LED_DIN_BUF: R32.2, R33.1, U12.4
LED_STRIP: R32.1, U12.2; also elsewhere on the board
VTX_VID: P7.1, U11.4 (COM)

Notes on the sheet:
U11 TS5A3159A - camera select (low = CAM1)
U12 SN74LV1T125 - WS2812 3.3->5 V buffer
5V decoupling / bulk
Video: analog camera switch only (no OSD chip, D-01); DC-coupled cameras only (signal must stay 0..3.3 V). LED buffer U12 from 5V; DNP bypass R32 only with U12 removed.

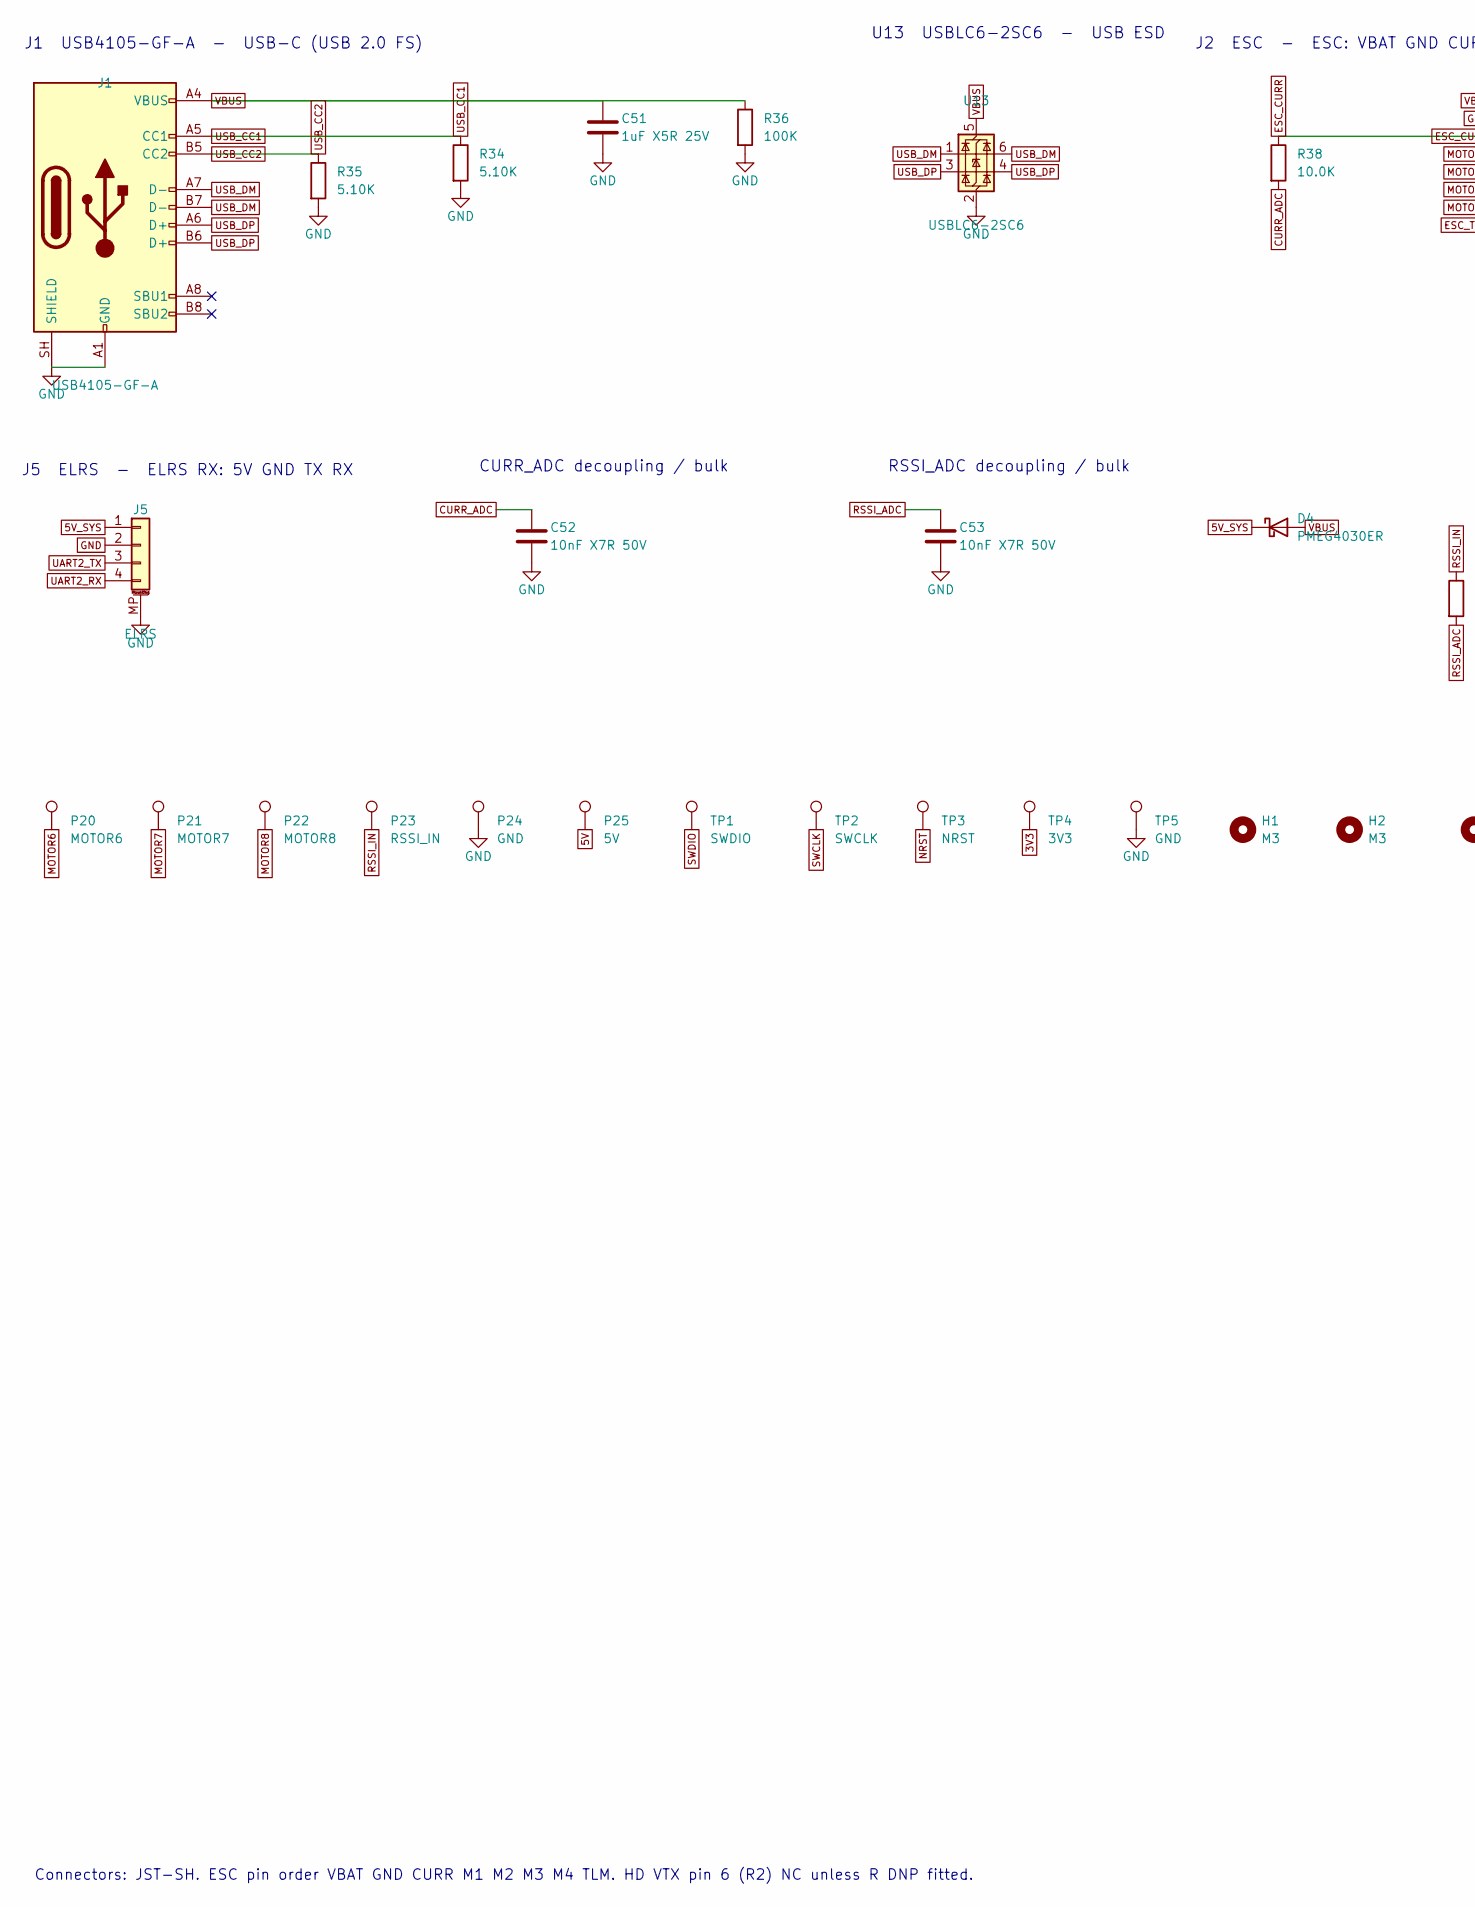
[picture p26: schematic connectors.kicad_sch, F405-FC flight controller - Connectors, part in row 1, column 1]

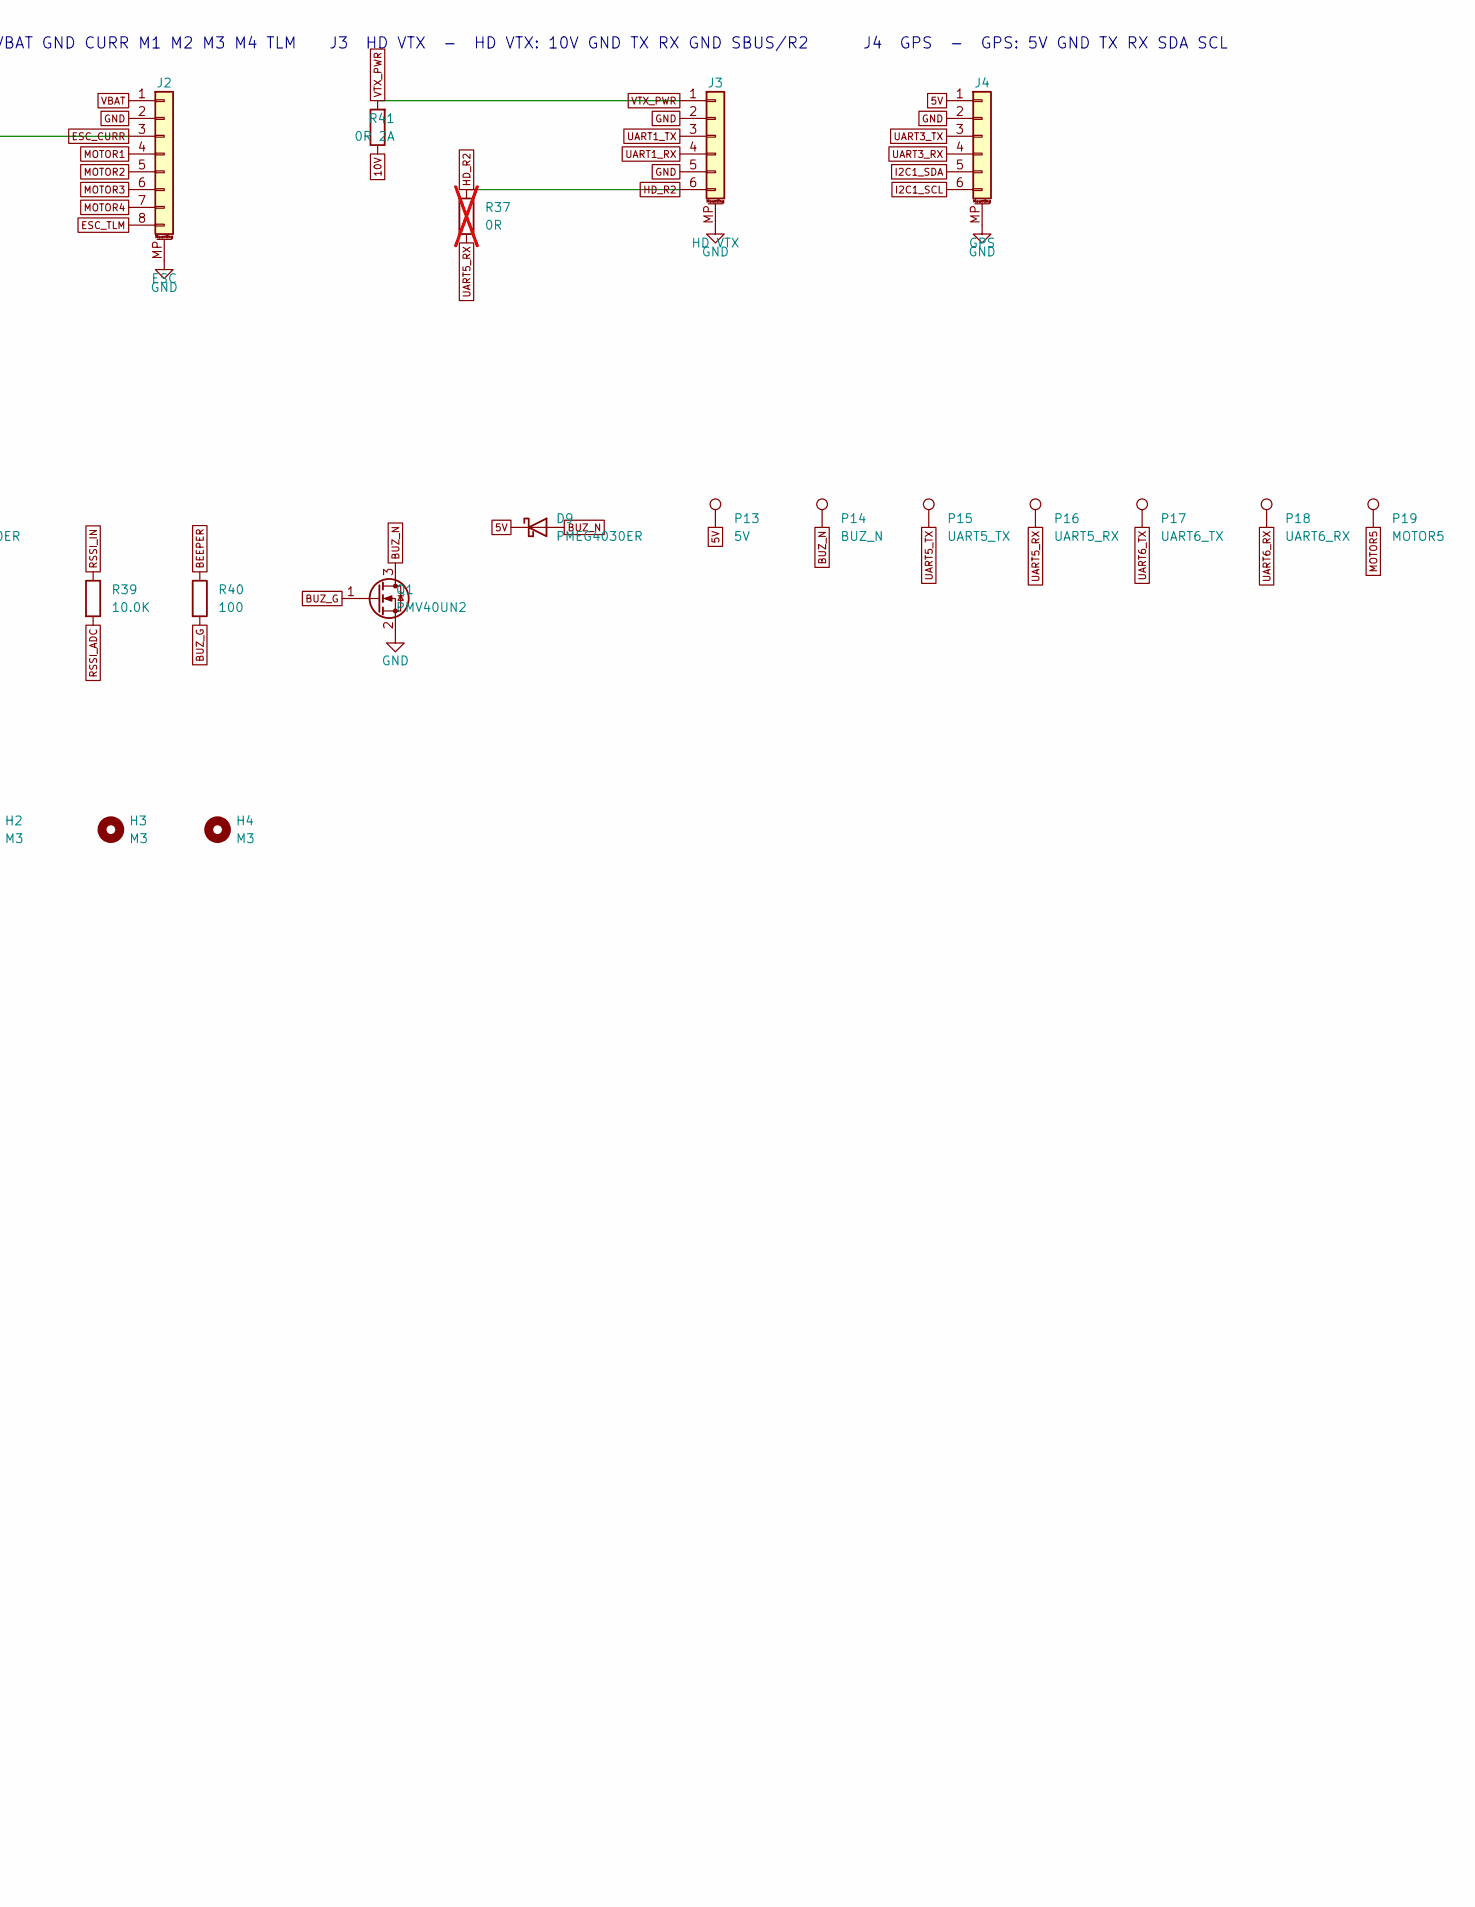
[picture p27: schematic connectors.kicad_sch, F405-FC flight controller - Connectors, part in row 1, column 2]

Parts:
C51: 1uF X5R 25V; C_0603_1608Metric; MPN CL10A105KA8NNNC; DigiKey 1276-1102-1-ND (verify)
C52, C53: 10nF X7R 50V; C_0402_1005Metric; MPN CL05B103KB5NNNC; DigiKey 1276-1028-1-ND
D4, D9: PMEG4030ER; Nexperia_CFP3_SOD-123W; MPN PMEG4030ER,115; DigiKey 1727-5313-1-ND
H1, H2, H3, H4: M3; MountingHole_3.2mm_M3_Grommet4.6mm; MPN n/a (hole); DigiKey n/a (hole)
J1: USB4105-GF-A; USB_C_Receptacle_GCT_USB4105-xx-A_16P_TopMnt_Horizontal; MPN USB4105-GF-A; DigiKey 2073-USB4105-GF-ACT-ND
J2: ESC; JST_SH_SM08B-SRSS-TB_1x08-1MP_P1.00mm_Horizontal; MPN SM08B-SRSS-TB(LF)(SN); DigiKey 455-1808-1-ND
J3: HD VTX; JST_SH_SM06B-SRSS-TB_1x06-1MP_P1.00mm_Horizontal; MPN SM06B-SRSS-TB(LF)(SN); DigiKey 455-1806-1-ND
J4: GPS; JST_SH_SM06B-SRSS-TB_1x06-1MP_P1.00mm_Horizontal; MPN SM06B-SRSS-TB(LF)(SN); DigiKey 455-1806-1-ND
J5: ELRS; JST_SH_SM04B-SRSS-TB_1x04-1MP_P1.00mm_Horizontal; MPN SM04B-SRSS-TB(LF)(SN); DigiKey 455-1804-1-ND
P13, P25: 5V; Pad_SMD_1.2x1.6mm; MPN n/a (PCB pad); DigiKey n/a (PCB pad)
P14: BUZ_N; Pad_SMD_1.2x1.6mm; MPN n/a (PCB pad); DigiKey n/a (PCB pad)
P15: UART5_TX; Pad_SMD_1.2x1.6mm; MPN n/a (PCB pad); DigiKey n/a (PCB pad)
P16: UART5_RX; Pad_SMD_1.2x1.6mm; MPN n/a (PCB pad); DigiKey n/a (PCB pad)
P17: UART6_TX; Pad_SMD_1.2x1.6mm; MPN n/a (PCB pad); DigiKey n/a (PCB pad)
P18: UART6_RX; Pad_SMD_1.2x1.6mm; MPN n/a (PCB pad); DigiKey n/a (PCB pad)
P19: MOTOR5; Pad_SMD_1.2x1.6mm; MPN n/a (PCB pad); DigiKey n/a (PCB pad)
P20: MOTOR6; Pad_SMD_1.2x1.6mm; MPN n/a (PCB pad); DigiKey n/a (PCB pad)
P21: MOTOR7; Pad_SMD_1.2x1.6mm; MPN n/a (PCB pad); DigiKey n/a (PCB pad)
P22: MOTOR8; Pad_SMD_1.2x1.6mm; MPN n/a (PCB pad); DigiKey n/a (PCB pad)
P23: RSSI_IN; Pad_SMD_1.2x1.6mm; MPN n/a (PCB pad); DigiKey n/a (PCB pad)
P24: GND; Pad_SMD_1.2x1.6mm; MPN n/a (PCB pad); DigiKey n/a (PCB pad)
Q1: PMV40UN2; SOT-23; MPN PMV40UN2R; DigiKey 1727-1900-1-ND
R34, R35: 5.10K; R_0402_1005Metric; MPN RC0402FR-075K1L; DigiKey 311-5.10KLRCT-ND
R36: 100K; R_0402_1005Metric; MPN RC0402FR-07100KL; DigiKey 311-100KLRCT-ND
R37: 0R; R_0402_1005Metric; MPN RC0402JR-070RL; DigiKey 311-0.0JRCT-ND; not fitted
R38, R39: 10.0K; R_0402_1005Metric; MPN RC0402FR-0710KL; DigiKey 311-10.0KLRCT-ND
R40: 100; R_0402_1005Metric; MPN RC0402FR-07100RL; DigiKey 311-100LRCT-ND
R41: 0R 2A; R_0805_2012Metric; MPN RC0805JR-070RL; DigiKey 311-0.0ARCT-ND
TP1: SWDIO; TestPoint_Pad_D1.0mm; MPN n/a (test pad); DigiKey n/a (test pad)
TP2: SWCLK; TestPoint_Pad_D1.0mm; MPN n/a (test pad); DigiKey n/a (test pad)
TP3: NRST; TestPoint_Pad_D1.0mm; MPN n/a (test pad); DigiKey n/a (test pad)
TP4: 3V3; TestPoint_Pad_D1.0mm; MPN n/a (test pad); DigiKey n/a (test pad)
TP5: GND; TestPoint_Pad_D1.0mm; MPN n/a (test pad); DigiKey n/a (test pad)
U13: USBLC6-2SC6; SOT-23-6; MPN USBLC6-2SC6; DigiKey 497-5235-1-ND

Connections:
3V3: TP4.1; also elsewhere on the board
5V: D9.1 (K), J4.1, P13.1, P25.1; also elsewhere on the board
5V_SYS: D4.1 (K), J5.1; also elsewhere on the board
10V: R41.1; also elsewhere on the board
BEEPER: R40.1; also elsewhere on the board
BUZ_G: Q1.1 (G), R40.2
BUZ_N: D9.2 (A), P14.1, Q1.3 (D)
CURR_ADC: C52.1, R38.2; also elsewhere on the board
ESC_CURR: J2.3, R38.1
ESC_TLM: J2.8; also elsewhere on the board
GND: C51.2, C52.2, C53.2, J1.A1 (GND), J1.A12 (GND), J1.B1 (GND), J1.B12 (GND), J1.SH (SHIELD), J2.2, J2.MP (MountPin), J3.2, J3.5, J3.MP (MountPin), J4.2, J4.MP (MountPin), J5.2, J5.MP (MountPin), P24.1, Q1.2 (S), R34.2, R35.2, R36.2, TP5.1, U13.2 (GND); also elsewhere on the board
HD_R2: J3.6, R37.1
I2C1_SCL: J4.6; also elsewhere on the board
I2C1_SDA: J4.5; also elsewhere on the board
MOTOR1: J2.4; also elsewhere on the board
MOTOR2: J2.5; also elsewhere on the board
MOTOR3: J2.6; also elsewhere on the board
MOTOR4: J2.7; also elsewhere on the board
MOTOR5: P19.1; also elsewhere on the board
MOTOR6: P20.1; also elsewhere on the board
MOTOR7: P21.1; also elsewhere on the board
MOTOR8: P22.1; also elsewhere on the board
NRST: TP3.1; also elsewhere on the board
RSSI_ADC: C53.1, R39.2; also elsewhere on the board
RSSI_IN: P23.1, R39.1
SWCLK: TP2.1; also elsewhere on the board
SWDIO: TP1.1; also elsewhere on the board
UART1_RX: J3.4; also elsewhere on the board
UART1_TX: J3.3; also elsewhere on the board
UART2_RX: J5.4; also elsewhere on the board
UART2_TX: J5.3; also elsewhere on the board
UART3_RX: J4.4; also elsewhere on the board
UART3_TX: J4.3; also elsewhere on the board
UART5_RX: P16.1, R37.2; also elsewhere on the board
UART5_TX: P15.1; also elsewhere on the board
UART6_RX: P18.1; also elsewhere on the board
UART6_TX: P17.1; also elsewhere on the board
USB_CC1: J1.A5 (CC1), R34.1
USB_CC2: J1.B5 (CC2), R35.1
USB_DM: J1.A7 (D-), J1.B7 (D-), U13.1 (I/O1), U13.6 (I/O1); also elsewhere on the board
USB_DP: J1.A6 (D+), J1.B6 (D+), U13.3 (I/O2), U13.4 (I/O2); also elsewhere on the board
VBAT: J2.1; also elsewhere on the board
VBUS: C51.1, D4.2 (A), J1.A4 (VBUS), J1.A9 (VBUS), J1.B4 (VBUS), J1.B9 (VBUS), R36.1, U13.5 (VBUS)
VTX_PWR: J3.1, R41.2

Notes on the sheet:
J1 USB4105-GF-A - USB-C (USB 2.0 FS)
U13 USBLC6-2SC6 - USB ESD
J2 ESC - ESC: VBAT GND CURR M1 M2 M3 M4 TLM
J3 HD VTX - HD VTX: 10V GND TX RX GND SBUS/R2
J4 GPS - GPS: 5V GND TX RX SDA SCL
J5 ELRS - ELRS RX: 5V GND TX RX
CURR_ADC decoupling / bulk
RSSI_ADC decoupling / bulk
Connectors: JST-SH. ESC pin order VBAT GND CURR M1 M2 M3 M4 TLM. HD VTX pin 6 (R2) NC unless R DNP fitted.

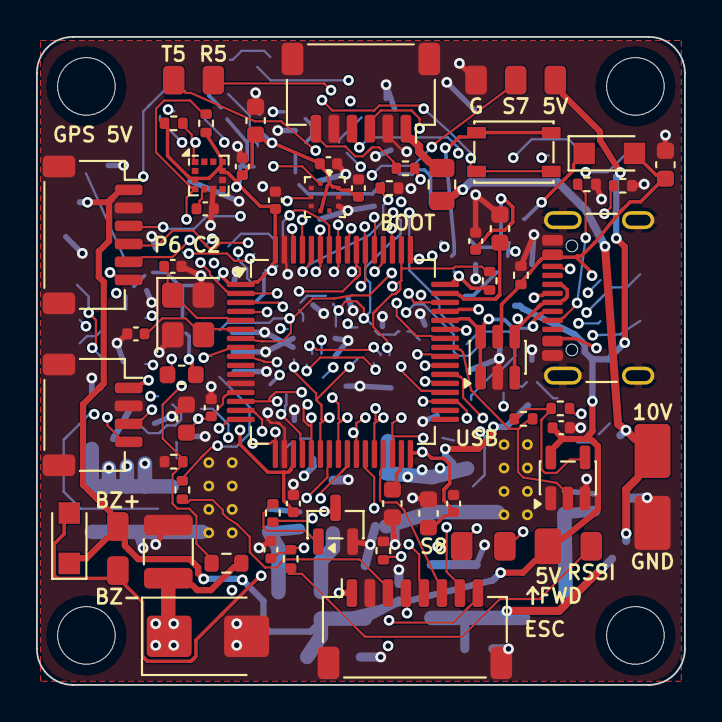
[picture p28: board F405FC.kicad_pcb from above]

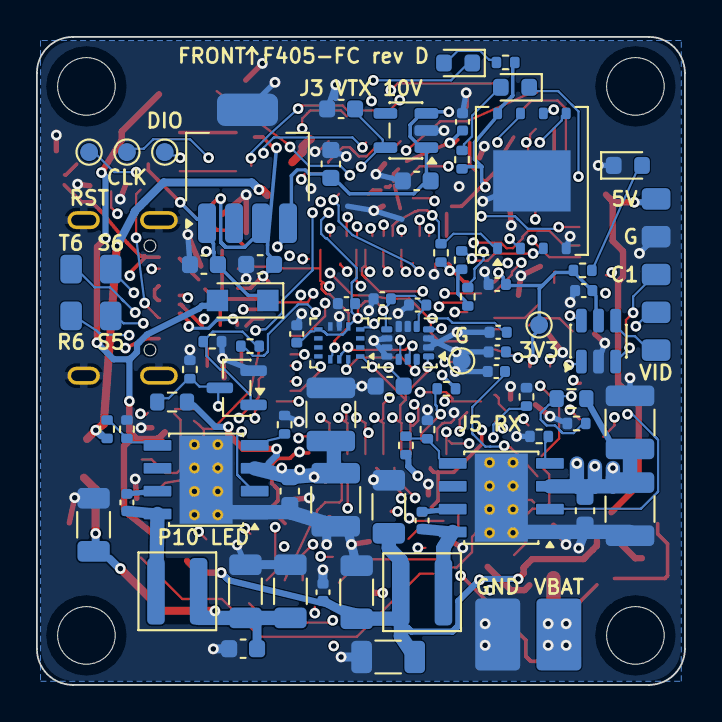
[picture p29: board F405FC.kicad_pcb from below]

Board: 6 copper layers, 36.0 x 36.0 mm, 154 parts (83 on the bottom side), 90 nets.
