FallenFireGit/F405-FC/docs/F405FC_betaflight_config.txt

# Betaflight / STM32F405 (S405) 4.5.x  --  unified-target style CLI config
# Board: F405FC (custom), STM32F405RGT6 LQFP-64
# Companion document: design/pinmap.md (pin table + DMA proof). Rev C, 2026-10-11
# Rev C: analog OSD (AT7456E) removed -> SPI2 unused, M7 (B07) gets DMA1 S3 (DShot);
#        PINIO1 (C15) = VTX OFF when high (pulls 10 V buck EN low).
# (Gate 0 audit fixes: beeper->PB2, CAM_SEL->PC13, ESC TLM->UART4 RX PA1,
#  M7 PB7 / M8 PA0 PWM-servo only, VBUS detect removed, UART5 full spare).
#
# Apply on a STM32F405 build with CLI 'defaults nosave' then paste. With a Configurator cloud build, tick the drivers
# explicitly: ICM42688P, BMI270, BMP388 (covers BMP390), the IIS2MDC/LIS2MDL mag driver and W25N01G flash; they are not
# all in a default build. The config.h appendix at the bottom is a sketch for a custom build: its macro names were not all
# found in the Betaflight sources on disk (Gate 6 m-6) and it has not been compiled.
# baro_hardware = BMP388 (the BMP390 uses the BMP388 driver, chip ID 0x60) and mag_hardware = LIS2MDL (IIS2MDC: industrial-grade variant of the LIS2MDL; register map not checked against an IIS2MDC datasheet),
# names from the Betaflight lookup tables in datasheets/bf_src/settings.c (Gate 6 G6B-04).

board_name F405FC
manufacturer_id CUST

# ---------------------------------------------------------------- resources
resource BEEPER 1 B02
resource MOTOR 1 B00
resource MOTOR 2 B01
resource MOTOR 3 B10
resource MOTOR 4 B11
resource MOTOR 5 C08
resource MOTOR 6 C09
resource MOTOR 7 B07
resource MOTOR 8 A00
resource LED_STRIP 1 A08
resource SERIAL_TX 1 A09
resource SERIAL_TX 2 A02
resource SERIAL_TX 3 C10
resource SERIAL_TX 5 C12
resource SERIAL_TX 6 C06
resource SERIAL_RX 1 A10
resource SERIAL_RX 2 A03
resource SERIAL_RX 3 C11
resource SERIAL_RX 4 A01
resource SERIAL_RX 5 D02
resource SERIAL_RX 6 C07
resource I2C_SCL 1 B08
resource I2C_SDA 1 B09
resource LED 1 B14
resource LED 2 B15
resource SPI_SCK 1 A05
resource SPI_SCK 3 B03
resource SPI_SDI 1 A06
resource SPI_SDI 3 B04
resource SPI_SDO 1 A07
resource SPI_SDO 3 B05
resource ADC_BATT 1 C00
resource ADC_RSSI 1 C05
resource ADC_CURR 1 C01
resource PINIO 1 C15
resource PINIO 2 C13
resource FLASH_CS 1 B06
resource GYRO_EXTI 1 C04
resource GYRO_EXTI 2 C14
resource GYRO_CS 1 A04
resource GYRO_CS 2 A15

# ---------------------------------------------------------------- timers
timer B00 AF2
# pin B00: TIM3 CH3 (AF2)          MOTOR 1
timer B01 AF2
# pin B01: TIM3 CH4 (AF2)          MOTOR 2
timer B10 AF1
# pin B10: TIM2 CH3 (AF1)          MOTOR 3
timer B11 AF1
# pin B11: TIM2 CH4 (AF1)          MOTOR 4
timer C08 AF3
# pin C08: TIM8 CH3 (AF3)          MOTOR 5 (extra pad)
timer C09 AF3
# pin C09: TIM8 CH4 (AF3)          MOTOR 6 (extra pad)
timer A08 AF1
# pin A08: TIM1 CH1 (AF1)          LED_STRIP
timer B07 AF2
# pin B07: TIM4 CH2 (AF2)          MOTOR 7 (extra pad, DShot capable)
timer A00 AF2
# pin A00: TIM5 CH1 (AF2)          MOTOR 8 (extra pad, PWM/servo only)

# ---------------------------------------------------------------- dma
# Peripherals (all pinned explicitly; see pinmap.md section 3)
dma SPI_SDO 1 0
# SPI_SDO 1: DMA2 Stream 3 Channel 3
dma SPI_SDI 1 0
# SPI_SDI 1: DMA2 Stream 0 Channel 3
dma SPI_SDO 3 0
# SPI_SDO 3: DMA1 Stream 5 Channel 0
dma SPI_SDI 3 0
# SPI_SDI 3: DMA1 Stream 0 Channel 0
dma ADC 1 1
# ADC 1: DMA2 Stream 4 Channel 0   (opt 0 = DMA2 S0 would steal SPI1 RX)

# Timer pins
dma pin B00 0
# pin B00: DMA1 Stream 7 Channel 5
dma pin B01 0
# pin B01: DMA1 Stream 2 Channel 5
dma pin B10 0
# pin B10: DMA1 Stream 1 Channel 3
dma pin B11 1
# pin B11: DMA1 Stream 6 Channel 3 (opt 0 = DMA1 S7 is used by B00)
dma pin C08 0
# pin C08: DMA2 Stream 2 Channel 0
dma pin C09 0
# pin C09: DMA2 Stream 7 Channel 7
dma pin A08 0
# pin A08: DMA2 Stream 6 Channel 0
dma pin B07 0
# pin B07: DMA1 Stream 3 Channel 2 (free since SPI2/OSD removed) -> DShot capable
dma pin A00 NONE
# pin A00: no DMA (only option DMA1 S2 Ch6 = M2)     -> PWM/servo only, no DShot

# DMA1: S0 SPI3_RX | S1 M3 | S2 M2 | S3 M7 | S4 free | S5 SPI3_TX | S6 M4 | S7 M1
# DMA2: S0 SPI1_RX | S1 free | S2 M5 | S3 SPI1_TX | S4 ADC1 | S5 free | S6 LED_STRIP | S7 M6
# M8 (A00): no DMA. Use as a servo (resource SERVO n A00) or PWM/Oneshot.
# An 8-motor mixer with DShot will NOT work on M8 (7 DShot motors do).

# ---------------------------------------------------------------- features
feature RX_SERIAL
feature OSD
feature LED_STRIP
feature TELEMETRY
feature ESC_SENSOR

# ---------------------------------------------------------------- serial
# serial <id> <functionMask> <mspBaud> <gpsBaud> <telemetryBaud> <blackboxBaud>
# UART1 (0): HD VTX MSP DisplayPort  -> MSP(1) + VTX_MSP(131072)
serial 0 131073 115200 57600 0 115200
# UART2 (1): ELRS receiver           -> SERIAL_RX(64)
serial 1 64 115200 57600 0 115200
# UART3 (2): GPS                     -> GPS(2)
serial 2 2 115200 57600 0 115200
# UART4 (3): ESC telemetry, RX-only on PA1 (TX pin PA0 is MOTOR 8) -> ESC_SENSOR(1024)
serial 3 1024 115200 57600 0 115200
# UART5 (4): spare, full TX+RX (PD2 optionally gets HD SBUS/R2 via DNP 0R, no inverter)
serial 4 0 115200 57600 0 115200
# UART6 (5): spare
serial 5 0 115200 57600 0 115200
# VCP (20): USB MSP
serial 20 1 115200 57600 0 115200

# ---------------------------------------------------------------- master settings
set system_hse_mhz = 8

# Gyros: both on SPI1, separate CS + EXTI
set gyro_1_bustype = SPI
set gyro_1_spibus = 1
set gyro_1_sensor_align = CW270FLIP
set gyro_2_bustype = SPI
set gyro_2_spibus = 1
set gyro_2_sensor_align = CW0FLIP
set gyro_to_use = FIRST
# gyro_1 = ICM-42688-P (CS A04 / EXTI C04), gyro_2 = BMI270 (CS A15 / EXTI C14)
# Alignment (PROVISIONAL, Gate 3 G3-13): both IMUs on the bottom side, rot 0; board front = J3 (VTX) edge, marked by silk arrows ("FRONT" on the bottom, "FWD" on the top).
# Derived from datasheet axis figures, not yet bench-verified: confirm with the tilt test in docs/assembly_and_bringup.md §4.

# Barometer BMP390 (BF BMP388 driver) on I2C1, SDO strapped to GND -> 0x76
set baro_bustype = I2C
set baro_i2c_device = 1
set baro_hardware = BMP388

# Magnetometer IIS2MDC (BF LIS2MDL driver, fixed 0x1E) on I2C1 (shared with GPS pads)
set mag_bustype = I2C
set mag_i2c_device = 1
set mag_hardware = LIS2MDL

# I2C1: on-board 2.2k pull-ups fitted; 400 kHz for the off-board GPS-mag cable
set i2c1_pullup = OFF
set i2c1_clockspeed_khz = 400

# Blackbox W25N01GV on SPI3
set flash_spi_bus = 3
set blackbox_device = SPIFLASH

# Motors: timer DShot (NOT bit-bang: bit-bang needs TIM1/TIM8 and disables SPI DMA on DMA2)
set motor_pwm_protocol = DSHOT600
set dshot_bidir = ON
set dshot_bitbang = OFF
set dshot_burst = OFF

# Battery / current (ADC1: VBAT C00, CURR C01, RSSI C05)
set battery_meter = ADC
set current_meter = ADC
set vbat_scale = 110
# ibata_scale/offset depend on the ESC's current sensor -- placeholder, calibrate per ESC
set ibata_scale = 400
set ibata_offset = 0

# Beeper: PB2 (BOOT1 strap, 10k pulldown) drives an N-MOSFET gate, active HIGH.
# BF drives the pin LOW for "beep" unless inverted -> inversion ON = HIGH for beep.
set beeper_inversion = ON
set beeper_od = OFF

# Status LEDs PB14/PB15 wired 3V3 -> R -> LED -> pin (sink, low = on) = BF non-inverted
set led_inversion = 0

# PINIO1 (C15) = VTX power cut: HIGH turns Q2 on, which pulls the 10 V buck EN low (VTX OFF).
#   1 = output, normal: USER1 off -> pin LOW -> VTX ON (also ON through reset/DFU via 100k gate pulldown)
#   USER1 on -> pin HIGH -> VTX OFF (pit/power cut)
# PINIO2 (C13) = camera select (low = CAM1). 1 = output, normal: USER2 on -> CAM2
set pinio_config = 1,1,1,1
set pinio_box = 40,41,255,255

# Receiver
set serialrx_provider = CRSF

# OSD: no analog OSD chip on this board (D-01). MSP DisplayPort over UART1 to the HD VTX.
set osd_displayport_device = MSP

# ---------------------------------------------------------------------------
# APPENDIX: equivalent Betaflight 4.5 config.h (betaflight/config format)
# ---------------------------------------------------------------------------
# #pragma once
# #define FC_TARGET_MCU     STM32F405
# #define BOARD_NAME        F405FC
# #define MANUFACTURER_ID   CUST
#
# #define USE_ACC
# #define USE_GYRO
# #define USE_ACC_SPI_ICM42688P
# #define USE_GYRO_SPI_ICM42688P
# #define USE_ACCGYRO_BMI270
# #define USE_BARO
# #define USE_BARO_BMP388
# #define USE_MAG
# #define USE_MAG_LIS2MDL
# #define USE_FLASH
# #define USE_FLASH_W25N01G
#
# #define BEEPER_PIN           PB2
# #define MOTOR1_PIN           PB0
# #define MOTOR2_PIN           PB1
# #define MOTOR3_PIN           PB10
# #define MOTOR4_PIN           PB11
# #define MOTOR5_PIN           PC8
# #define MOTOR6_PIN           PC9
# #define MOTOR7_PIN           PB7
# #define MOTOR8_PIN           PA0
# #define LED_STRIP_PIN        PA8
# #define UART1_TX_PIN         PA9
# #define UART2_TX_PIN         PA2
# #define UART3_TX_PIN         PC10
# #define UART5_TX_PIN         PC12
# #define UART6_TX_PIN         PC6
# #define UART1_RX_PIN         PA10
# #define UART2_RX_PIN         PA3
# #define UART3_RX_PIN         PC11
# #define UART4_RX_PIN         PA1
# #define UART5_RX_PIN         PD2
# #define UART6_RX_PIN         PC7
# #define I2C1_SCL_PIN         PB8
# #define I2C1_SDA_PIN         PB9
# #define LED0_PIN             PB14
# #define LED1_PIN             PB15
# #define SPI1_SCK_PIN         PA5
# #define SPI3_SCK_PIN         PB3
# #define SPI1_SDI_PIN         PA6
# #define SPI3_SDI_PIN         PB4
# #define SPI1_SDO_PIN         PA7
# #define SPI3_SDO_PIN         PB5
# #define ADC_VBAT_PIN         PC0
# #define ADC_CURR_PIN         PC1
# #define ADC_RSSI_PIN         PC5
# #define PINIO1_PIN           PC15
# #define PINIO2_PIN           PC13
# #define FLASH_CS_PIN         PB6
# #define GYRO_1_EXTI_PIN      PC4
# #define GYRO_2_EXTI_PIN      PC14
# #define GYRO_1_CS_PIN        PA4
# #define GYRO_2_CS_PIN        PA15
#
# #define TIMER_PIN_MAPPING \
#     TIMER_PIN_MAP( 0, PB0 , 2,  0) \
#     TIMER_PIN_MAP( 1, PB1 , 2,  0) \
#     TIMER_PIN_MAP( 2, PB10, 1,  0) \
#     TIMER_PIN_MAP( 3, PB11, 1,  1) \
#     TIMER_PIN_MAP( 4, PC8 , 2,  0) \
#     TIMER_PIN_MAP( 5, PC9 , 2,  0) \
#     TIMER_PIN_MAP( 6, PA8 , 1,  0) \
#     TIMER_PIN_MAP( 7, PB7 , 1,  0) \
#     TIMER_PIN_MAP( 8, PA0 , 2, -1)
#   (2nd arg = occurrence index of that pin in BF fullTimerHardware[]:
#    PB0 -> TIM1_CH2N(1) TIM3_CH3(2); PB1 -> TIM1_CH3N(1) TIM3_CH4(2);
#    PC8 -> TIM3_CH3(1) TIM8_CH3(2); PC9 -> TIM3_CH4(1) TIM8_CH4(2);
#    PB7 -> TIM4_CH2(1); PA0 -> TIM2_CH1(1) TIM5_CH1(2) per timer_stm32f4xx.c l.63/75. dma -1 = none)
#
# #define SPI1_TX_DMA_OPT      0
# #define SPI1_RX_DMA_OPT      0
# #define SPI3_TX_DMA_OPT      0
# #define SPI3_RX_DMA_OPT      0
# #define ADC1_DMA_OPT         1
#
# #define DEFAULT_DSHOT_BITBANG       DSHOT_BITBANG_OFF
# #define DEFAULT_DSHOT_BURST         DSHOT_DMAR_OFF
# #define DEFAULT_DSHOT_TELEMETRY     DSHOT_TELEMETRY_ON
# #define DEFAULT_BLACKBOX_DEVICE     BLACKBOX_DEVICE_FLASH
# #define DEFAULT_CURRENT_METER_SOURCE CURRENT_METER_ADC
# #define DEFAULT_VOLTAGE_METER_SOURCE VOLTAGE_METER_ADC
# #define DEFAULT_VOLTAGE_METER_SCALE 110
# #define BEEPER_INVERTED
# #define SYSTEM_HSE_MHZ              8
# #define GYRO_1_SPI_INSTANCE         SPI1
# #define GYRO_2_SPI_INSTANCE         SPI1
# #define GYRO_1_ALIGN                CW270_DEG_FLIP   // provisional: bench-verify
# #define GYRO_2_ALIGN                CW0_DEG_FLIP     // provisional: bench-verify
# #define FLASH_SPI_INSTANCE          SPI3
# #define BARO_I2C_INSTANCE           I2CDEV_1
# #define MAG_I2C_INSTANCE            I2CDEV_1
# #define PINIO1_CONFIG               1
# #define PINIO1_BOX                  40
# #define PINIO2_BOX                  41
# #define SERIALRX_UART               SERIAL_PORT_USART2
# #define SERIALRX_PROVIDER           SERIALRX_CRSF
# #define DEFAULT_RX_FEATURE          FEATURE_RX_SERIAL
# #define GPS_UART                    SERIAL_PORT_USART3
# #define ESC_SENSOR_UART             SERIAL_PORT_UART4
# #define MSP_DISPLAYPORT_UART        SERIAL_PORT_USART1
