FallenFireGit/F405-FC/(commit log)

2026-10-10 Scaffold F405-FC project: requirements and KiCad generator toolchain
2026-10-10 Gate 0: pin map, Betaflight config, power design, pin-map audit, datasheets
2026-10-11 gen: KiCad library paths configurable via KICAD_SYMBOL_DIR/KICAD_FOOTPRINT_DIR; add TPS54360 (non-B) datasheet
2026-10-11 Gate 0 rev C: LMR38020 power rev B, analog OSD dropped (not at DigiKey), VTX switch via buck EN, INAV target, sourcing, decisions
2026-10-11 Gate 0: pin-map re-audit PASS + minor fixes; power audit P0 fixes (board thermal model, 2S 10V deviation, input caps, USB inrush); circuit model, ERC-clean schematic, netlist check, custom footprints
2026-10-11 WIP: PCB build script, placement draft, DRC summary tool, schematic PDF
2026-10-11 Gate 1 fixes (crystal gm evidence, LDO output ESR, X7R caps, 50V HF cap, per-MPN datasheets, in_bom flags, project-file merge, parity fields), power re-audit fixes (board-level thermal envelope, USB 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
2026-10-12 Gate 0 complete (power re-audit round 3 PASS); Gate 1 MCU crystal fix (8.2 pF loads, ECX-32 C0 evidence); net classes; staged board build; routing pipeline; placement renders; raw BOM
2026-10-12 Power doc: re-audit round-3 MINORs (bench envelope, two-point thermal gate, LP38692 stability risk + fallback, refdes/BOM drift, U1 HS-short and JST-pin risks)
2026-10-12 Gate 2 sourcing: apply DigiKey drop-in replacements (G2S-01/02/03/09), PN corrections, regenerate BOM; sourcing report and DigiKey BOM CSVs
2026-10-12 Gate 2 footprints: report + fixes (LMR paste windows/solid zone connect, USB-C edge offset), D-18; crystal series caveat
2026-10-12 WIP Gate 3 rework: pin-anchored placement, tight legalizer, placecheck; WE-MAPI 4020 inductors, GRM32DR input caps
2026-10-12 Gate 3 rework: clean placement (0 courtyard/copper DRC, placecheck PASS), 10 V budget 1.3 A with 4020 inductors, D-19
2026-10-12 Gate 2 re-check: report + fixes (TDK 4.7uF 100V bottom input caps, PNs, BOM regenerated $175.73, inductor keepouts), D-20
2026-10-12 Routing prep: scripted critical buck/VBAT routes (gen/critical.py), BST caps rotated, DRC position helper
2026-10-12 Routing infrastructure: DRC rules persisted to .kicad_pro, GND fanout (gen/gndfan.py), In1 kept signal-free in DSN, output script, assembly/bring-up guide draft
2026-10-12 Routing: MCU inward fanout, rip-up-and-reroute finisher (gen/ripup.py), maze router, geometry export/apply, provisional IMU alignment + FRONT silk
2026-10-12 Routing: PathFinder router, reachability pre-check, fanout stub crossing fix + IMU via keepout
2026-10-12 PathFinder: conservative grid margins, string pulling, cost-based window choice, optional In1 hops; power.md §5 rev C; current-limit floors in script (G3R-08)
2026-10-12 Placement tweaks for routability (U5/C23/C53/R21/R22), pairwise clearance + hole clearance in router, GND plane-tie pass, route pipeline script
2026-10-12 D-23: ADC clamp diodes removed (routing space under the MCU corner); BOM $174.68; PathFinder RESET_NETS
2026-10-13 Routing: PathFinder router, fine grid + In1 hops, GND pass, solid SMD pour connections (WIP: 2 DRC errors, 26 opens)
2026-10-13 Routing cleanup tooling: GND pass ties to tied copper, gndfan stub-vs-via check, prune step, tighter pours; docs updates
2026-10-13 Fix 10 V buck VBAT feed: In2 riser to three vias on the U2 input track (old trunk vias were commented out / under MCU pins); gndfan keeps GND vias out of the VBAT zone; faster GND pass; prune keeps u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
2026-10-13 Router: GND ties may claim via sites and renegotiate overlapping signal nets (gnd_force); board with fixed VBAT feed
2026-10-13 Router: GND ties limited to pads in untied pour fragments (gen/gndneed.py, GND_NEED)
2026-10-13 Router checkpoint: route_all.json during GND-tie renegotiation
2026-10-13 Router checkpoint (GND-tie renegotiation pass 2)
2026-10-13 Gate 6 Betaflight red team: report + fixes (USB-only DFU procedure, J3 'VTX 10V' silk + 10 V warning, battery-before-USB, cold-boot gyro check, D-23 clamp text, bl note, driver/build notes)
2026-10-13 Router: one GND tie per untied pour fragment (gndneed groups); checkpoint
2026-10-13 Restore converged route set (VBAT fix); GND-tie renegotiation continues in a scratch run
2026-10-13 Router: forced GND ties pay via congestion at the goal and are re-placed when in conflict (negotiable ties)
2026-10-13 Router: GND_FIXED places GND ties from an earlier run before a fresh signal route
2026-10-13 GND pours: 0.127 mm clearance / min width (class clearances still apply); 21 GND fragments left on the converged route set
2026-10-13 Gate 6 smoke fixes (router/board): power nets outer layers only, no vias in own SMD pads, hole keepouts block pours; negotiation knobs (PRES_GROW/PRES_MAX/HIST_INC/GND_PRES)
2026-10-13 Gate 6 smoke red team: report + guide fixes (two-step Stage A, divider check, 6.5 V first power, stop criteria, R14-R16, P2 as GND, P3/P4 note); power.md rev C copper notes
2026-10-13 D-24: unused-pin pulldowns R21-R24 removed (routing space under the MCU); schematic regenerated (ERC 0, netcheck OK), BOM 119 placements, est. $173.28
2026-10-13 Pre-route board rebuilt (D-24 placement, unchanged geometry)
2026-10-13 Placement: GYRO2_CS / FLASH_CS pull-ups R19/R20 moved off the MCU top-row escape corridor; freespots window listing
2026-10-13 Pre-route board rebuilt (U13 move tried and reverted: overlaps J1)
2026-10-13 Router: MCU pin escape lanes closed to other nets' vias
2026-10-13 Pre-route board rebuild (R16 move tried, reverted)
2026-10-13 Freerouting finishing step (gen/fr_finish.sh, route.py lockall stage)
2026-10-13 Board checkpoint during Freerouting finish
2026-10-13 Placement: I2C pull-ups R25/R26 moved west next to the sensors (routing); rexport includes NPTH holes; Freerouting finish attempt failed (documented)
2026-10-13 Converged signal routing (alt15) checkpoint; router hole clearance margin; solid pour connections on all pads
2026-10-13 Router: all GND ties renegotiable; gnd_need recomputed on the converged signal routing (32 fragments)
2026-10-13 Schematic PDF regenerated (rev C incl. D-24)
2026-10-13 Readable schematic: functional blocks with titles, passives wired to their IC pins, GND power symbols, per-rail decoupling banks, labels only between blocks (ERC 0, netcheck OK, same nets)
2026-10-13 Router: GND ties reloaded on resume stay renegotiable
2026-10-13 Routing nearly closed: finisher (gen/pffinish.py) on best negotiation state, 3V3_IMU/3V3A to Default class (<=10 mA). DRC: 2 clearance (5 um), 3 GND islands, parity 0
2026-10-13 Router: forced GND ties may end on already-tied GND copper; finisher caps routing-order tries
2026-10-13 gen/pflocal.py: local GND-island repair (rip a few nets, strict GND ties, re-route with widening)
2026-10-13 pflocal: keep best partial state, WIDEN switch
2026-10-13 Routing closed: DRC 0 errors / 0 unconnected / 0 parity (warnings: 17 unused fanout vias, 26 silk overlaps)
    Final route set from the GND-tied local repair (gen/pflocal.py) plus one PathFinder resume; power-track necking for
    two 5 um clearance misses is now part of gen/route_finish.sh (drcfix NARROW_ONLY).
2026-10-13 Track tidy-up (gen/tidy.py): string-pulled chains, 4005 -> 1651 segments; DRC 0 errors / 0 unconnected / 0 parity
2026-10-13 Release outputs: JLC gerbers+drill zip, stencil, CPL, iBOM, schematic PDF, STEP, renders; BF/INAV configs in docs/
2026-10-13 Design history video (14 board revisions + final turntable, 13.9 s)
2026-10-14 Gate 4 SI/PI review (FAIL) and Gate 5 fixes in progress
    - review/gate-4-si-pi.md: fresh SI/PI review, 1 BLOCKER (C37 legalized 7.9 mm from Y1), 4 MAJOR
    - C37 re-anchored beside Y1 (3.3 mm pad-to-pad), placecheck rules for C36/C37
    - gen/vianudge.py: pull vias >= 0.10 mm off their own SMD pads before the pours (Gate 5 M-3)
    - J1 shell slots on thermal reliefs (M-1); labels kept off connector bodies, far-side
    fallback, board name/revision mark (M-5, m-4); Pad_SMD silk rings dropped (m-3)
    - BOM: Y1 DigiKey PN filled; C2/C3/C10/C11 PN note; L1/L2 PN still unconfirmed
2026-10-14 Assembly guide: one bottom-side hot-plate pass, J1 shell soldering, fab order settings (Gate 5 M-2, M-1, m-5..m-7)
2026-10-14 WIP: router checkpoint during C37 re-route (board file unchanged)
2026-10-14 Rev D toolchain: 6-layer stackup (F / In1 GND / In2 sig / In3 sig+VBAT / In4 GND / B)
    In1 and In4 are solid GND planes that are never routed (Gate 4 G4-02); the router uses F/In2/In3/B.
    VBAT riser zone moves to In3. reachcheck joins every routing-layer pair (was hard-coded to 3).
2026-10-14 Ignore the local-repair scratch result kicad/route_best.json
2026-10-14 pathfinder: per-net layer cost overrides (NET_LCOST) for pin-order crossings
2026-10-14 WIP rev D: 6-layer board, all signals routed (0 conflicts), GND ties in progress
    DRC on this snapshot: 28 unconnected (all GND pour fragments, being tied), 4 sub-5 um clearance misses
    (GYRO2_CS at D5), 1 starved thermal (J1 shell, B.Cu). fab/ and docs/ outputs still describe rev C.
2026-10-14 Rev D: GND fanout vias placed before routing (signals route around them); skip U8.5
2026-10-14 Rev D placement: U7 (BMI270) 1.6 mm in from under the MCU right pin row, C38 below U6
    The MCU right-row escape vias all fell inside the BMI270 footprint; the router could not close there.
    Orientation unchanged (gyro alignment unchanged). placecheck PASS, reachcheck 0 unreachable.
2026-10-14 pathfinder: PWR_OUTER_EXEMPT lets a named power net use the inner layers (with NET_LCOST penalties)
2026-10-14 Rev D placement: U11 video switch beside its video pads, out from under Y1
    The pocket between Y1, U11 and the MCU left pin row could not hold the CAM_SEL / VBAT_ADC / 3V3 vias.
    placecheck PASS, reachcheck 0 unreachable.
2026-10-14 Rev D: board rebuilt from the converged 6-layer route (WIP: 3 GND islands, 1 clearance, 1 thermal)
    - gen/geomreplay.py: the finished board replays the router's fixed copper from kicad/route_geom.json
    (gndfan plans differ run to run; re-planning put GND vias on routed signals). route_geom.json is now tracked.
    - tidy: split router T-junctions, snap near-vertex branch ends, and keep a net as routed when tidying
    would split it (connectivity check); vianudge hole spacing 0.25 mm (board rule).
    - DRC on this snapshot: 0 shorts, 0 parity; 3 unconnected (GND pour fragments at U3.18, U3.63, U8.5 being tied),
    1 clearance 0.124/0.127 (BEEPER via / BUZ_G), 1 starved thermal (J1 shell, B.Cu).
2026-10-14 Rev D: fixed FLASH_CS escape stub + via at U3 pin 58 (pin-order crossing with SPI3_MISO)
2026-10-14 Rev D placement: R20 (FLASH_CS pull-up) to the bottom between U3 pin 58 and U10; drop the colliding hand-placed escape via
    The hand-placed FLASH_CS via overlapped a fixed GND via and C22 (fixed-vs-fixed, unseen by the router).
    rexport 0 violations, placecheck PASS, reachcheck 0 unreachable.
2026-10-15 Rev D placement: R18 (GYRO1_CS pull-up) to the bottom beside U6
    Its top-side position forced GYRO1_CS across 3V3 at MCU pin 19. rexport 0 violations, placecheck PASS, reachcheck 0.
2026-10-15 WIP rev D routing checkpoint: all nets routed, 1 conflict left (I2C1_SCL/I2C1_SDA vias above U3 pins 61/62)
    Two GND islands (U3.18, U8.5) still untied; the U3.63 tie is in. Not yet applied to the board file.
2026-10-15 Rev D placement: U8 (BMP390) 1.2 mm right with C43/C44, opening the strip above U3 pins 61-63 for the I2C vias
    Kept 0.3/0.6 mm vias (owner decision). U8's GND fanout re-planned; rexport 0 violations, placecheck PASS, reachcheck 0.
2026-10-15 Placement freeze: kicad/placement_frozen.json pins every part to the last routed board; placement.UNFREEZE names the parts allowed to move
    A local placement change no longer re-runs the legalizer over the neighbours (it moved C18, R12, TP5 under fixed copper).
2026-10-15 Rev D top re-plan: SWD test pads to the top-right corner, U5/C22/C23 into the freed space above, out of the via strip over U3 pins 49-64
    TP1-TP3 (SWDIO/SWCLK/NRST) by the SWD pins; TP4 (3V3) and TP5 (GND) to free spots by the MCU left edge.
    Stale fixed GND copper in the moved areas dropped (re-tied by the router GND pass).
    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
2026-10-15 WIP rev D: 6-layer routing near-closed (escape lanes off, ESC_TLM fanout freed)
    DRC: 2 clearance (VCAP2 vs 5V via, USB_CC2 vs GND via 0.119), 1 starved thermal (J1 shell B.Cu), 2 unconnected, 0 parity.
2026-10-15 WIP rev D: VCAP2/5V conflict re-routed; USB_CC2 GND fanout via nudged 0.03 mm
    DRC before this tie run: 1 clearance (USB_CC2/GND via, fixed in route_geom.json, not yet rebuilt), 1 starved thermal (J1 B.Cu),
    2 unconnected (GND at U3.18 and J3.2: forced GND tie run in progress), 0 parity.
2026-10-15 Rev D: DRC rule accepting one resolved thermal spoke on the J1 USB-C shell slots
2026-10-15 Schematic regenerated for the L1/L2 WE-MAIA MPN (ERC 0, netcheck OK)
2026-10-15 Rev D (6-layer): routing closed - DRC 0 errors, 0 unconnected, 0 parity
    - U3.18 and J3.2 GND islands tied (forced tie + local GYRO1_CS re-route; U3.18 tied by a hand dog-leg to a free via site)
    - USB_CC2 GND fanout via nudge applied; J1 shell thermal: one resolved spoke accepted by kicad/F405FC.kicad_dru
    - octilinear tidy applied; remaining warnings: 16 dangling vias, 4 silk overlaps
2026-10-15 Rev D: fab outputs (6-layer Gerbers, drill, stencil, CPL, STEP, renders, iBOM); TP labels clear the TP rings; board mark rev D
    DRC: 0 errors, 0 unconnected, 0 parity; warnings: 16 dangling vias, 1 silk overlap (C44/U8). placecheck PASS.
2026-10-15 Rev D docs: guide stackup/board text for 6 layers; D-27 completed with the later placement and routing changes
2026-10-15 Rev D review fixes (docs/BOM/config): Gate 5 G5D-01/02, Gate 6 G6B-02/04/07/08 and minors
    - DigiKey upload BOM and bom_raw: L1/L2 WE-MAIA 78438356056 / 732-11317-1-ND (G5D-01); D-26 M-4 closed, land pattern still unverified
    - guide Stage B fits R17 (BOOT1), R19, R34/R35 (CC), R36/C51 before DFU; USB-only test moved into Stage B; unpowered BOOT0/BOOT1/CC
    resistance checks; step numbering; R6 VBAT bridge warning at J1; J1 six layers; top paste on a carrier or syringe, preheat; via
    counts from the rev D Gate 5; C53 named as RSSI filter; front mark; pre-flight checks (blackbox, motors, OSD, LED, beeper, ADC, PINIO modes)
    - Betaflight config: baro_hardware BMP388, mag_hardware LIS2MDL (names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
2026-10-15 Rev D: Gate 4 MAJOR re-route, Gate 6 front mark, smoke red-team guide fixes; outputs regenerated
    - G4D-02: router-only AVOID boxes keep foreign nets off B.Cu inside the U1/U2 buck footprints; SPI1_MOSI, LED_DIN, MOTOR8
    re-routed out of them
    - G4D-01: CURR_ADC re-routed 70.4 mm / 3 vias -> 16.7 mm / 2 vias
    - G6B-01: board front marked by silk arrows (FRONT at the J3 edge on the bottom, FWD on the top); G6B-03: P6/J5 labels placed
    (0.8 mm, footprint silk now an obstacle), docs/config name the marks
    - G6S-11: LDOs first powered at 3.6 V / 30 mA on 5V_SYS before 8.4 V; G6S-12 rail-to-rail checks; G6S-14 ESC harness check
    - G6S-19: power.md (VBAT zone on In3, BAT54S removed, rev D), schematic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
2026-10-15 review/summary.md: draft (gate outcomes, BOM cost, residual risks, not verified); rev D re-review results pending
2026-10-29 Add README with board renders and specs
